olerast67/emotion-keychain/docs/hardware.md

[English](hardware.en.md) | Русский

# Железо и конструкция

Брелок rev B — это своя плата 30 × 46 мм с ушком для кольца, модуль экрана 0.96″ над ней на ушках акриловых рамок и ячейка Li-Po между ними. Всё вместе закрыто прозрачным акриловым «бутербродом». Здесь — что стоит на плате и почему. Как собрать и заказать плату — в [README платы](../hardware/rev-b/README.md), корпус — в [README корпуса](../hardware/rev-b/case/README.md), ток и автономность — в [энергобюджете](power.md).

| Вариант | Что внутри | Статус |
|---|---|---|
| **A** | Стандартный модуль SSD1306 + плата-носитель с Seeed XIAO nRF52840 Sense | ранний план прототипа; не делался, запасной путь |
| **B** | Стандартный модуль SSD1306 + своя плата: модуль nRF52840, зарядник, датчики | **rev B готова к заказу** — [`hardware/rev-b`](../hardware/rev-b/README.md) |
| **C** | Одна своя плата с голой панелью экрана на разъёме FPC | rev C в [плане](plan.md): полностью заводская сборка |

Вариант A пропустили: прошивку платы rev B целиком проверяет [симуляция платы](../firmware/README.md#симуляция-платы-целиком), а лица на живой панели — стенд на ESP32.

## Плата rev B

Плата rev B: лицевая сторона и оборот

| Параметр | Rev B |
|---|---|
| Размер | 30 × 46 мм и ушко R4.5 с отверстием 3.2 мм без металлизации, 4 слоя, 1.6 мм, ENIG, чёрная маска |
| Слои | L1 и L4 — детали и сигналы, L2 — сплошная земля, L3 — шины питания 0.4/0.3 мм и медленные сигналы |
| Микроконтроллер | модуль Raytac MDBT50Q-1MV2 (nRF52840) с чип-антенной у правого края, без меди под ней |
| Питание | MCP73832 (100 мА, заряд разрешает прошивка), разделение USB и батареи на диоде и P-MOSFET, 3.3 В от REG0 модуля |
| Защита USB | TVS SMF5.0A на VBUS (от импульсов и статики), USBLC6 на D+/D− |
| Датчики и отдача | LIS3DH, LTR-303ALS, PDM-микрофон SPH0641, пищалка PKMCS0909E, вибромотор на ключе, боковая кнопка |
| Связь и отладка | USB-C с CC-резисторами, площадки Tag-Connect TC2030 для SWD |
| Экран | модуль 0.96″ по I2C над ячейкой, на ушках рамок корпуса, питание через ключ |
| Ячейка | 402025, 502025 или 602025 с платой защиты — версии корпуса S, M, L |
| Проверка | DRC — 0 ошибок, 0 несоединённых, 0 предупреждений; прошивка прогоняется в симуляции платы целиком |

### Цели

| Цель | Сейчас |
|---|---|
| Автономность ≥5 дней при 16 ч лица и 8 ч темноты в сутки | по симуляции ≈3, ≈4.3 и ≈5.4 дня в версиях S, M, L; обычный день — 11–18 дней ([энергобюджет](power.md)) |
| Зарядка от USB-C током не выше 1C | 100 мА — не больше 0.7C при номинальной ёмкости 150–250 мА·ч, только при 10–42 °C |
| Падение с 1–1.5 м, рывок за ушко 5–10 кг, брызги | тесты впереди (этап 7 [плана](plan.md)) |

### Ножки и шины

| Сигнал | Ножка | Куда |
|---|---|---|
| SENS_SDA, SENS_SCL | P0.27, P0.01 | шина датчиков (Wire): LIS3DH 0x19, LTR-303 0x29, подтяжки 10 кОм |
| ACC_INT1, ACC_INT2 | P0.04, P0.17 | прерывания LIS3DH: касание (CLICK) и запасное |
| ALS_INT | P0.00 | прерывание LTR-303 |
| PDM_CLK, PDM_DATA, MIC_PWR | P0.06, P0.08, P1.09 | микрофон; питание — с ножки, выключается целиком |
| DISP_SCL, DISP_SDA | P0.13, P0.15 | своя шина экрана (Wire1), SSD1306 на 0x3C или 0x3D |
| DISP_EN | P0.19 | ключ питания экрана, высокий — включён |
| VIB_EN | P0.21 | ключ мотора, ШИМ 20 кГц |
| CHG_IO | P0.20 | статус зарядника, 0 — заряжается |
| CHG_EN | P0.24 | разрешение заряда: 0 — заряд, отпущена — без заряда |
| BTN | P0.22 | кнопка на землю |
| BUZ_A, BUZ_B | P0.25, P1.02 | пищалка мостом через 1 кОм |

Обе шины I2C работают на 390 кГц: на 400 кГц TWIM nRF52840 нарушает тайминги (errata 219). Кварца 32 кГц нет, часы идут от внутреннего RC-генератора, поэтому P0.00 и P0.01 — обычные ножки. Номера ножек записаны в `GPIO` из [`netlist.py`](../hardware/rev-b/gen/netlist.py) и в [`board.h`](../firmware/src/keychain/board.h) прошивки.

## Микроконтроллер: nRF52840

Лицо горит постоянно, а процессор почти всё время ждёт следующего кадра или события. Поэтому важнее всего ток в паузах, а не пиковая производительность.

- **nRF52840:** ожидание с таймером и сохранением RAM — 1.5–2.4 мкА, при работе на 64 МГц — около 3.3 мА. Есть FPU, PDM-интерфейс для микрофона и BLE для встреч брелоков.
- **ESP32-C3** в лёгком сне берёт 130–190 мкА, это в 50–100 раз больше. FPU у него нет. Остаётся запасным вариантом, если понадобится Wi-Fi.
- **Модуль, а не голый чип.** В MDBT50Q-1MV2 уже есть антенна, кварц 32 МГц и обвязка регуляторов. Своя антенна на плате 30 мм — лишний риск.
- **Питание модуля.** VDDH берёт питание системы (VSYS, 2.5–5.5 В), а встроенный регулятор REG0 выдаёт 3.3 В на VDD для модуля и датчиков. Отдельный LDO не нужен: нагрузка 3–4 мА при пределе REG0 25 мА. На чистом чипе REG0 даёт 1.8 В; 3.3 В записывает в UICR заводской файл прошивки или загрузчик.
- **Ёмкость на VDD** — 4.7 мкФ и четыре по 100 нФ, всего 5.1 мкФ: Nordic для REG0 допускает не больше ~5.5 мкФ.
- **USB** — встроенный в nRF52840: диск KEYCHAIN для обновления прошивки, консоль. По выводу VBUS модуль узнаёт, что USB подключён.

## Экран

- **Белый SSD1306 0.96″, стандартный модуль на 4 штыря I2C.** Белая панель стареет медленнее голубой.
- **Почему I2C, а не SPI.** Модули на 4 штыря — самые распространённые, а движок шлёт на экран только изменённые окна. На 400 кГц полный кадр (1 КБ) идёт ≈23 мс, окно двух глаз (~256 Б) ≈6 мс — для лица этого хватает. Выше 400 кГц не поднять: этого не поддерживают ни интерфейс nRF52840, ни контроллер дисплея.
- **Своя шина и ключ питания.** У экрана своя шина Wire1, а питание идёт через P-MOSFET Q2 от VSYS. Прошивка выключает экран целиком, а не только гасит его: чёрный, но включённый экран берёт 0.5–1.4 мА. Перед выключением ключа прошивка отпускает SDA и SCL, чтобы модуль не подпитывался через подтяжки. Конденсатор между затвором и стоком Q2 включает ключ плавно, без большого броска тока.
- **Модули с маркетплейсов не одинаковые.**
  - Под видом SSD1306 бывают SH1106 (сдвиг на 2 столбца и мусор у края) и SSD1315. Прошивка платы ждёт SSD1306; адрес 0x3C или 0x3D она находит сама.
  - Порядок питания на штырях бывает `GND VCC` и `VCC GND`. Его выбирают перемычки 0 Ом R16–R19 на обороте: завод ставит вариант `GND VCC`.
  - Модуль нужен с LDO на плате (662K / XC6206): на него приходит VSYS, а это до ~5.4 В от USB.
  - Поэтому покупаем у 2–3 продавцов и сверяем размеры, контроллер и распиновку до пайки. Контроллер по надписям не узнать: модуль проверяют на стенде ESP32 ([как](../hardware/rev-b/README.md#что-сверить-перед-заказом)).
- **Яркость около 60 кд/м²**, на солнце лицо читается хуже. Прошивка ставит контраст по уровню из поведения: обычный, 1/4 ночью и во сне, 1/16 в темноте.

## Датчики

| Что | Деталь | Как подключена | Зачем |
|---|---|---|---|
| Движение | LIS3DH, акселерометр ±4 g | шина датчиков, 0x19 (SA0 на VDD), касания — на INT1 | тап и двойной тап, тряска, падение, переворот, шаги, наклон взгляда |
| Звук | SPH0641LM4H-1, PDM-микрофон с портом снизу | звук — через отверстие 0.5 мм в плате и 1.2 мм в крышке корпуса; питание с ножки | «слушает», испуг от хлопка, музыка, речь |
| Свет | LTR-303ALS | шина датчиков, 0x29, смотрит вперёд | яркость экрана, темнота в кармане, ночь |
| Кнопка | Omron B3U-3100P, боковая | на правом торце, толкатель в корпусе | включение, выключение, дуэли (два нажатия), звук (три нажатия), загрузчик |
| Температура | датчик кристалла nRF52840 | внутри модуля | холодно, жарко; можно ли заряжать |
| Батарея | делитель VDDHDIV5 внутри nRF52840 | без внешних деталей | процент заряда, экорежим, выключение на пустой ячейке |

- **SA0 акселерометра — на VDD.** У этого вывода внутренняя подтяжка к VDD. На земле через неё всё время, даже в выключенном брелоке и в загрузчике, шло бы 0.11–0.16 мА — столько же, сколько весь брелок в кармане. Прошивка ещё и отключает подтяжку (CTRL_REG0 = 0x90).
- **Датчик света смотрит вперёд**, туда же, куда экран: на сумке задний датчик видел бы только ткань. Он меряет разово, раз в 2 с.
- **Микрофон** слушает, только пока брелок бодрствует: в кармане, ночью и в экорежиме его питание выключено. Свою пищалку и свой мотор микрофон не слышит: пока они работают и 150 мс после, звук не считается. Толчки своего мотора — не касания: пока он работает и 150 мс после, тряска, удар, падение и касания не считаются.

### Звук и вибро

| Что | Деталь | Как подключена | Ток |
|---|---|---|---|
| Пищалка | пьезо PKMCS0909E 9×9 мм без генератора | мостом на двух ножках через 1 кОм: в противофазе громко, с одной ножки тихо | 0 в покое, единицы миллиампер во время звука |
| Вибромотор | монетка 0820 (Ø8 × 2 мм, 3 В), на клейком слое | ключ AO3400A с диодом от VSYS, ШИМ 20 кГц со скважностью 3 В / VSYS | 0 в покое, ~60 мА импульсами по 50–200 мс |

Звук и вибро короткие и редкие, на средний ток почти не влияют. Движок выдаёт ноты (`sound.h`), прошивка играет их ШИМом. Подробно — в [голосе брелока](sound.md).

## Питание

- **Ячейка Li-Po 20 × 25 мм с платой защиты (PCM):**
  - 402025 — ~150 мА·ч, 4 мм, версия S;
  - 502025 — ~200 мА·ч, 5 мм, версия M;
  - 602025 — ~250 мА·ч, 6 мм, версия L.

  Ёмкость на этикетке дешёвых ячеек часто завышена, а толщина — больше номинала. Перед покупкой партии смерьте образец, ёмкость проверьте разрядом. В паспорте ячейки максимальный ток заряда — не меньше 100 мА ([паспорт ячейки](../hardware/rev-b/case/README.md#как-выбрать-ячейку)). Правило толщины — в [README платы](../hardware/rev-b/README.md#стек-и-размеры). Провода ячейки паяются на площадки, разъёма нет. Защиты от переполюсовки на плате тоже нет, поэтому ячейка — только с платой защиты.
- **Зарядка — MCP73832, 4.2 В, 100 мА:** при номинальной ёмкости 150–250 мА·ч это не больше 0.7C.
  - Входа термистора у MCP73832 нет. Поэтому нижний конец резистора PROG идёт на ножку nRF (CHG_EN), и заряд включает прошивка: только при температуре кристалла 10–42 °C, с остановкой ниже 7 °C и выше 45 °C. Проверка — при подключении USB и дальше раз в 30 с.
  - Почему запас у холода такой большой. На морозе литиевую ячейку заряжать нельзя: литий оседает на аноде, и ячейка портится. А датчик кристалла по документации Nordic ошибается до ±5 °C, и на USB кристалл ещё на несколько градусов теплее ячейки: его греют зарядник и сам nRF. Порог 10 °C по кристаллу держит ячейку дальше от нуля даже при худшей ошибке. Гарантию даст только термистор у ячейки — он в rev C. У жары кристалл ошибается в безопасную сторону: он теплее ячейки.
  - Без прошивки заряда нет, а брелок при этом питается от USB.
  - Статус заряда приходит на ножку через делитель 10 кОм / 47 кОм: «1» не выше 3.3 В при VBUS до 5.5 В.
  - Слабый USB, ниже ~4.6 В на VBUS: «1» может не дотянуть до порога ножки, и законченный заряд прошивка читает как «заряжается». Это только видимость: сцена «заряжен» не появится, а сам зарядник заканчивает заряд правильно. Конец заряда видно по светодиоду.
  - Плата без прошивки на USB (VDD 1.8 В): «1» выше предела ножки VDD + 0.3 В, в её защитный диод через R5 идёт до ~0.13 мА. Это длится только до первой прошивки, которая ставит 3.3 В, и ножке не вредит; непрошитую плату на USB надолго не оставляют.
- **Разделение питания USB и батареи.** От USB система питается через диод Шоттки (VSYS до ~5.4 В), от батареи — через открытый P-MOSFET почти без потерь. Отдельного ключа нагрузки и LDO нет: экран отключает свой ключ, 3.3 В даёт REG0.
- **USB-C:** резисторы 5.1 кОм на CC, USBLC6 — от статики на линиях данных.
  - **TVS SMF5.0A на VBUS** — от импульсов и статики: пробой 6.4–7.1 В.
  - **Звон при горячем подключении он не гасит.** Индуктивность короткого кабеля с керамикой на VBUS звенит, и по модели ngspice VBUS и VSYS на короткое время уходят выше предела модуля 5.8 В (VBUS и VDDH). Так бывает с коротким толстым кабелем от зарядника, у которого 5 В на гнезде есть всегда (USB-A); зарядник USB-C с кабелем C–C включает 5 В плавно и только после подключения. TVS начинает проводить выше этого предела. Лечится это демпфером у разъёма — RC-цепочкой или конденсатором с потерями ~0.5–1 Ом и ≥10 мкФ; он в плане rev C. Одних 10 Ом перед выводом VBUS модуля мало: VDDH и зарядник они не защищают.
  - **Проверка на первой плате:** осциллограф на VBUS и VSYS, горячее подключение коротким кабелем ([как](../hardware/rev-b/README.md#на-первых-платах)). Для своих прототипов rev B риск принят; перед продажей замер обязателен.
- **Выключение — полное:** System OFF, датчики в сне, микрофон и экран обесточены. Брелок в нём берёт 6–17 мкА по типовым значениям даташитов; предел на проверке первой платы — 25 мкА.

## Конструкция

### Стек, вид сбоку (спереди назад)

```
  ┌─ ушко: выступ платы над модулем экрана, датчик света на его лицевой стороне
  ▼
[ крышка: прозрачный акрил ]
[ стекло OLED ]                                      ← модуль 0.96", ≈4 мм вместе с платой
[ плата модуля ]
   ║ штыри 2.54 мм сквозь плату       ║ ушки двух рамок ячейки: 6, 7 или 8 мм (S, M, L)
[ ячейка 402025 / 502025 / 602025 на тонком двустороннем скотче ]   ← в рамке из акрила
[ плата rev B, FR4 1.6 мм, чёрная маска, ENIG ]
[ детали оборота: USB-C на нижнем торце, кнопка на правом, пищалка, мотор ]   ← в рамке оборота
[ дно: прозрачный акрил, отверстие Ø3 мм над пищалкой ]
```

Корпус — 35 × 51 мм (у кнопки рамка оборота выходит приливом на 0.8 мм, толкатель — ещё на 0.5 мм), слои акрила стянуты четырьмя нейлоновыми винтами M2 × 25. Толщина и раскрой каждой версии — в [README корпуса](../hardware/rev-b/case/README.md).

### Детали, которые важны для прочности

- **Ушко.**
  - Выступ платы из FR4 1.6 мм, полукруг R4.5, отверстие 3.2 мм под разъёмное кольцо, без металлизации: кольцо держится на самом стеклотекстолите, до края ≈2.9 мм материала.
  - Вокруг отверстия в радиусе 3 мм нет меди ни на одном слое, чтобы кольцо ничего не замкнуло и не истёрло.
  - Проверка: рывок 5–10 кг (этап 7 [плана](plan.md)).
- **Ячейка** закрыта со всех сторон: сзади плата, спереди модуль экрана и прозрачная крышка, по бокам — рамки корпуса. У разъёма USB-C её торец закрывает нижняя рамка ячейки: окна под вилку в ней нет, вилка до ~6.4 мм проходит под рамкой ([вилка USB-C](../hardware/rev-b/case/README.md#слои-от-лица-к-обороту)). Острых выводов рядом быть не должно: ножки USB-C выходят на лицевую сторону прямо под ячейку, их откусывают, спиливают почти заподлицо и закрывают каптоном.
- **Шлейф экрана** на нижнем торце модуля — самое хрупкое место. Рамка экрана его не зажимает. При сборке шлейф закрывают узкой полоской каптона ([шаг 5 сборки](../hardware/rev-b/case/README.md#сборка)), капля UV-клея по краю стекла — по желанию. Нужно ли больше, решаем после тестов на падение (этап 7 [плана](plan.md)). В варианте C шлейф уходит под плату.
- **Кнопка** на правом торце (side-push), её нажимает толкатель из акрила с крыльями под платой: плата не даёт ему подняться и упереться в её край. **USB-C** на нижнем торце, корпус разъёма выходит за край платы на ~0.7 мм — в вырез корпуса.
- **Пищалка** звучит в дно, поэтому в дне против неё отверстие Ø3 мм. Брелок, который лежит на спине, звучит тише.
- **Отделка:** скруглённые углы R2, чёрная матовая маска, покрытие ENIG. Влагозащитное покрытие оборота (кроме разъёма, кнопки, отверстия микрофона и площадок программирования) и бампер для торцов стекла — решаем после тестов на брызги и падение.

## Как менялся план

Ранний план собирался до своей платы. Что на плате rev B вышло иначе:

| Было в плане | На плате rev B | Что из этого следует |
|---|---|---|
| Ячейка 20 × 30 мм, 250–400 мА·ч; брелок ≈27 × 33 мм | ячейка 20 × 25 мм, 150–250 мА·ч; плата 30 × 46 мм, корпус 35 × 51 мм | под модулем экрана 27 × 28 мм помещается ячейка 20 × 25, а модуль nRF, датчики и кольцо заняли верхние 18 мм. Автономность меньше ранних таблиц — см. [энергобюджет](power.md) |
| LIS2DW12, микрофон T5838 со своим детектором звука, NTC на ячейке | LIS3DH, PDM-микрофон SPH0641 с питанием от ножки, температура кристалла nRF | микрофон без детектора звука, поэтому в кармане и ночью он выключен. Температуру ячейки никто не меряет: заряд разрешается по температуре кристалла через CHG_EN. NTC и зарядник со входом термистора — в rev C |
| BQ25180 или MCP73831, LDO TPS7A02, ключ TPS22916 | MCP73832, REG0 модуля, ключ экрана на AO3401A и AO3400A | 3.3 В даёт REG0 (нагрузка 3–4 мА из 25); транзисторы ключа — базовые детали JLCPCB |
| Экран на SPI, 7 штырей | стандартный модуль I2C на 4 штыря | полный кадр ≈23 мс вместо ≈1 мс; движок шлёт только изменённые окна, и этого хватает |
| Передачи на экран через EasyDMA со сном ядра | Wire передаёт через TWIM (EasyDMA), но ядро ждёт конца передачи | сон ядра во время передачи — среди улучшений в [энергобюджете](power.md) |
| Металлизированное отверстие или латунная втулка в ушке | отверстие 3.2 мм без металлизации, вокруг нет меди | держит стеклотекстолит; проверка рывком впереди |
| Открытые платы без корпуса | акриловый «бутерброд» S, M, L | ячейка закрыта, платы видно насквозь |

## Закупки для сборки

| Что | Сколько | Зачем |
|---|---|---|
| Платы rev B со сборкой (JLCPCB или PCBWay) | у JLCPCB: PCB — 5 панелей (меньше не заказать), из них со сборкой 3 = 6 плат (PCBA — от 2 панелей) | монтаж заказывают панелями: 2 платы на панели 76 × 72 мм, «Panel by Customer» из `hardware/rev-b/out/panel`; номер заказа — «Order Number (Specify Position)», он ляжет под ячейку ([панель](../hardware/rev-b/README.md#панель-для-монтажа), [заказ](../hardware/rev-b/README.md#заказ-на-jlcpcb)) |
| Модуль OLED 0.96″ SSD1306, I2C, 4 штыря, **белый**, с LDO; порядок штырей `GND VCC` (`VCC GND` тоже подойдёт — тогда перепайка R16/R18, [шаг 2 сборки](../hardware/rev-b/case/README.md#сборка)); для M и L — без впаянной гребёнки | по 2–3 от 2–3 продавцов | экраны, проверка разброса модулей |
| Ячейки 402025, 502025 или 602025 с платой защиты | по 2 на брелок | под версию корпуса; толщину смерить до покупки партии |
| Вибромотор-монетка 0820, 3 В | по 1 на брелок | вибро |
| Винты M2 × 25 нейлоновые с цилиндрической головкой (DIN 84) и гайки M2 нейлоновые — для всех версий; нейлоновых M2 × 25 не найти — стальные M2 × 22 (S) или M2 × 25 (M, L), гайки нейлоновые; для брелоков на продажу — только нейлон | по 4 на брелок | стек и корпус; [что купить](../hardware/rev-b/case/README.md#что-купить) |
| Гребёнка 2.54 (для M и L длинная, от 15 мм), силиконовая трубка 1 × 2 мм | по [списку корпуса](../hardware/rev-b/case/README.md#что-купить) | экран и микрофон |
| Акрил под лазерную резку | по [списку корпуса](../hardware/rev-b/case/README.md) | корпус |
| Raspberry Pi Pico или Pico 2 (без W) — программатор с прошивкой debugprobe, ~$4–6 | 1 | первая прошивка по SWD, если завод не прошивает сам; [как](../firmware/README.md#основной-программатор-raspberry-pi-pico) |
| Модуль преобразователя уровней на TXS0108E, ~$1–2; провода Dupont до 10 см, кабель micro-USB с данными | 1 | между Pico (3.3 В) и платой (1.8 В до первой прошивки) — обязательно |
| Кабель Tag-Connect TC2030-CTX-NL и переходник с 10 контактов 1.27 мм на штыри 2.54 мм — или тонкие провода, припаянные к J3; по желанию — фиксатор TC2030-CLIP для кабелей NL | 1 | подключение к J3 |
| **Nordic Power Profiler Kit II** | 1 | замер тока: без него энергобюджет — оценка |
| Штангенциркуль, линейка, паяльник с тонким жалом, припой, флюс, оплётка, пинцет, лупа, мультиметр, бокорезы (кусачки заподлицо), надфиль и наждачка, губка или пенопласт | — | сборка и замеры |
| Перемычки 0 Ом 0402 | по 2 на брелок, только для модулей `VCC GND` | R17 и R19 вместо R16 и R18; можно переставить снятые R16 и R18 |
| Клеевая плёнка без основы до 0.06 мм (например, 3M 467MP) | — | обе части рамки оборота — к дну ([шаг 16](../hardware/rev-b/case/README.md#сборка)) |
| Кабель USB-C с обычной вилкой, корпус вилки не толще 6.4 мм, с данными | 1–2 | зарядка и консоль; толстая вилка упирается в нижнюю рамку ячейки |
| Каптон, тонкий двусторонний скотч; UV-клей — по желанию | — | крепление ячейки, защита шлейфа |
| Разъёмные кольца и карабины | несколько | механические тесты |

**Программатор.** Плата до первой прошивки работает при 1.8 В ([README платы](../hardware/rev-b/README.md#программатор-swd)).

- **Основной — Raspberry Pi Pico с официальной прошивкой [debugprobe](https://github.com/raspberrypi/debugprobe)** (`debugprobe_on_pico.uf2` или `debugprobe_on_pico2.uf2` со страницы выпусков, записывается через BOOTSEL) и pyOCD на компьютере. Pico выдаёт только 3.3 В, поэтому между ним и J3 — модуль TXS0108E: сторона A питается от VTref платы (J3, площадка 1), сторона B — от 3V3 Pico. 3V3 Pico с площадкой 1 J3 не соединять; брелок питается от своего USB-C. Pico делает всё: первую прошивку загрузчика с приложением, стирание и снятие защиты, перепрошивку потом; после первой прошивки обновления идут по USB. На этой плате связка ещё не проверялась — сначала одна плата. Схема и команды — в [README прошивки](../firmware/README.md#основной-программатор-raspberry-pi-pico).
- **Другой вариант — J-Link EDU Mini V2:** уровни по VTref держит сам, кабель TC2030-CTX-NL втыкается в него прямо. По лицензии SEGGER — только для некоммерческого использования, для брелоков в подарок подходит.
- **Кабель NL — без защёлок:** у J3 нет отверстий под фиксаторы. Вилку прижимают к J3 рукой всё время прошивки или ставят фиксатор TC2030-CLIP ([как](../firmware/README.md#подключение-к-j3)). С Pico можно и без кабеля: тонкие провода, припаянные к площадкам J3.
- **Без своего программатора:** завод прошивает платы сам (PCBWay — «Firmware loading»). Файл для прототипов — `keychain-revb-factory.hex` из `firmware/release/`. Для брелоков на продажу — только `firmware-factory.hex` своей сборки со своими VID/PID (раздел `[sale]` в `firmware/platformio.ini`); в файлах `release/` номера Adafruit ([README прошивки](../firmware/README.md#первая-прошивка-загрузчик-по-swd)).

Для стенда на ESP32 — свой список в [README прошивки](../firmware/README.md#что-нужно).
