olerast67/emotion-keychain/DONATE.md

# Support Emotion keychain · Поддержать брелок с эмоциями

Emotion keychain is free and open source: no ads, no paid features, no accounts. Donations pay for test boards, parts and the time to get the rev B keychain tested on real hardware. Thank you!

Брелок с эмоциями бесплатный и открытый: без рекламы, платных функций и аккаунтов. Донаты идут на тестовые платы, детали и время, чтобы проверить брелок rev B на живом железе. Спасибо!

## 💛 Boosty

| | |
|---|---|
| **[One-off donation · Разовый донат](https://boosty.to/olerast/donate)** | Cards from most countries; in Russia also Mir cards and SBP · Карты большинства стран, в России — «Мир» и СБП |
| **[Monthly support · Подписка](https://boosty.to/olerast)** | Support every month and follow the news · Поддержка каждый месяц и новости проекта |

## Crypto · Криптовалюта

Send **only USDT on the TRON network (TRC20)** to this address. Coins sent on another network (Ethereum, BNB Chain…) are lost for good.

Отправляй на этот адрес **только USDT в сети TRON (TRC20)**. Монеты из другой сети (Ethereum, BNB Chain…) пропадут безвозвратно.

| Coin | Network | Address |
|---|---|---|
| USDT | **TRON (TRC20)** | `TLS1C2LbbfAtzBQMyU9gppCS8qEXsYeyzQ` |

## Other ways to help · Как ещё помочь

- Star the repository: it helps other makers find it. · Поставь звезду репозиторию — так его найдут другие.
- Build the ESP32 stand and tell how it went, even when everything works. · Собери стенд на ESP32 и расскажи, как прошло, даже если всё работает.
- Suggest new emotions and scenes, or help with translations. · Предлагай новые эмоции и сцены, помогай с переводами.

## Goals · Цели

- [x] Open licences, English docs, web simulator · Открытые лицензии, документы на английском, веб-симулятор
- [ ] First batch of rev B boards assembled and tested · Первая партия плат rev B собрана и проверена
- [ ] Bluetooth encounters checked between real stands and keychains · Встречи по Bluetooth проверены на живых стендах и брелоках
- [ ] More interface languages · Больше языков интерфейса

Donations are voluntary gifts. They don't buy features, devices or support obligations, and the project stays the same for everyone.

Донаты — добровольные подарки. Они не покупают функции, устройства или поддержку, проект для всех одинаковый.
