olerast67/emotion-keychain/docs/emotions.en.md

# Emotion catalog

Generated by `facegen catalog --lang en docs/emotions.en.md` from `engine/src/expressions.cpp`; do not edit by hand. Emotions: 139. Russian version: [emotions.md](emotions.md).

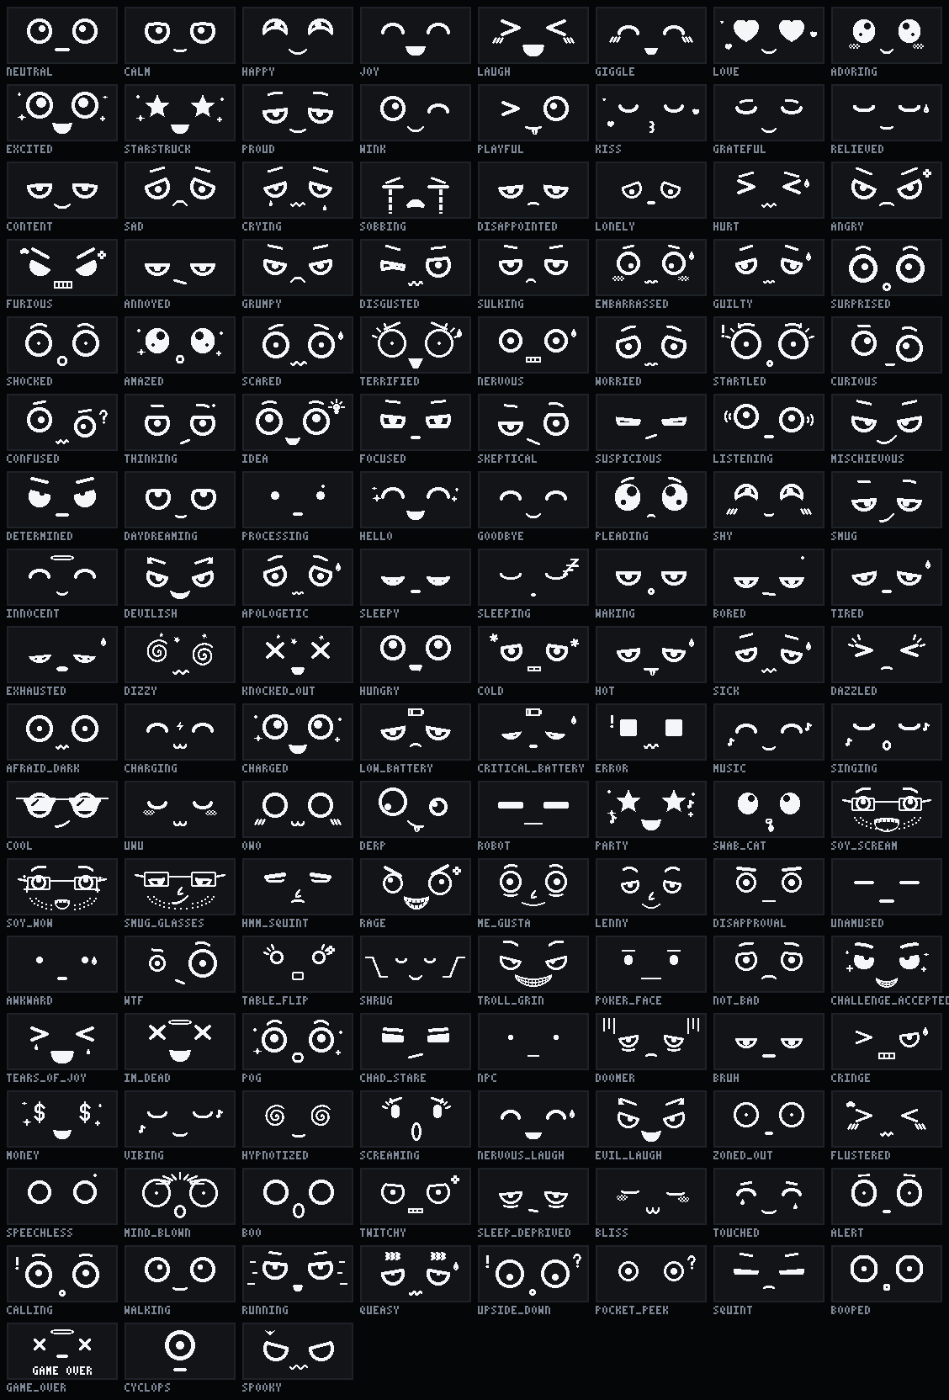
[picture p7: docs/img/emotions_sheet.gif]
All emotions


## Positive (19)

| id | Emotion | When it appears | Then |
|---|---|---|---|
| `neutral` | Neutral | Default state: nothing special is happening. | stays |
| `calm` | Calm | Quiet, bright, nobody has touched it for a few minutes. | stays |
| `happy` | Happy | Something nice: petted, picked up, in a good mood. | stays |
| `joy` | Joy | Feeling great: lots of attention in a row, fully charged, morning after sleep. | → `happy` after 5.0 s |
| `laugh` | Laughing | Double tap, tickling (quick light taps), a funny sound. | → `happy` after 3.5 s |
| `giggle` | Giggling | A light tap in a good mood; laughter fading out. | → `happy` after 2.5 s |
| `love` | In love | Long attention: held, petted, many taps in a good mood. | → `adoring` after 6.0 s |
| `adoring` | Adoring | After “in love”: warm, calm attention. | stays |
| `excited` | Excited | A walk begins, running, a new place, expecting something good. | → `happy` after 4.0 s |
| `starstruck` | Starstruck | Something amazing: an easter egg, a special date, a rare event. | → `happy` after 4.0 s |
| `proud` | Proud | Carried for a long time without falls, a step “record”, praised with the button. | → `happy` after 4.0 s |
| `wink` | Wink | A greeting, reply to a single tap, a random prank. | → `happy` after 1.8 s |
| `playful` | Playful | Playful mood, reply to tickling, sticking its tongue out. | → `happy` after 3.0 s |
| `kiss` | Kiss | Tenderness: held in a palm for a long time, an evening after a good day. | → `adoring` after 2.5 s |
| `grateful` | Grateful | Put on charge while hungry; helped up after a fall. | → `happy` after 2.6 s |
| `relieved` | Relieved | Shaking stopped, light again after darkness, charging after “hunger”. | → `calm` after 3.0 s |
| `content` | Content | Well fed (charged), calm surroundings, after something nice. | stays |
| `bliss` | Bliss | Held calmly in a palm, warm soft touches in a row. | → `content` after 6.0 s |
| `touched` | Touched | Picked up after a long separation (2+ hours alone). | → `happy` after 3.0 s |

## Negative (14)

| id | Emotion | When it appears | Then |
|---|---|---|---|
| `sad` | Sad | Not touched for a long time, treated roughly, crying fading out. | stays |
| `crying` | Crying | After a hard hit or long loneliness; when “sobbing” calms down. | → `sad` after 6.0 s |
| `sobbing` | Sobbing | Really hurt or offended: a fall from a height, long shaking, “T_T”. | → `crying` after 4.0 s |
| `disappointed` | Disappointed | Expected a reaction (tapped back, silence), unplugged before fully charged. | → `neutral` after 5.0 s |
| `lonely` | Lonely | Several hours without movement or attention in the light. | stays |
| `hurt` | Ouch | A hit, a fall to the floor, a sharp jolt. | → `sad` after 1.8 s |
| `angry` | Angry | Shaken for a long time, many taps in a row after “annoyed”. | → `annoyed` after 5.0 s |
| `furious` | Furious | Still shaken or poked while already angry. | → `angry` after 4.0 s |
| `annoyed` | Annoyed | Third or fourth tap in a row, woken at night, kept from sleeping. | → `neutral` after 5.0 s |
| `grumpy` | Grumpy | Woken too early, a cold morning, a bad mood. | stays |
| `disgusted` | Disgusted | Wet, dirty, an unpleasant harsh noise, “ew”. | → `neutral` after 3.0 s |
| `sulking` | Sulking | Ignored for a long time, then tapped: “not talking to you”. | → `neutral` after 6.0 s |
| `embarrassed` | Embarrassed | Dropped in public, turned upside down, loud laughter nearby. | → `neutral` after 3.5 s |
| `guilty` | Guilty | Woke someone at night, ran out of battery at a bad time, after a mistake. | → `neutral` after 4.0 s |

## Surprise and fear (8)

| id | Emotion | When it appears | Then |
|---|---|---|---|
| `surprised` | Surprised | An unexpected tap, a sudden medium-loud sound, someone picked it up. | → `curious` after 2.2 s |
| `shocked` | Shocked | A very loud bang, a hard hit, a fall from a height. | → `scared` after 2.5 s |
| `amazed` | Amazed | Something beautiful: bright light after darkness, music, a new place. | → `happy` after 3.5 s |
| `scared` | Scared | Free fall, sudden darkness, a loud sound at night. | → `worried` after 3.5 s |
| `terrified` | Terrified | A fall from a great height, very hard shaking. | → `scared` after 2.5 s |
| `nervous` | Nervous | Low battery, noisy and crowded, a long time in a dark bag. | stays |
| `worried` | Worried | After a scare, battery running out, something went wrong. | stays |
| `startled` | Startled | A sharp jolt or a loud sound: an instant reaction. | → `surprised` after 1.2 s |

## Thoughts and attention (12)

| id | Emotion | When it appears | Then |
|---|---|---|---|
| `curious` | Curious | A new place, an unfamiliar sound, after a surprise. | → `neutral` after 5.0 s |
| `confused` | Confused | Turned upside down, a strange sequence of taps. | → `neutral` after 4.0 s |
| `thinking` | Thinking | A pause between events, “deciding” what to do next. | stays |
| `idea` | Idea! | After “thinking”; came up with a game; an easter egg. | → `happy` after 2.2 s |
| `focused` | Focused | Listening closely, “looking” at something, steady walking. | stays |
| `skeptical` | Skeptical | “Oh really?”: after a strange action or a repeated tap. | → `neutral` after 4.0 s |
| `suspicious` | Suspicious | “¬_¬”: someone is sneaking up, a quiet touch, a strange sound. | → `neutral` after 4.0 s |
| `listening` | Listening | Speech or a steady sound nearby. | stays |
| `mischievous` | Mischievous | Planning a prank, before an “easter egg”, after laughing. | → `happy` after 4.0 s |
| `determined` | Determined | Fast walking, climbing stairs, “let's go!”. | stays |
| `daydreaming` | Daydreaming | Calm for a long time, soft light, evening. | stays |
| `processing` | Processing | Power on, firmware update, connecting to a phone. | stays |

## Social (9)

| id | Emotion | When it appears | Then |
|---|---|---|---|
| `hello` | Hello! | Picked up after a break, power on, morning. | → `happy` after 2.5 s |
| `goodbye` | Bye! | Turned off with the button, going to sleep. | → `sleepy` after 2.5 s |
| `pleading` | Pretty please | Hungry (low battery), begging for attention after long loneliness. | stays |
| `shy` | Shy | Gentle attention, a compliment (soft taps), meeting someone new. | → `happy` after 4.0 s |
| `smug` | Smug | After a “win”: got its charge, guessed right, survived the shaking. | → `neutral` after 4.0 s |
| `innocent` | Innocent | “It wasn't me”: after a prank, after being dropped. | → `happy` after 4.0 s |
| `devilish` | Little devil | An easter egg, a night-time prank, reply to a triple tap. | → `mischievous` after 4.0 s |
| `apologetic` | Apologetic | Missed an event, ran out of battery, “sorry”. | → `neutral` after 3.0 s |
| `calling` | Hey! (calling) | Ignored for a long time while the keychain is moving: calling its owner. | → `disappointed` after 15.0 s |

## States (14)

| id | Emotion | When it appears | Then |
|---|---|---|---|
| `sleepy` | Sleepy | Evening, dim light, no movement for a long time. | stays |
| `sleeping` | Asleep | Night, darkness, long inactivity (before the screen turns off). | stays |
| `waking` | Waking up | It got light, picked up, morning. | → `neutral` after 2.2 s |
| `bored` | Bored | Nothing has happened for 10+ minutes in the light. | stays |
| `tired` | Tired | A long walk, lots of shaking, late evening. | stays |
| `exhausted` | Exhausted | Running, very long shaking, battery almost empty. | stays |
| `dizzy` | Dizzy | Shaken hard and long, spun around. | → `tired` after 4.0 s |
| `knocked_out` | Knocked out | A fall onto something hard, a hit after free fall. | → `dizzy` after 3.5 s |
| `hungry` | Hungry | Battery at 15% or below: “I want to eat”, alternates with “low battery”. | stays |
| `cold` | Cold | Temperature sensor: below +5 °C. | stays |
| `hot` | Hot | Temperature sensor: above +38 °C, lying in the sun. | stays |
| `sick` | Unwell | Overheating, a sensor fault, long shaking in a vehicle. | stays |
| `dazzled` | Dazzled | Suddenly very bright: taken out of a bag into the sun. | → `neutral` after 2.0 s |
| `afraid_dark` | Afraid of the dark | Suddenly dark (put in a bag), right before falling asleep. | → `sleepy` after 3.0 s |

## System (5)

| id | Emotion | When it appears | Then |
|---|---|---|---|
| `charging` | Charging | USB plugged in: “eating”. | stays |
| `charged` | Charged | Charging complete. | → `content` after 3.0 s |
| `low_battery` | Low battery | Battery at 15% or below, alternates with “I want to eat”. | stays |
| `critical_battery` | Almost empty | Battery at 5% or below; when the cell runs dry, the keychain saves everything and turns off. | stays |
| `error` | Error | A sensor or screen fault, a failed update. | → `confused` after 3.0 s |

## Fun (11)

| id | Emotion | When it appears | Then |
|---|---|---|---|
| `music` | Music | The microphone hears a beat: sways in time. | stays |
| `singing` | Singing | Good mood and silence: humming to itself. | → `happy` after 5.0 s |
| `cool` | Cool | Bright sun, a fast ride, an easter egg. | → `smug` after 5.0 s |
| `uwu` | UwU | Gentle petting, cuteness. | → `adoring` after 4.0 s |
| `owo` | OwO | “What's this?”: interest plus cuteness. | → `curious` after 4.0 s |
| `derp` | Derp | After dizziness, a rare joke. | → `giggle` after 3.5 s |
| `robot` | Robot | Easter egg: “robot mode”, scanning the surroundings. | → `neutral` after 5.0 s |
| `party` | Party | Birthday, New Year, a special date. | → `happy` after 6.0 s |
| `game_over` | GAME OVER | Third fall in 10 minutes or a very hard hit. | → `waking` after 3.5 s |
| `cyclops` | Cyclops | A rare easter egg in a good mood (at most once every 2 hours). | → `neutral` after 3.0 s |
| `spooky` | Halloween | October 31, midnight, night-time easter eggs. | → `mischievous` after 5.0 s |

## Memes (39)

| id | Emotion | When it appears | Then |
|---|---|---|---|
| `swab_cat` | Cat with a cotton swab | Easter egg: staring without blinking, a swab in its mouth. | → `zoned_out` after 6.0 s |
| `soy_scream` | Screaming soyjak | “WOW!!!”: a loud sound, sudden music, a rare easter egg. | → `soy_wow` after 3.5 s |
| `soy_wow` | Amazed soyjak | Awe “like in a console ad”: music, a new place. | → `excited` after 4.0 s |
| `smug_glasses` | Smug guy in glasses | A condescending smirk: “I knew it”. | → `smug` after 5.0 s |
| `hmm_squint` | Hmm… | Squinting doubt: “meh…”. | → `skeptical` after 4.5 s |
| `rage` | FFFUUU | The last straw: shaken while already furious. | → `furious` after 3.5 s |
| `me_gusta` | Me gusta | Unexpectedly nice: a warm palm, favourite music. | → `content` after 5.0 s |
| `lenny` | Lenny ( ͡° ͜ʖ ͡°) | A sly hint, an easter egg, “you know what I mean”. | → `smug` after 5.0 s |
| `disapproval` | Disapproval ಠ_ಠ | Woken up, dropped, poked for no reason. | → `annoyed` after 5.0 s |
| `unamused` | Unamused -_- | Third tap in a row, a boring situation, “seriously?”. | → `bored` after 5.0 s |
| `awkward` | Awkward •_• | An awkward pause, a puzzling single tap. | → `neutral` after 4.0 s |
| `wtf` | What? o_O | “What was that?!”: a strange sound, a sudden movement. | → `confused` after 4.0 s |
| `table_flip` | Table flip | “That's it!”: after rage, when shaken again. | → `angry` after 2.5 s |
| `shrug` | Shrug | “Dunno”: a puzzling event, asked something with no answer. | → `neutral` after 3.5 s |
| `troll_grin` | Troll grin | After a successful prank, a rare easter egg. | → `mischievous` after 4.0 s |
| `poker_face` | Poker face | Pretends nothing happened: after a fall or a prank. | → `neutral` after 5.0 s |
| `not_bad` | Not bad | Approves: charged quickly, a good walk, nice music. | → `happy` after 3.5 s |
| `challenge_accepted` | Challenge accepted | A run begins, an uphill climb, “bring it on!”. | → `determined` after 3.5 s |
| `tears_of_joy` | Tears of joy | Really funny: a series of taps in a good mood. | → `giggle` after 3.5 s |
| `im_dead` | Dying of laughter | Couldn't be funnier: “I'm dead”. | → `tears_of_joy` after 3.5 s |
| `pog` | Pog! | Something awesome: charged to 100%, an easter egg. | → `excited` after 2.5 s |
| `chad_stare` | Sigma stare | Confidence: fast walking, bright sun. | → `determined` after 5.0 s |
| `npc` | NPC | “Background character” mode: nothing has happened for a long time. | → `neutral` after 6.0 s |
| `doomer` | Doomer | Late night, a long time in the dark, battery running out. | stays |
| `bruh` | Bruh | A weird action: turned over, shaken for no reason. | → `unamused` after 4.0 s |
| `cringe` | Cringe | Awkwardness: dropped in public, a loud sound in the silence. | → `embarrassed` after 3.0 s |
| `money` | \$_\$ | “Riches” easter egg: charged to 100%. | → `happy` after 3.0 s |
| `vibing` | Vibing | Music nearby and a good mood. | stays |
| `hypnotized` | Hypnotized | Spun around for a long time, flashing light. | → `dizzy` after 5.0 s |
| `screaming` | Screaming | A creepy sound, a fall, “A-A-A!”. | → `scared` after 2.5 s |
| `nervous_laugh` | Nervous laugh | Awkward but funny: dropped and picked up right away. | → `nervous` after 3.0 s |
| `evil_laugh` | Evil laugh | An easter egg, a night-time prank: “mwa-ha-ha”. | → `devilish` after 3.5 s |
| `zoned_out` | Zoned out | Staring at one point for a long time, a monotonous ride. | → `neutral` after 8.0 s |
| `flustered` | Flustered | Too much affection in a row. | → `shy` after 3.0 s |
| `speechless` | Speechless | Nothing to say: a strange or way too loud event. | → `neutral` after 4.0 s |
| `mind_blown` | Mind blown | Unbelievable: an easter egg, a special date. | → `amazed` after 3.0 s |
| `boo` | Boo! | Easter egg: scares you at night, “boo!”. | → `playful` after 3.0 s |
| `twitchy` | Eye twitch | On the edge: annoyance is building up but still holding. | → `annoyed` after 5.0 s |
| `sleep_deprived` | Sleep-deprived | Woken at night, too little sleep, the morning after a sleepless night. | stays |

## Sensor reactions (8)

| id | Emotion | When it appears | Then |
|---|---|---|---|
| `alert` | Alert | A new sound, someone took the bag, the first seconds of shaking in a vehicle. | → `curious` after 4.0 s |
| `walking` | Walking | The step counter sees walking: sways in time with the steps. | stays |
| `running` | Running | Running or climbing stairs. | stays |
| `queasy` | Motion-sick | A bumpy ride without steps for more than a couple of minutes. | stays |
| `upside_down` | Upside down | The keychain was flipped or is hanging upside down. | → `playful` after 2.0 s |
| `pocket_peek` | Who turned off the lights? | Suddenly dark: a pocket, a bag. | → `sleeping` after 6.0 s |
| `squint` | Squinting at the light | Taken out of a pocket into the light: eyes adjusting. | → `hello` after 1.4 s |
| `booped` | Boop! | A single tap: a short “oops” with the eyes bouncing. | → `neutral` after 0.7 s |
