olerast67/emotion-keychain/hardware/rev-b/case/README.md

[English](README.en.md) | Русский

# Корпус rev B: акриловый «бутерброд»

Слои акрила под лазерную резку, стянутые четырьмя винтами M2. Плата и экран видны через прозрачные крышку и дно, рамки закрывают торцы. Всё считается из той же платы `keychain-rev-b.kicad_pcb`, поэтому после изменения расстановки достаточно перезапустить скрипты. Здесь же — [вся сборка брелока](#сборка), от платы с завода до готового.

```sh
cd hardware/rev-b/case
python3 case.py                               # проверки и файлы резки S, M, L → out/, out/m/, out/l/
python3 case.py --sheet 3=2.86 --sheet 4=4.05 # то же по вашим листам (мера штангенциркулем)
python3 selftest.py                           # проверка проверок: нарочные поломки ловятся
python3 viewer.py                             # 3D-просмотр всех трёх версий → out/keychain-3d.html
python3 viewer.py --shots ../../../docs/img   # case-3d.png и case-exploded.png для README
python3 viewer.py --render ../../../docs/img/pcb-rev-b.png   # картинка платы для README
```

**Готовые файлы резки и `keychain-3d.html` уже лежат в `out/`** — на номинальные листы. Чтобы резать, скрипты запускать не нужно. Запуск нужен, если вы поменяли плату или `OLED` в `gen/footprints.py` или хотите пересчитать всё по своим листам: тогда `case.py` перепишет `out/`.

**Что нужно для скриптов.** Все работают в Python с модулем `pcbnew` из KiCad 7, как и [скрипты платы](../README.md) (в Linux это системный `python3`). `viewer.py` ещё нужны `kicad-cli`, Pillow и cairosvg: `pip install pillow cairosvg`, другой путь — в переменной `CAIROSVG`; подойдёт и `rsvg-convert`. Лицо на экран `viewer.py` берёт из `build/facegen` в корне репозитория (сборка движка, см. [README](../../../README.ru.md)) или из пути в `FACEGEN`. Для `--shots` нужен Node.js с Playwright (`shots.js`); если браузер не достаёт до CDN, укажите в `THREE_DIR` распакованный пакет npm `three@0.128.0`.

## Три версии: S, M, L

Плата, прошивка и раскрой платы у всех одинаковые. Различаются ячейка, верхняя рамка ячейки, а с ней высота под модулем экрана, трубка микрофона и гребёнка экрана. Брелок 35 × 51 мм, ушко с кольцом выходит сверху. Кнопка справа: у неё рамка оборота выходит приливом на 0.8 мм, толкатель — ещё на 0.5 мм.

| Версия | Ячейка | Обычный день | Толщина | Под модулем | Рамки ячейки | Винты | Гребёнка экрана | Файлы |
|---|---|---|---|---|---|---|---|---|
| S | 402025, ~150 мА·ч | ~11 дней | 18.8 мм | 6 мм | 3 + 3 мм | M2 × 25 | обычная | `out/` |
| M | 502025, ~200 мА·ч | ~15 дней | 19.8 мм | 7 мм | 3 + 4 мм | M2 × 25 | длинная, от 15 мм | `out/m/` |
| L | 602025, ~250 мА·ч | ~18 дней | 20.8 мм | 8 мм | 3 + 5 мм | M2 × 25 | длинная, от 15 мм | `out/l/` |

- **Стоек под модулем нет.** Модуль экрана лежит на ушках двух рамок ячейки, винты проходят сквозь них. Стопка рамок и есть проставка: её высота всегда равна высоте рамок, а покупать проставки не нужно.
- **Акрил только ходовой толщины:** 2, 3 и 4 мм для S и M, плюс 5 мм для L.
- **Винты у всех M2 × 25, нейлоновые:** нейлоновых M2 × 22 почти не продают. Лишнее откусывают после сборки ([что купить](#что-купить)).
- **Зарядник выдаёт 100 мА:** для всех трёх ячеек по номиналу это не больше 0.7C. Паспорт ячейки это должен разрешать ([как выбрать ячейку](#как-выбрать-ячейку)).

## Как выбрать ячейку

**Толщина.** Ячейка лежит на плате под модулем экрана. Свободная высота над ней — «под модулем» минус самая высокая деталь на обороте модуля. «Под модулем» — это две рамки ячейки стопкой: 6, 7 или 8 мм по номиналу. Деталь на обороте модуля — обычно стабилизатор SOT-23 высотой 1.1 мм, но бывает конденсатор 0805 высотой 1.45 мм: смерьте свой модуль. Ячейка подходит, если:

> толщина ячейки + 0.3 мм (каптон и скотч под ней) + 0.1 мм (каптон на обороте модуля над ней) + 0.3 мм (запас на вздутие) ≤ свободная высота

| Версия | Свободно под модулем | Ячейка не толще |
|---|---|---|
| S | 4.55 … 4.9 мм | 3.85 … 4.2 мм |
| M | 5.55 … 5.9 мм | 4.85 … 5.2 мм |
| L | 6.55 … 6.9 мм | 5.85 … 6.2 мм |

Первое число — для детали модуля 1.45 мм, второе — для 1.1 мм.

**Таблица — для номинальных листов, а листы акрила гуляют по толщине на ±0.1–0.3 мм** (литой — и больше). Поэтому до покупки ячейки смерьте штангенциркулем листы, из которых режете рамки ячейки (3 мм и 3, 4 или 5 мм), в нескольких местах, и пересчитайте: `python3 case.py --sheet 3=2.86 --sheet 4=4.05` напечатает свободную высоту, предел ячейки, длину трубки и винтов для ваших листов и перепишет файлы резки в `out/` под них (3D-просмотр после этого обновит `python3 viewer.py`). Без пересчёта: на каждые 0.1 мм, на которые две рамки ячейки вместе тоньше 6, 7 или 8 мм, предел ячейки падает на 0.1 мм.

Ячейки редко бывают тоньше номинала, чаще толще: 402025 по паспорту бывает до 4.5 мм. Номинальная 402025 (4.0 мм) входит в S, только если детали на обороте модуля не выше 1.3 мм, а две рамки ячейки вместе не тоньше 6.0 мм. Если не входит, берите корпус M. Толщину ячейки меряйте штангенциркулем в самом толстом месте, у платы защиты.

**Ширина** — не больше 20.7 мм вместе с плёнкой. Гнездо в рамках шириной 21.0 мм. Ушки рамок открыты к ячейке вилкой, поэтому её края упираются в стенки гнезда, а не в ушки и винты.

**Длина** — не больше 25.0 мм вместе с платой защиты. Гнездо длиннее на 0.6 мм; ячейку кладут вплотную к его нижней стенке, на 0.3 мм за нижний край платы. Сверху над ней пластик гребёнки экрана: при ячейке 25.0 мм остаётся около 0.5 мм.

**Выводы.** Нужна ячейка с платой защиты и тонкими проводами (около 30 AWG), выходящими из торца с платой защиты. Этот торец кладут вверх, к гребёнке экрана, провода — у правого угла: они идут вниз вдоль правого бока ячейки к площадкам BT1 по каналу в рамках.

**Паспорт ячейки.** Попросите у продавца паспорт (datasheet) и сверьте:

- обычная Li-Po 3.7 В, напряжение заряда 4.2 В, плата защиты (PCM) уже на ячейке;
- максимальный ток заряда — не меньше 100 мА: брелок всегда заряжает током 100 мА. У ячейки 150 мА·ч это 0.7C; если в паспорте «max charge 0.5C», такая ячейка не подходит — берите ёмкость больше (M или L);
- температура заряда — диапазон включает 0–45 °C (как обычно у Li-Po; как минимум 7–45 °C): брелок начинает заряд при 10–42 °C по датчику в процессоре и останавливает его ниже 7 °C и выше 45 °C.

Паспорт храните вместе с документами поставщика ячеек (UN38.3 и SDS).

## Слои от лица к обороту

Высоты z — от лицевой стороны платы для версии S. У M верхняя рамка ячейки на 1 мм толще и всё над ней на 1 мм выше, у L — на 2 мм.

| Лист | Детали | z, мм | Что делает |
|---|---|---|---|
| 2 мм, прозрачный | крышка | 9.2 … 11.2 | над стеклом 0.6 мм зазора; отверстия под винты и Ø 1.2 мм над трубкой микрофона |
| 2 мм, прозрачный | 4 шайбы | 7.2 … 9.2 | между платой модуля и крышкой; у нижних двух лыска со стороны стекла |
| 3 мм | рамка экрана | 6 … 9 | стенки вокруг модуля с зазором 0.5 мм, держатель трубки; на 0.2 мм ниже крышки |
| 3 мм (M — 4, L — 5) | верхняя рамка ячейки | 3 … 6 | ушки под модулем, держатель трубки |
| 3 мм | нижняя рамка ячейки | 0 … 3 | ушки, вырез вокруг модуля nRF52840; окна под вилку USB-C нет — торец ячейки закрыт |
| — | плата 1.6 мм | −1.6 … 0 | |
| 4 мм | рамка оборота из двух частей, толкатель | −5.6 … −1.6 | ушки под винтами, карман толкателя и прилив у кнопки, окно под вилку USB-C; обе части приклеены к дну |
| 2 мм, прозрачный | дно | −7.6 … −5.6 | вырез под вилку USB-C, отверстие Ø 3 мм против пищалки, видно светодиод заряда |

**Кнопка.** Шток кнопки SW1 выступает за край платы всего на 0.17 мм, а ход у неё 0.2 мм, поэтому дожатый толкатель заходит под край платы. Чтобы он не поднялся к плате и не упёрся в её край, у толкателя по обе стороны кнопки крылья: в покое они лежат под платой на 1.2 мм, плата держит их сверху, дно снизу. Полка толкателя в кармане — 1.5 мм, как все перемычки рамок, поэтому стенка у кармана выходит наружу приливом на 0.8 мм. Палец останавливается на приливе. Щель штока и окно USB-C режут рамку оборота на две части, и правая нижняя, с половиной прилива, держится на одном винте. Поэтому обе части приклеивают к дну тонкой плёнкой (шаг 16).

**Микрофон** стоит на обороте и слушает через отверстие в плате. Чтобы он не слушал через всю полость корпуса (это срезало бы звук выше ~1 кГц), от отверстия до крышки идёт силиконовая трубка 1 × 2 мм. Её держат две рамки. Трубка на 0.6 мм длиннее промежутка плата — крышка, и оба торца поджаты: так щели нет и при листах толще номинала. Трубка сдвинута на 0.15 мм от конденсатора C4, отверстие в плате остаётся внутри её канала.

**Пищалка** BZ1 стоит на обороте и звучит от платы — в дно. Поэтому в дне против неё отверстие Ø 3 мм: не заклеивайте его. Брелок, который лежит на спине или в сумке, звучит тише.

**Вилка USB-C.** Окно под неё есть только в дне и рамке оборота: на корпус вилки по стандарту, до 12.35 × 6.5 мм, с запасом 0.5 мм по бокам. В нижней рамке ячейки окна нет — она закрывает торец ячейки, и снаружи до ячейки ничем не достать. Ось гнезда на 3.23 мм ниже лица платы, а рамка лежит на лице платы, поэтому под рамкой проходит вилка толщиной до 6.46 мм.

- **Обычные вилки, до ~6.4 мм, входят.** Вилка по пределу стандарта, 6.5 мм, касается рамки на 0.02 мм. `case.py` принимает это как допуск касания до 0.05 мм, а не как ошибку: вилка в гнезде ходит по высоте примерно на 0.15 мм и выбирает такое касание, но может войти не до упора.
- **Кабель с толстой вилкой не войдёт до упора.** У кабелей в толстой оплётке корпус вилки бывает толще 6.5 мм. Берите обычный кабель и проверьте его на собранном брелоке (шаг 18).
- **Предел — для платы 1.6 мм.** Гнездо стоит на обороте, рамка — на лице, поэтому плата тоньше на 0.1 мм уменьшает предел вилки на 0.2 мм.

## Файлы резки

На каждую толщину — `case-acrylic-2mm.svg`, `…-3mm.svg` и так далее, плюс такие же `.dxf` (R12, миллиметры). Детали каждого листа разложены рядами, лист не шире 125 мм. Линии реза красные, толщина 0.05 мм. В SVG у каждой детали своя группа с именем (`<title>`).

| Лист | S | M | L |
|---|---|---|---|
| 2 мм | крышка, дно, 4 шайбы, 2 запасные нижние шайбы | так же | так же |
| 3 мм | рамка экрана, обе рамки ячейки | рамка экрана, нижняя рамка ячейки | рамка экрана, нижняя рамка ячейки |
| 4 мм | рамка оборота (2 части), толкатель | верхняя рамка ячейки, рамка оборота, толкатель | рамка оборота, толкатель |
| 5 мм | — | — | верхняя рамка ячейки |

**Рез.** Контуры номинальные, без поправки на ширину реза. Попросите мастерскую компенсировать рез, то есть сместить линию на половину реза. Без поправки детали выйдут меньше, а отверстия больше на ширину реза, 0.1–0.3 мм. Корпус всё равно соберётся. Толкатель в покое отойдёт от кнопки дальше, до 0.55 мм, но нажатый до прилива дожмёт её: `case.py` проверяет это для реза от 0 до 0.3 мм, дожим выходит 0.05–0.2 мм, а крылья толкателя остаются под платой.

**Нижние шайбы хрупкие:** между отверстием и лыской всего 0.5 мм акрила, без поправки на рез — 0.2 мм. Поэтому на листе 2 мм две запасные. Треснувшая нижняя шайба работает так же, подковой: кладите её разрывом к стеклу.

## Что купить

- **Акрил:** 2 мм прозрачный (крышка, дно, шайбы) и 3, 4 мм на рамки, для L ещё 5 мм. Рамки можно цветные. Листа 125 × 60 мм каждой толщины хватает.
- **Винты M2 × 25 нейлоновые (полиамид) и гайки M2 тоже нейлоновые,** по 4 шт., для любой версии.
  - **Головка** цилиндрическая или полукруглая, Ø не больше 4 мм, **не потайная:** потайная в прямом отверстии крышки распирает акрил.
  - **Где взять.** Нейлоновые M2 с полукруглой головкой обычно продают только до 20 мм, этого мало. M2 × 25 бывает с цилиндрической головкой (DIN 84), например Essentra 50M020040D025 (полиамид 6.6, головка Ø 3.8), но чаще оптовыми упаковками. Нейлоновые гайки M2 продают везде.
  - **Почему нейлон.** Винт справа сверху, если смотреть на экран, стоит всего в 7.7 мм ниже зоны антенны модуля nRF ([README платы](../README.md#расстановка-по-блокам)), а металл рядом с антенной сокращает дальность встреч.
  - **Длина.** Винт выходит из гайки на 4.6 мм (S), 3.6 мм (M) и 2.6 мм (L). После окончательной затяжки, не раньше, откусите конец бокорезами, оставив около 1 мм над гайкой. Запас считается так: винт выходит из гайки хотя бы на 1.2 мм на номинальных листах, это +0.2 мм на каждый из шести листов под винтом. Короче нельзя.
  - **Нейлоновых M2 × 25 не нашлось** — можно стальные (лучше нержавейка): M2 × 22 у S, M2 × 25 у M и L, а гайки всё равно нейлоновые. Корпус соберётся так же, только радио станет чуть слабее; порог встреч проверьте на собранных брелоках ([что проверить](#что-проверить)). Это только для своих прототипов: для брелоков на продажу — только нейлон. Нейлон короче 25 мм не подходит: M2 × 20 не проходит гайку насквозь ни в одной версии.
- **Ячейка** с платой защиты — по правилам выше.
- **Гребёнка экрана.** Штыри проходят сквозь плату и должны выйти из неё хотя бы на 0.5 мм. У обычной гребёнки 2.54 под модулем 8.5 мм (пластик 2.5 + хвост 6). Нужно «под модулем + 1.6 + 0.5»: 8.1 мм у S, 9.1 у M, 10.1 у L.
  - S: подходит модуль с впаянной обычной гребёнкой, штыри выйдут из платы на 0.9 мм.
  - M и L: обычная гребёнка не выйдет из платы. Берите модуль без впаянной гребёнки и длинную гребёнку 2.54 на 4 штыря, от 15 мм (3 + 2.5 + 9.5). Штыри выйдут на 3.4 мм (M) и 2.4 мм (L), лишнее откусите после пайки, оставив около 1 мм.
- **Силиконовая трубка 1 × 2 мм** (внутри × снаружи): кусок 9.8 мм (S), 10.8 мм (M) или 11.8 мм (L) на номинальных листах. Длиннее можно — поджимается, короче нельзя — будет щель.
- **Каптоновый скотч** (лапки USB-C, пайка ячейки, оборот модуля над ячейкой, шлейф экрана) **и тонкий двусторонний скотч** 0.1–0.15 мм, не вспененный. UV-клей для шлейфа — по желанию.
- **Клеевая плёнка без основы, до 0.06 мм** (transfer tape, например 3M 467MP): приклеить обе части рамки оборота к дну (шаг 16). Обычный двусторонний скотч сюда не берите: он толще и поднимает дно.
- **Кабель USB-C с обычной вилкой:** корпус вилки не толще 6.4 мм ([почему](#слои-от-лица-к-обороту)). Кабель с данными, а не только для зарядки: по нему идёт консоль.
- **Электроника, которую ставят руками** ([закупки](../../../docs/hardware.md#закупки-для-сборки)):
  - модуль экрана 0.96″ SSD1306, I2C, 4 штыря, белый, с LDO; для M и L — без впаянной гребёнки. Прошивка брелока запускает экран только как SSD1306: модули 1.3″ обычно на SH1106 и не подходят ([что сверить](../README.md#что-сверить-перед-заказом));
  - вибромотор-монетка 0820, 3 В;
  - для модуля `VCC GND` — две перемычки 0 Ом 0402 (R17 и R19), или переставьте снятые R16 и R18 (шаг 2).
- **Инструмент:**
  - паяльник с тонким жалом, припой, флюс, оплётка, пинцет и лупа;
  - мультиметр, штангенциркуль и линейка;
  - бокорезы (кусачки заподлицо), надфиль и наждачка на ровном листе;
  - губка или пенопласт — класть плату и стопку;
  - программатор SWD, если плата пришла без прошивки: Raspberry Pi Pico с прошивкой debugprobe и модуль преобразователя уровней TXS0108E, провода до 10–15 см; к J3 — кабель Tag-Connect TC2030-CTX-NL через переходник на штыри 2.54 мм или тонкие провода, припаянные к площадкам ([какой и как](../README.md#программатор-swd)). Другой вариант — J-Link EDU Mini V2, кабель втыкается в него прямо. Кабель без защёлок, его прижимают к J3 рукой всё время прошивки;
  - Nordic PPK2 для замера тока (шаг 6).

## Сборка

Это вся сборка брелока: сначала электроника, потом корпус. Ячейка лежит под модулем экрана и закрывает свои площадки, поэтому порядок такой: прошивка, перемычки экрана, мотор, ячейка, экран, корпус. Всё, что паяют на плате рядом с ячейкой, — до неё: после ячейки феном у платы не работают. До резки смерьте модуль экрана и листы ([что проверить](#что-проверить)).

1. **Прошивка**, если плата пришла без неё: по SWD, плата питается от своего USB-C, ячейки и экрана ещё нет. Программатор — Pico с debugprobe через TXS0108E: VA модуля — на площадку 1 J3 (VTref), VB — на 3V3 Pico, 3V3 Pico с J3 никогда не соединять ([схема и команды](../../../firmware/README.md#основной-программатор-raspberry-pi-pico), [J3](../README.md#программатор-swd)). Файл для прототипов — `keychain-revb-factory.hex` из [`firmware/release/`](../../../firmware/release/README.md). Для брелоков на продажу — `firmware-factory.hex` своей сборки со своими номерами (раздел `[sale]` в `firmware/platformio.ini`). На 3V3 до прошивки ~1.8 В, после — ~3.3 В. Тут же — первая проверка из [первого включения](../README.md#первое-включение): только USB-C, без ячейки; в консоли `ver` — версия прошивки, `sensors` — акселерометр и свет отвечают.
2. **Порядок питания экрана — до мотора и ячейки.** У модулей 0.96″ бывает `GND VCC SCL SDA` или `VCC GND SCL SDA`: сверьте надписи на своём модуле сейчас. Отключите USB-C — на плате нет ни питания, ни ячейки.
   - Завод ставит R16 и R18: штырь 1 — GND, штырь 2 — VCC.
   - Только для модуля `VCC GND` снимите R16 и R18 и поставьте **вместо них** R17 и R19 (0 Ом 0402) или переставьте снятые R16 и R18. Паяльником с тонким жалом и пинцетом, не феном. Подписи G и V — на обороте над перемычками, между ними и штырями экрана.
   - **Никогда не ставьте обе пары:** R16 с R17 или R18 с R19 замыкают питание экрана на землю.
   - **Только сейчас.** После шага 6 перемычки лежат прямо за платой защиты ячейки, за 1.6 мм платы, и паять их нельзя. Поставили не ту пару, а ячейка уже стоит, — сначала отпаяйте ячейку.
3. **Вибромотор** — на оборот, в круг с подписью VIBRO: снимите плёнку с клейкого слоя и прижмите мотор внутри круга, выводами к площадкам «+» и «−» рядом с кругом. Красный провод — на «+», другой — на «−». Провода укоротите по месту, чтобы они лежали плоско и не выходили за край платы.
4. **Ножки USB-C** выходят на лицевую сторону под ячейку. Откусите их и спилите надфилем почти заподлицо, не выше 0.1 мм, затем закройте каптоном. Под ячейкой на каптон и скотч заложено 0.3 мм. Если плата пришла панелью, на её краях остались обломки перемычек — бугорки до ~0.3 мм. Сошлифуйте их заподлицо до того, как плата пойдёт в рамки. Где они, если смотреть на лицо платы (кнопка справа):
   - на левом крае — 3.25–8.25, 24.5–29.5 и 35.2–38.2 мм ниже верхнего края платы (ушко не в счёт);
   - на верхнем крае левее ушка — 2.5–6.5 мм от левого края;
   - на нижнем крае — 22.0–25.0 мм от левого края (между USB-C и правым винтом).

   На правом крае и на ушке их нет ([где они](../README.md#панель-для-монтажа)).
5. **Модуль экрана.** Для M и L впаяйте в модуль длинную гребёнку: короткий конец сквозь модуль, пластик под модулем. Оборот модуля над будущей ячейкой заклейте слоем каптона, чтобы углы SOT-23 и 0805 не продавили плёнку ячейки. Круги радиусом 3.3 мм вокруг отверстий модуля оставьте открытыми: на них лягут ушки рамок. Шлейф стекла, загнутый за нижний край модуля, закройте узкой полоской каптона: она бережёт его от излома и от края рамки экрана. Шлейф не перегибайте и не тяните. UV-клей по желанию — тонкой каплей по краю стекла у шлейфа, не выше стекла.
6. **Ячейка — только с платой защиты (PCM).** Защиты от переполюсовки на плате нет: перевёрнутая ячейка открывает внутренний диод зарядника U2, и ток ограничит только её плата защиты. Место ячейки задаёт нижняя рамка ячейки, как шаблон: гнездо в ней шире ячейки всего на 0.3–1.0 мм.
   - Сначала, пока площадки BT1 свободны, смерьте ток выключенного брелока: PPK2 на площадки BT1, брелок выключен кнопкой, меньше 25 мкА ([как](../README.md#первое-включение)). Потом провода PPK2 отпаяйте.
   - Двусторонний скотч — на нижнюю сторону ячейки, защитную плёнку пока не снимайте.
   - Положите плату на губку лицом вверх и вставьте с оборота два винта M2 в два нижних отверстия платы. Наденьте на них нижнюю рамку ячейки (с вырезом вокруг модуля nRF52840, без держателя трубки): её ушки-вилки открыты навстречу друг другу, и на двух винтах рамка не сдвигается ни вбок, ни вдоль. Верхние отверстия оставьте свободными: у правого верхнего пойдут провода.
   - Снимите плёнку и положите ячейку в гнездо рамки: торцом с платой защиты вверх, провода у правого угла, вниз до упора в нижнюю стенку гнезда. Прижмите.
   - Снимите рамку и выньте винты: паять у акрила нельзя, площадки BT1 всего в 0.6 мм от стенки рамки.
   - Без шаблона: ячейка по центру платы, зазоры до левого и правого края платы одинаковые и равны (30 − ширина ячейки) / 2 — у ячейки 20.0 мм по 5.0 мм. Меряйте штангенциркулем.
   - Провода согните у угла ячейки и ведите вниз, прижав к её правому боку, к площадкам BT1. Сгиб прижмите каптоном: петля не должна подниматься к отверстию правого верхнего винта.
   - Разъём и лишнюю длину проводов отрежьте по месту, **по одному проводу**: бокорезы, перекусившие оба сразу, замыкают ячейку. Концы зачистите на 1–2 мм и залудите.
   - Полярность проверьте мультиметром до пайки, а не по цвету проводов. Плюс (+) — на верхнюю из двух площадок у правого края, «+», минус — на «−». Пайку закройте каптоном.
   - Дальше феном у платы не работайте: ячейка на ней.
7. **Выключите брелок** удержанием кнопки 3 с. С прошивкой он включился от ячейки, а ключ питания экрана должен быть закрыт, пока паяются штыри. На плате без прошивки он закрыт и так.
8. **Рамки ячейки** — на плату со стороны лица: сначала нижняя (с вырезом вокруг модуля nRF52840), потом верхняя (с держателем трубки). Ушки ложатся на отверстия под винты, провода ячейки — в канал справа.
9. **Модуль** — штыри в плату, модуль ложится на ушки рамок. На время пайки прижмите его к ушкам винтами:
   - на отверстия модуля положите четыре шайбы 2 мм, у нижних двух лыской к стеклу;
   - вставьте винты сверху сквозь шайбы, модуль, рамки и плату и наживите гайки с оборота;
   - затягивайте пальцами, только чтобы модуль лёг на ушки.

   Без шайб не стягивайте и гайки на лицо не ставьте: у нижних отверстий головка винта или гайка налезает на край стекла. Пропаяйте штыри с оборота и откусите, оставив около 1 мм. Снимите винты и шайбы: шайбы вернутся на место в шаге 13.
10. **Прозвонка до включения.** Брелок выключен (шаг 7). Прозвоните мультиметром все соседние штыри модуля: 1–2, 2–3 и 3–4 (у модуля `GND VCC` это GND–VCC, VCC–SCL и SCL–SDA), а ещё SCL–GND и SDA–GND. Замыкания быть не должно.
    - Короткий писк на VCC–GND — это заряжаются конденсаторы, не замыкание. Между SCL и SDA прибор покажет несколько килоом: это две подтяжки модуля (вместе обычно 9–20 кОм), тоже не замыкание.
    - Между площадками соседних штырей всего 0.84 мм. Капля припоя GND–VCC — это короткое на питании экрана, и ключ Q2 пропустит его прямо от ячейки, без ограничения тока. Капля VCC–SCL подаёт питание экрана (до ~5.4 В от USB) прямо на ножку nRF: от неё прошивка не защитит. Замкнутые SCL–SDA или SCL на GND прошивка увидит сама — «Шина экрана зажата…» в консоли — и будет работать без экрана.
    - Перемычки R16–R19 отодвинуты от штырей почти на 2 мм, но проверить стоит и их.

    Только потом нажмите кнопку — загрузка и лицо. Остальное — по [первому включению](../README.md#первое-включение).
11. **Трубка микрофона** — сквозь держатель верхней рамки ячейки, нижним торцом на отверстие в плате рядом с C4.
12. **Рамка экрана** — вокруг модуля, трубка проходит в её держатель. На верхнюю грань рамки — полоски тонкого скотча (см. «Высота столбика» ниже).
13. **Шайбы** — на отверстия модуля, у нижних двух лыской к стеклу. Трубка должна выступать над шайбами примерно на 0.6 мм (0.4–0.8): длиннее — подрежьте, короче — отрежьте новую.
14. **Крышка** — отверстием над трубкой. Вставьте четыре винта сверху сквозь всё.
15. **Переверните**, придерживая стопку, на губку или пенопласт: головки винтов уйдут в неё.
16. **Оборот.**
    - Рамка оборота из двух частей, ушки на винты.
    - Толкатель — полкой внутрь кармана, крыльями под плату, штоком в щель прилива. Он зажат между платой и дном, поэтому не должен быть толще рамки оборота: смерьте оба штангенциркулем. Толще или так же — прошкурьте его плоские грани на ровном листе наждачки, пока он не станет чуть тоньше рамки.
    - Приложите линейку к правому торцу корпуса ниже прилива: правая часть рамки оборота (с одним отверстием) и рамки ячейки должны лечь в линию, без ступеньки на ощупь, а щель вокруг штока — одинаковая сверху и снизу.
    - **Плёнка.** Правая часть держится на одном винте, а на ней нижняя половина прилива, о который останавливается палец. Без клея нажатия со временем повернут её вокруг винта, и она поджмёт кнопку. Поэтому на открытую сторону обеих частей рамки оборота наклейте полоски клеевой плёнки без основы. Не на толкатель, не в карман и не в карманы крыльев. Растворитель, суперклей и клей для акрила не годятся: они затекают под толкатель и мутят прозрачное дно.
    - Сверху — дно, отверстием над пищалкой. Опустите его ровно, не сдвигая правую часть, и прижмите: теперь обе части держит дно, а дно — все четыре винта.
    - Наживите гайки, не затягивая. Проверьте линейкой ещё раз, теперь вместе с дном, и так держите, пока затягиваете.
17. **Гайки.** Затягивайте без усилия, иначе акрил трескается. Фиксатор резьбы не капайте: от него акрил тоже трескается. Толкатель после затяжки ходит так же свободно и сам возвращается; если зажало — ослабьте гайки и прошкурьте его (шаг 16). Потом откусите концы винтов, оставив около 1 мм над гайкой, и зачистите надфилем.
18. **Проверьте:**
    - кнопка щёлкает, когда толкатель утоплен до прилива, — брелок лицом вверх, лицом вниз и на весу за кольцо. Не щёлкает — ослабьте гайки, сдвиньте рамку оборота вместе с дном от кнопки к середине на волос и затяните снова. Брелок сам гаснет или не замечает нажатий, будто кнопку держат, — сдвиньте к кнопке;
    - потом нажмите кнопку с силой раз 50 и один раз подержите 3 с (брелок выключится, включите его снова) — и проверьте кнопку ещё раз;
    - вилка USB-C кабеля, которым будете заряжать, входит до упора. Упирается в нижнюю рамку ячейки — у кабеля толстая вилка, возьмите обычный ([вилка USB-C](#слои-от-лица-к-обороту));
    - на экране нет следов давления;
    - пищалка и микрофон — по «Что проверить» ниже.

Брелок, который уходит в подарок, последним шагом получает `factory yes` в консоли ([команды](../../../firmware/README.md#консоль)): он возвращается в заводское состояние и гаснет, а включит его уже новый владелец.

## Что проверить

- **Модуль экрана, до резки.** От продавца к продавцу модули разные, а корпус считается по `footprints.OLED`:
  - самая высокая деталь на обороте — по ней свободная высота над ячейкой;
  - на обороте в круге 3.3 мм от центров отверстий нет деталей: там лежат ушки рамок;
  - от центра нижних отверстий до стекла не меньше 1.9 мм: иначе шайбы надо резать с другой лыской;
  - плата модуля 27.3 × 27.8 мм ±0.2: рамка экрана даёт 0.5 мм зазора;
  - толщина платы модуля 1.2 мм; другая — пересчитайте с `--module`, например `python3 case.py --module 1.6`;
  - штыри торчат над платой модуля не больше чем на 1.8 мм: до крышки над ними 0.2 мм;
  - шлейф стекла загибается за нижний край модуля не дальше 0.7 мм, в полосе 13 мм по центру;
  - порядок штырей — `GND VCC` или `VCC GND`: от него перемычки в шаге 2, до мотора и ячейки.

  Если что-то не так, поправьте `OLED` в `gen/footprints.py` и перезапустите `case.py`: проверки покажут, что не сходится.
- **Листы акрила, до покупки ячейки и трубки.** Смерьте каждый лист штангенциркулем в нескольких местах и пересчитайте: `python3 case.py --sheet 2=1.95 --sheet 3=2.86 --sheet 4=4.05` (номинал=мера). По мерам `case.py` даст высоту над ячейкой, длину трубки и винтов и файлы резки в `out/` под ваши листы, а то, что правят при сборке, покажет предупреждением: например, подшлифовать рамку экрана.
- **Высота столбика.** Рамка экрана (3 мм) должна быть на 0.1–0.3 мм ниже, чем «плата модуля + шайба». С мерами листов это проверит `case.py` и скажет, до какой толщины её подшлифовать. Если зазор есть, скотч на рамке экрана выбирает его, и рамка не гремит. Если рамка выше, клейте без скотча или подшлифуйте её: иначе крышка ляжет на рамку, а не на шайбы, и модуль будет болтаться.
- **Люфт винтов.** Листы держатся только на винтах, а отверстия в акриле 2.3 мм на винт 2.0, в плате — 2.2. Каждый лист может сдвинуться на 0.15–0.3 мм — столько же, сколько дожим кнопки (0.05–0.2 мм). Поэтому рамку оборота выравнивают по линейке (шаг 16) и кнопку проверяют после сборки (шаг 18). Правая нижняя часть рамки оборота держится на одном винте, поэтому её приклеивают к дну (шаг 16). Перемычку к другой части в рамке провести негде: мешают детали оборота. Если брелок потом сам гаснет или не замечает нажатий, переклейте её, выровняв заново.
- **Вилка USB-C.** Торец ячейки закрыт нижней рамкой ячейки, а вилку толщиной 6.5 мм по пределу стандарта она касается ([вилка USB-C](#слои-от-лица-к-обороту)). Проверьте кабели, которые будете советовать покупателям, на собранном брелоке.
- **Пищалка.** После сборки сравните `say laugh` в консоли прошивки в корпусе и на голой плате и проверьте, что голос слышно в шумной комнате. Отверстие пищалки в дне не заклеено.
- **Микрофон.** После сборки проверьте хлопок и речь (`v on` в консоли прошивки): пороги громкости подбирались без корпуса.
- **Ушко держит кольцо только платой.** Вокруг отверстия хватает FR4, но рывок за кольцо надо проверить (этап 7 плана). Вырез стенок над ушком неглубокий: кольцо ходит в верхних трёх четвертях отверстия, ниже упирается в акрил.

## Проверки в case.py

`case.py` не пишет файлы, если хоть одна проверка не прошла, и печатает список ошибок:

- детали одного слоя по высоте не пересекаются (у толкателя с рамкой оборота допускается касание);
- зазоры до деталей платы (по дворам, 0.25 мм), платы модуля (0.4 мм), стекла (0.25 мм), гребёнки, шлейфа, ячейки, винтов, трубки микрофона (держатели — 0.03 мм) и корпуса вилки USB-C (0.5 мм по стандартному размеру в дне и рамке оборота);
- нижняя рамка ячейки лежит на вилке USB-C по пределу стандарта не больше чем на 0.05 мм (допуск касания, сейчас 0.02 мм);
- ячейка закрыта со всех сторон: в каждой рамке на её высоте вырез под неё замкнут, ни одно окно контура до неё не доходит;
- рамки ячейки не заходят под детали на обороте модуля, кроме кругов 3.3 мм у отверстий;
- перемычки рамок и толкателя не тоньше 1.5 мм, стенки вокруг отверстий под винт и пищалку не тоньше 0.9 мм, у шайб — 0.45 мм;
- каждый лист под винтом держит его кольцом, а не краем;
- трубка закрывает отверстие микрофона в плате и не ложится на площадки C4 и C6;
- толкатель дожимает кнопку при резе от 0 до 0.3 мм;
- крылья толкателя при любом резе лежат под платой с обеих сторон кнопки, не меньше 0.3 мм при крае платы ±0.2 мм и полосой не короче 0.8 мм. Без них толкатель поднялся бы к плате и упёрся в её край раньше, чем дожал кнопку, — это проверяется отдельно;
- на всём ходе до прилива и с люфтом по y толкатель не ближе 0.25 мм к корпусу кнопки и 0.1 мм к её площадкам и не задевает детали оборота, а карман пускает его до прилива;
- провода ячейки вдоль её правого края лежат в вырезе рамок и не ближе 0.2 мм к винтам;
- в дне есть отверстие против пищалки, и рамка оборота не ближе 0.5 мм к нему;
- листы только ходовой толщины, рамка экрана на 0.1–0.3 мм ниже крышки, над стеклом не меньше 0.5 мм, ячейка своей версии входит при деталях модуля 1.1 мм;
- есть винт нужной длины.

Длину винтов `case.py` выбирает сам: самый короткий ходовой винт, который выходит из гайки хотя бы на 1.2 мм (по номинальным листам или по вашим мерам). По мерам, если такого нет, — самый длинный, который выходит хотя бы на 0.6 мм, с предупреждением. Ходовыми считаются нейлоновые M2 × 16, 20 и 25 мм и стальные 16, 18, 20, 22, 25 и 30 мм.

`selftest.py` проверяет сами проверки: ломает модель в памяти (толкатель без крыльев или с тонкой полкой, крыло на площадке кнопки, нет отверстия пищалки, рамка на проводах ячейки, окно USB-C в нижней рамке ячейки, рамка оборота или дно без выреза под вилку, нет длинных винтов) и ждёт от `check()` своей ошибки на каждую поломку. Ещё он пересчитывает по мерам листов, тонким и толстым, и ждёт предупреждений без ошибок. Файлы он не пишет.

С мерами листов (`--sheet`, `--module`) то, что правят при сборке, — не ошибка, а предупреждение с размерами, и модель строится уже поправленной:

- рамка экрана выше «плата модуля + шайба» — подшлифовать до указанной толщины, ниже нужного — скотч толще;
- штыри над модулем близко к крышке — укоротить до указанной длины;
- ячейка версии не входит, шайбы тонкие для стекла;
- винт выходит из гайки меньше 1.2 мм (хватает и 0.6) или нейлоновых нужной длины не продают — тогда стальные.

Ошибкой и по мерам остаётся только то, что при сборке не поправить.
