olerast67/emotion-keychain/docs/encounters.md

[English](encounters.en.md) | Русский

# Встречи брелоков

Два брелока рядом узнают друг друга по Bluetooth Low Energy: здороваются, запоминают знакомство, иногда устраивают хакерскую дуэль. Победитель досрочно открывает эмоцию из следующего импланта. После дуэли брелоки переговариваются пищалками шифром, который хозяевам не понять. Владельцы находят друг друга, а у тебя появляется повод для сообщества и видео.

Движок уже умеет всё, что видно и слышно:
- сцены `greet`, `duel` и `chat`;
- опыт за встречи и награду за победу (`Behavior::meet`, `Behavior::duel`);
- секретный разговор с общим ключом (`chat_key`, [голос брелока](sound.md#секретный-разговор)).

Ниже — как это работает по радио в прошивке платы rev B (`firmware/src/keychain/radio.cpp`). Логика без радио — формат пакета, подтверждение встречи, отсчёт и исход дуэли — лежит в движке (`face/encounter.h`) и проверяется тестами: два брелока обмениваются пакетами, и сцены у них совпадают.

Тестовый стенд на ESP32 встречается по радио так же (`firmware/src/stand_radio.cpp`): тот же пакет, то же расписание и та же логика движка. Поэтому два стенда на столе здороваются, дуэлируют и переговариваются, как два брелока, а стенд и брелок rev B — друг с другом. Подходят все четыре платы стенда: ESP32-C5, C3 и S3 (стек NimBLE) и обычная ESP32 (Bluedroid). Встречи на стенде идут только в живом режиме. Команды `meet`, `duel` и `chat` по-прежнему играют встречу с выдуманным соседом без радио. Как проверить на двух платах и что не так, как у брелока, — в [README прошивки](../firmware/README.md#встречи-по-bluetooth).

## Главная идея: без соединения

Брелоки **не соединяются** друг с другом. Каждый только рассылает короткий рекламный пакет и изредка слушает эфир. Всё, что нужно для встречи и дуэли, есть в пакете, а исход дуэли оба брелока считают **одинаково и независимо**. Поэтому:

- нет сопряжения, паролей и приложений;
- нет ожидания, кто кого подключит;
- ток минимальный: передача раз в секунду (ночью, во сне и в темноте — раз в 10 с) и короткое прослушивание.

## Рекламный пакет

Пакет BLE — данные сервиса со 128-битным UUID (Service Data, тип 0x21), 27 байт. UUID брелоков `5f4c45b9-ab1b-4dd4-bfea-54bcf4274da6` придуман случайно и никому не принадлежит: в отличие от Company ID в данных производителя, его не нужно покупать у Bluetooth SIG. Флагов в пакете нет (реклама без соединения), поле занимает 29 байт из 31.

| Байты | Поле | Значение |
|---|---|---|
| 0–15 | UUID | UUID брелоков в порядке эфира (младший байт первым): это брелок, а не чьи-то наушники |
| 16 | Версия | `3` (данные сервиса с UUID; пакеты прошлых версий не принимаются) |
| 17–20 | Позывной | `Identity::hash`: из него у получателя восстанавливается код вида `K7-3F2A` |
| 21 | Уровень | номер установленного импланта (0–11) |
| 22 | Флаги | бит 0 — готов к дуэли, бит 1 — киберпанк-тема, бит 2 — легендарный, бит 3 — сцена — дуэль (у объявившего — объявил, у ответившего — принял), бит 4 — «принял» |
| 23 | Настроение | `valence` в диапазоне 0–255 |
| 24 | Отсчёт | через сколько ×100 мс начнётся общая сцена — встреча или дуэль — с тем, кто в байтах 25–26 (0 — не объявлена) |
| 25–26 | Кому | младшие 16 бит позывного соседа |

## Как часто

| Что | Режим | Средний ток nRF52840 (оценка) |
|---|---|---|
| Реклама | раз в 1 с, 0 дБм | ~10–15 мкА |
| Прослушивание | окно 150 мс раз в 30 с | ~30 мкА |
| Рядом сосед, с которым встреча ещё возможна, или ждём общую сцену | реклама раз в 100 мс, окно 300 мс раз в 1.5 с | ≈+1.2 мА (расчёт по коду, как в [энергобюджете](power.md)), обычно на десятки секунд; сцена с соседом не началась за 40 с — дальше попытки через 1, 2, 4, 8 минут; после встречи сосед в перерыве (10 минут и дольше) |
| Ночью, во сне и в темноте | реклама раз в 10 с, без прослушивания | ~3 мкА |

**Сколько ждать встречи.** Пока соседа не слышно, брелок слушает эфир окном 150 мс раз в 30 с, а сосед шлёт пакет раз в секунду. Поэтому первый пакет ловится не сразу: по модели обычно за 40–60 с, а изредка через 5–7 минут (окно ловит пакет примерно в одном случае из семи). Услышавший переходит на частое прослушивание и рекламу раз в 100 мс; второй слышит его в своё ближайшее окно, и сцена начинается секунд через 20. Итого встреча — обычно через 1–3 минуты, изредка до 5–7.

Ночью, во сне и в темноте частое прослушивание не включается, даже если рядом сосед: только когда общая сцена уже объявлена. «Ночь» — только по заданным часам ([часы](../firmware/README.md#консоль)); без них это лишь темнота и сонное или спящее лицо.

Для сравнения: лицо на экране — это 2.3–2.7 мА. Одна встреча — это десятки секунд по +1.2 мА, около 0.01 мА·ч: меньше 0.1 % обычных суток (≈12.9 мА·ч). Сосед, который нас не слышит (сигнал до него слабее порога) или сам не слушает эфир, держит частое прослушивание не дольше 40 с на попытку: это примерно 10–13 % времени, пока он рядом, а не всё время.

## Встреча

1. Брелок слышит пакет с меткой `"KC"` и уровнем сигнала сильнее −70 дБм: это примерно 1–3 м.
2. Если тот же позывной слышен дважды за минуту — это встреча, а не прохожий на эскалаторе.
3. Брелок с меньшим позывным объявляет в пакете отсчёт (4 с). Второй, услышав его, отвечает в своём пакете флагом «принял» (бит 4) с тем же отсчётом, а если принимает дуэль — ещё и битом 3. Объявивший начинает сцену, только если услышал ответ, иначе снимает объявление и повторяет его не раньше чем через 1, 2, 4, 8 минут. Так сцена не играет у одного объявившего, когда второй её не услышал или занят другой. Если второй принял встречу вместо объявленной дуэли (у него дуэли выключены), сцена у обоих — встреча. Оба начинают её в один момент. Объявление вблизи второй считает обычным пакетом соседа: если до этого он слышал объявившего лишь раз, сцену примет по следующему пакету отсчёта.

   Объявление, до сцены которого осталось меньше 2 с, второй не принимает: объявивший уже не успел бы услышать «принял» — пока ждёт ответа, он слушает эфир окнами 300 мс раз в 1.5 с (`Encounters::Config::accept_min_ms`). Полностью исключить сцену у одного без соединения нельзя: если сам ответ «принял» не дошёл до объявившего, второй сыграет сцену один, а объявивший её снимет. Второй после такой сцены в перерыве и на повторные объявления не отвечает; когда перерыв кончится, встреча пройдёт у обоих.
4. Если сосед слышен дважды, а сцена с ним не началась за 40 с, брелок перестаёт часто слушать эфир и пробует снова через 1, 2, 4, 8 минут. Так бывает, когда брелок с меньшим позывным нас не слышит: в темноте или ночью он не слушает эфир, слышит нас слабее порога или у него сработал лимит встреч. 40 с — с запасом на окно прослушивания соседа раз в 30 с: обычная встреча за это время успевает начаться.
5. Позывной ищется в таблице знакомых во флеше (`Friends`, 16 брелоков). Для каждого записано, в сколько разных дней виделись и когда в последний раз.
   - **Новый знакомый:** сцена `greet` «NEW FRIEND [код]», +40 опыта, запись в таблицу.
   - **Старый знакомый:** «HI AGAIN» и +10 опыта, но не чаще раза в день на каждого. Первая встреча дня бывает и дуэлью — опыт за знакомого она даёт так же.
   - **Легендарный брелок:** звёзды в глазах после приветствия и достижение LEGEND MET.

**Перерыв.** С тем же соседом — не чаще раза в 10 минут. Если брелоки лежат рядом и встречаются снова и снова (на одной связке ключей, на столе), перерыв каждый раз вдвое длиннее: 10, 20, 40, 80, 160 минут, дальше по 160. За 8 часов рядом это 7 приветствий, а не 48. Серия забывается, если после конца перерыва 3 часа встречи с этим соседом не было (брелоки были порознь), и с новыми сутками; идущий перерыв доживает свой срок.

## Защита от подделок

Пакет может отправить любой телефон или плата с Bluetooth, и подписи у пакетов нет. Поэтому выдуманная встреча должна давать не больше, чем настоящая, а награды за встречи ограничены за сутки:

- объявление сцены принимается только от соседа, которого уже слышали вблизи обычными пакетами дважды за последнюю минуту, и не совсем издалека (сильнее −85 дБм). Отсчёт длиннее объявленного своей прошивкой (4 с) отбрасывается, короче 2 с — не принимается, а повторные пакеты могут начало только приблизить, но не отложить;
- дуэль начинается, только если хозяин сам разрешил дуэли. Одну дуэль в сутки с соседом и не больше 16 в сутки следит объявивший; у кого 16 дуэлей уже было, тот перестаёт показывать в пакете готовность. Так сцена у обоих одна, даже если второй перезагрузился и забыл сегодняшние дуэли. Опыт и счётчики побед — не больше чем за 3 дуэли в сутки;
- уровень соседа больше числа имплантов — пакет отбрасывается;
- перерывы после встреч хранятся отдельной таблицей по позывным: поток новых позывных вытесняет из памяти соседей, но не перерыв настоящего и не мешает встретить его; в таблице — начало перерыва, его длина и сколько встреч было подряд, так что перерыв верен и после 24.8 суток без перезагрузки;
- встреч всего — не чаще раза в 20 с и не больше 6 за 15 минут. Друзья этот лимит не тратят и в нём не считаются; другом прошивка считает того, с кем дружба не ниже BUDDY, то есть виделись хотя бы в 3 разных дня (`friend_level_days(1)`). Поток подделок не отнимает встречу с другом, а позывной, выдуманный сегодня, другом не становится. Перерыв с другом — как со всеми: 10 минут и дольше при встречах подряд;
- за сутки: не больше 5 новых знакомых с опытом и в счётчике друзей, опыт за 10 старых знакомых, 1 подарок от старшего брелока и 2 эмоции, выигранные в дуэлях; вибрация — только для встреч, которые идут в счёт: друг, который весь день рядом, жужжит раз в день, а приветствие на экране и пищалкой повторяет всё реже (см. «Перерыв»);
- невидимка (`ghost`) ни с кем не встречается: его не слышат, и сцена была бы только у него;
- при вытеснении из памяти соседей первыми уходят услышанные один раз;
- в таблице знакомых новый брелок не вытесняет тех, кого видели сегодня, и крепких друзей (два дня встреч и больше), пока с ними не виделись месяц;
- обычная запись роста и знакомых во флеш — не чаще раза в 10 минут; новые эмоции пишутся сразу, но награды за встречи ограничены за сутки, поэтому поток встреч флеш не изнашивает;
- очередь пакетов в прошивке не принимает слабее −90 дБм и второй пакет того же позывного, пока первый не разобран; данные сервиса достаются своим разбором с проверкой длин полей.

Полностью честную дуэль без соединения не сделать: объявивший выбирает байт настроения, от которого зависит бросок. Поэтому главная защита — лимиты на награды.

## Дружба

Дружба растёт от числа дней, в которые брелоки виделись. Сколько бы раз за день они ни встретились, считается один день.

| Дней встреч | Уровень |
|---|---|
| 1 | NEW FRIEND — новый знакомый |
| 3 | BUDDY — приятель |
| 7 | FRIENDS — друзья |
| 15 | BEST FRIENDS — лучшие друзья, достижение |
| 30 | BFF — друзья навсегда |

Новый уровень — сцена с сердцем и позывным друга, опыт 15 × уровень. Когда таблица полна, новый знакомый вытесняет того, с кем дружба слабее всего, а при равенстве — того, с кем виделись давнее всех. Сегодняшних знакомых и крепких друзей (два дня и больше), с которыми виделись в последний месяц, не вытесняет никто; если вытеснять некого, новый знакомый не записывается.

**Подарок старшего.** Брелок, у которого имплант на два и больше выше, раз в день дарит младшему эмоцию (не больше одного подарка в сутки от всех) из его следующего импланта: сцена GIFT с позывным дарителя, потом новая эмоция с NEW. Уровень соседа — байт 21 пакета.

**Шёпот.** Старые знакомые иногда переговариваются шифром, как после дуэли. Решение принимает общий ключ: `chat_key(…) % 4 == 0`, в среднем в каждую четвёртую встречу. Ключ у обоих брелоков одинаковый, без обмена сообщениями. Но «старый ли знакомый», каждый брелок решает по своей таблице знакомых. Обычно таблицы согласны: знакомство записывается обоим в одной и той же встрече. Если же один брелок другого забыл (сброс или полная таблица, где вытеснить было некого), шёпот будет только у того, кто помнит.

**Общие сцены идут первыми.** Встреча, дуэль и разговор встают в начало очереди сцен (`Behavior::queue_shared`) и прерывают свою сцену брелока, например достижение. Прерванная сцена доиграет потом. Так у двух брелоков общие сцены совпадают, даже если у одного в очереди было что-то своё.

## Дуэль

Дуэль происходит, если оба брелока подняли флаг «готов к дуэли» и дуэли с этим брелоком сегодня ещё не было (это помнит объявивший). Готовность включается и выключается двойным нажатием кнопки, по умолчанию она включена; так в дуэль вступают только те, кто хочет.

Дуэль — тоже встреча. Она засчитывает день дружбы: рост уровня с сердцем и опытом, BEST FRIENDS, подарок старшего. Ещё она даёт опыт за нового или старого знакомого и достижения за близнеца и легенду. Своей сцены приветствия у дуэли нет: её место заняли дуэль и разговор. Это важно, потому что первая встреча дня с соседом, у которого дуэли тоже включены (а с завода они включены), — обычно дуэль. Поэтому два новых брелока друг другу NEW FRIEND не показывают, а короткая встреча в метро бывает только дуэлью.

Исход одинаково считается на обоих брелоках, без обмена сообщениями:

```
a, b   = позывные по возрастанию
nonce  = hash32(a ^ rotl(b, 13) ^ настроение_объявившего × 0x9E3779B9)
roll   = hash32(a ^ rotl(b, 13) ^ nonce)
бонус  = (уровень_a − уровень_b) × 4    // уровень помогает, но не решает
победа a, если (roll % 100) + бонус ≥ 50
```

Счётчики дней у брелоков разные, поэтому вместо номера дня в броске — байт настроения из пакета того, кто объявил сцену. Пока идёт отсчёт, он не меняется, и оба брелока знают его одинаково.

Уровни на время отсчёта тоже замирают. Каждый брелок показывает в пакетах с отсчётом и с ответом «принял» тот уровень, по которому сам считает исход. Объявивший пересчитывает исход по уровню из ответа второго. Поэтому новый имплант посреди отсчёта не даёт двух победителей или двух проигравших.

Оба брелока показывают сцену `duel` одновременно. Момент начала объявляет брелок с меньшим позывным: в своём пакете он пишет отсчёт и младшие биты позывного соседа. Сосед, услышав пакет, ставит дуэль на тот же момент. Реклама приходит с задержкой в единицы миллисекунд, поэтому расхождение — десятки миллисекунд даже без соединения.

Победитель получает 25 опыта и досрочно открывает эмоцию из ближайшего импланта (`Progress::duel_prize`, не больше двух в сутки). Проигравший получает 10 опыта и обижается.

## Секретный разговор

Сразу за дуэлью брелоки переговариваются пищалками: четыре реплики по очереди, по шесть знаков шифра. На экранах у обоих одни и те же пузыри со знаками, в конце на миг мелькает «расшифровка» и ACCESS DENIED. Как это звучит и выглядит — в [голосе брелока](sound.md#секретный-разговор).

Для разговора по радио ничего не передаётся. Нужно только то, что уже есть:

- **Общий ключ** `chat_key(позывной_a, позывной_b, nonce)`. Порядок позывных не важен. `nonce` — тот же, что у дуэли: из позывных и настроения объявившего, поэтому одна пара каждый раз говорит о новом.
- **Кто начинает** — тот, у кого позывной меньше (`chat_first`).
- **Когда** — после дуэли и постоянной паузы 2.5 с (`Behavior::duel` ставит обе сцены в очередь сразу). Если дуэль началась одновременно, разговор тоже. Реплики не налезают друг на друга при расхождении до ±0.45 с.

## Приватность

Позывной постоянный, поэтому брелок теоретически можно отследить по эфиру, как любые наушники или часы. Что предусмотреть:

- адрес BLE — случайный статический, не MAC чипа, но тоже постоянный: вместе с позывным брелок узнаваем в эфире. У стенда на ESP32 адрес — MAC чипа: стенд — плата для проверки, а не брелок для кармана;
- «невидимка» (команда `ghost`, у брелока и у стенда): брелок только слушает и ничего не рассылает;
- в пакете нет ничего личного: только позывной, уровень и настроение.

## Что дальше

- [x] Прошивка nRF52840: реклама и сканирование по расписанию, фильтр по метке и RSSI.
- [x] Список знакомых во флеше, сутки по часам или по счётчику дней.
- [x] Флаг «готов к дуэли» — двойным нажатием кнопки.
- [x] Отсчёт до встречи и дуэли в пакете и подстройка второго брелока; тест, что сцены совпадают.
- [x] Пакет без Company ID: свой UUID в данных сервиса, покупать ничего не нужно.
- [x] Встречи на стенде ESP32 по тому же пакету: стенд со стендом и стенд с брелоком; тест стенда на ПК встречает его с брелоком через эфир теста.
- [ ] Проверка на живых платах: два стенда на столе, стенд и брелок, два брелока на столе, в рюкзаках и в метро.
