olerast67/emotion-keychain/docs/power.md

[English](power.en.md) | Русский

# Энергобюджет

Лицо горит всегда. Экран гаснет, только когда его точно никто не видит: в кармане, в закрытой сумке, в тёмной комнате. Почти весь ток при включённом лице берут OLED и микрофон, поэтому автономность решают:

1. сколько пикселей горит;
2. насколько ярко;
3. как часто экран вообще трогают;
4. сколько времени лицо горит, а сколько брелок лежит в кармане.

## Плата rev B: ток по режимам

Числа ниже даёт симуляция платы целиком (`keychain_sim`, сценарии `pocket` и `day`): настоящая прошивка `firmware/src/keychain` на моделях микросхем, ток — по состоянию каждой микросхемы, по типовым значениям даташитов. Это оценка, её нужно подтвердить замером PPK2 на живой плате. Симуляция и сама проверяет границы: карман меньше 170 мкА, выключенный брелок меньше 15 мкА, обычный день 10–16 мА·ч.

| Режим | Когда | Ток | Что берёт ток |
|---|---|---|---|
| Лицо на экране | днём на свету | ≈2.3 мА в покое, ≈2.7 мА с касаниями и ходьбой | экран ~1.35 мА, микрофон 0.8 мА, процессор, датчики и реклама — остальное |
| Лицо в полутёмной комнате | 8 лк днём | ≈2.3 мА | то же: яркость обычная |
| Приглушённое лицо (Dim) | ночью при свете, персонаж спит | ≈0.9 мА | контраст 1/4, микрофон выключен |
| Карман, экран выключен | темно дольше минуты | ≈0.13 мА | сон процессора, реклама раз в 10 с, датчик света раз в 2 с, акселерометр |
| Встреча рядом (Busy) | рядом другой брелок, пока встреча возможна | +1.2 мА (расчёт по коду) | окно приёма 0.3 с раз в 1.5 с и реклама 10 раз в секунду; после встречи сосед 10 минут не считается |
| Полное выключение | удержание кнопки 3 с, пустая ячейка | 6–17 мкА | датчики спят, остальное — зарядник, диод и плата защиты ячейки; в симуляции 12 мкА |
| На зарядке | USB | от USB | ячейка не тратится |

Звук и вибро берут единицы и десятки миллиампер, но только пока звучат: на средний ток они почти не влияют.

**SA0 акселерометра — на VDD.** В первой разводке этот вывод LIS3DH был на земле, а у него внутренняя подтяжка к VDD. Через неё всё время, даже в выключенном брелоке и в загрузчике, шло бы 0.11–0.16 мА: карман вырос бы вдвое (0.13 → ~0.29 мА), а выключенный брелок разряжал бы ячейку 150 мА·ч за 5–7 недель. Теперь SA0 на VDD, и тока через подтяжку нет; прошивка ещё и отключает её (CTRL_REG0 = 0x90). Симуляция эту утечку и не моделировала, поэтому её числа не изменились.

### Автономность

Полезная ёмкость — до отсечки прошивки 3.35 В, около 95 % номинала: ~142, ~190 и ~237 мА·ч у ячеек версий S, M и L ([корпус](../hardware/rev-b/case/README.md#три-версии-s-m-l)).

| День | Расход за сутки | S, 402025, 150 мА·ч | M, 502025, 200 мА·ч | L, 602025, 250 мА·ч |
|---|---|---|---|---|
| Обычный: 3 ч лица, час в полутьме, 20 ч в кармане и ночью | ≈12.9 мА·ч | ≈11 дней | ≈15 дней | ≈18 дней |
| Плотный: 8 ч лица, 16 ч в кармане | ≈23.5 мА·ч | ≈6 дней | ≈8 дней | ≈10 дней |
| Цель из [железа](hardware.md#цели): 16 ч лица + 8 ч темноты | ≈44 мА·ч | ≈3 дня | ≈4.3 дня | ≈5.4 дня |

- **Обычный день** — прямо из сценария `day` (по часу на режим, касания и ходьба днём): лицо 2.69 мА, полутьма 2.27 мА, карман и ночь 0.127 мА.
- **Плотный день и цель** посчитаны из тех же токов: лицо 2.69 мА, остальное время — 0.127 мА.
- Встречи (+1.2 мА, пока рядом сосед), долгие сцены и звук сюда не входят. Ёмкость на этикетке дешёвых ячеек часто завышена: настоящую проверяют разрядом.

Цель «16 ч лица ≥5 дней» выполняется только в версии L. Что осталось, по выигрышу:

1. **Микрофон окнами** (слушать 1 с из 4 или только пока брелок в руке): ≈−0.5 мА в режиме лица. Меняет поведение: хлопок слышен только в окне.
2. **Контраст по люксам** (тусклее в комнате, ярче на солнце) и VCOMH/precharge: ≈−0.3–0.5 мА. Нужен замер читаемости на своей панели.
3. **I2C со сном ядра** во время передачи вместо ожидания в Wire: ≈−0.15 мА в режиме лица.
4. **Цикл по событиям** вместо прохода каждые 10 мс, прерывание по уровню FIFO акселерометра, 50 Гц вместо 100: десятки мкА.
5. **Rev C:** R7 и R9 ключа экрана 1 МОм вместо 100 кОм (−60 мкА при включённом экране), кварц 32 кГц, ячейка 20 × 30 мм, если плата под ней вырастет ([план](plan.md)).

С пунктами 1–3 лицо берёт около 1.8 мА, и цель выполняется уже на ячейке 200 мА·ч.

### Выключенный брелок и хранение

Выключенный брелок берёт 6–17 мкА по типовым значениям даташитов: сон nRF52840, зарядник, диод на VBUS, плата защиты ячейки, датчики в сне. Предел на проверке первой платы — 25 мкА ([первое включение](../hardware/rev-b/README.md#первое-включение)).

| Что | 6 мкА | 12 мкА | 17 мкА | 25 мкА |
|---|---|---|---|---|
| Запас ~3.6 мА·ч после «Ячейка почти пуста» (S; у M и L чуть больше) | 25 дней | 12 дней | 9 дней | 6 дней |
| Ячейка S, заряженная наполовину (~71 мА·ч) | ~16 месяцев | ~8 месяцев | ~6 месяцев | ~4 месяца |

Саморазряд самой ячейки (единицы процентов в месяц) идёт сверху. Поэтому:

- брелок, выключившийся на пустой ячейке, нужно зарядить в течение недели: дальше плата защиты ячейки отключит её, а глубокий разряд ячейку портит;
- на долгое хранение брелок оставляют заряженным примерно наполовину и подзаряжают раз в 2–3 месяца.

## Что делает прошивка

- **Кадр отрисовывается только при изменении лица.** Статичную картинку SSD1306 держит сам, процессор спит. Если хэш параметров лица не изменился, движок пропускает отрисовку целиком.
- **На экран уходят только изменённые окна страниц.** Нейтральное лицо даёт около 1.2 КБ/с по I2C, это примерно 3 % шины на 400 кГц; успокоившись — около 0.8 КБ/с.
- **Кадр — ровно тогда, когда картинка сменится.** Движение сдвигает лицо целыми пикселями, и процессор просыпается в момент сдвига. Мигающие значки будят его только на сменах картинки: батарейка — дважды за 1.2 с, многоточие — 4 раза за 1.6 с. Zzz — 5 раз в секунду. События ближе 20 мс сливаются в одно пробуждение.
- **Долгие состояния дешёвые:** сон, усталость, мало заряда. Дрожь от холода идёт приступами, 1 с из 4, и между приступами процессор спит. Через 3 минуты без внимания лицо успокаивается: фирменные жесты втрое реже, взгляд вдвое.
- **Шум акселерометра не будит процессор.** Наклон меньше 0.05 игнорируется, зрачки двигаются ступенями.
- **Глаза-кольца вместо залитых:** горит меньше пикселей, панель меньше выгорает.
- **Контраст подстраивается под обстановку.** Поведение выдаёт уровень яркости: обычный; приглушённый ночью и во сне; минимальный в темноте. Прошивка переводит его в контраст: яркость пользователя, её 1/4 и 1/16. Контраст уходит на экран только при смене уровня. VCOMH и precharge — следующий шаг: VCOMH `0x00` и короткий precharge дают картинку тусклее, чем один контраст. Эффект меряем на своей панели.
- **В темноте экран выключается, а не рисует чёрный кадр.** Чёрный, но включённый экран всё равно берёт 0.5–1.4 мА на charge pump и развёртку. Через минуту темноты прошивка обесточивает модуль экрана ключом, кадры при выключенном экране — не чаще раза в секунду.
- **Микрофон и радио — только когда нужны.** Микрофон слушает, пока лицо на обычной яркости; ночью, в кармане и в экорежиме его питание выключено. Кварц 64 МГц, который просит микрофон при старте, на батарее сразу отпускается (~0.25 мА); на USB кварц держит сам USB, и по нему же меряется температура для заряда. Эфир слушается окнами 150 мс раз в 30 с, а ночью и в кармане не слушается вовсе, и реклама идёт раз в 10 с.
- **Ретро-режим по желанию:** горит каждая вторая строка, смещение чередуется. Меньше выгорание и немного меньше ток.
- **Экорежим при малом заряде.** Поведение само переходит в него по событию `battery_low`. Кадры реже: 50 мс, при критическом заряде — 80. Занятия от скуки вдвое реже, сюрпризов нет. На зарядке всё возвращается.
- **Выключение** при пустой батарее: `Behavior::power_off(now, true)` показывает LOW BATTERY → GOODNIGHT, потом персонаж спит. Прошивка гасит экран и уходит в системное выключение по `scene_ends_ms()` — с запасом до отсечки платы защиты ячейки.
- **Звук и вибро** — только пока звучат. Ночью брелок не болтает ([голос брелока](sound.md)).

Нагрузку по каждой эмоции показывает `./build/facegen bench`: время кадра, кадры в секунду, байты в секунду, занятость шины.

## Защита от выгорания

Статичный кадр на OLED выгорает. Белая панель стареет медленнее голубой, но защита всё равно нужна.

- Всё лицо медленно дрейфует: на 1 px раз в 20–40 с, в пределах ±3 px.
- Моргания, взгляд и фирменные жесты сдвигают горящие пиксели. Ни один кадр не держится дольше нескольких секунд.
- Контраст в помещении — `0x40`–`0x7F`, а не `0xFF`.
- Тест: один экземпляр 4 недели работает с лицом 24/7, затем на нём выводится белый экран и ищутся следы.

## Как мерить

- **Прибор:** Nordic PPK2 в режиме источника питает плату напряжением 3.7–3.8 В вместо ячейки. Каждое состояние записывается не меньше 60 с. µCurrent и другие амперметры ставят только последовательно между источником 3.7 В и платой, а не вместо ячейки.
- **Куда подключать.** Площадки BT1 закрывают ячейка и модуль экрана, поэтому:
  - **без модуля экрана** — на площадки BT1, пока ячейка не впаяна (шаг сборки перед ячейкой). Прошивка работает и без экрана;
  - **с модулем экрана** — на отдельной плате для замеров, собранной без ячейки: PPK2 на контрольные точки SYS (+) и GND (−) на обороте ([плата для замеров](../hardware/rev-b/README.md#на-первых-платах)). Без USB SYS соединена с VBAT через открытый Q1, так что это то же, что питать от ячейки. Точки доступны, пока не поставлены рамка оборота и дно. Ячейку в такую плату потом не впаять без снятия экрана.
  - **Пока PPK2 подключён, USB не подключайте:** от USB на SYS выше 3.7 В, и ток пойдёт в выход PPK2.
- **Ток экрана:** разница замеров «с модулем» и «без модуля» — на плате для замеров или до и после установки модуля.
- **Выключенный брелок:** удержание кнопки 3 с, USB отключён, запись не меньше 60 с. Больше 25 мкА — искать утечку ([первое включение](../hardware/rev-b/README.md#первое-включение)); выводы экрана при закрытом ключе проверяются только с модулем.
- **Типичные ошибки замера:**
  - подключённый USB: брелок питается от него, а светодиод заряда тлеет;
  - встреча рядом: другой брелок на столе добавляет +1.2 мА;
  - модуль экрана другого продавца: у его LDO и панели свой ток, сравнивать — на одном модуле.
- **Итоговая проверка** — разряд настоящей ячейки до отсечки в режиме «16 ч лицо + 8 ч темноты».
