olerast67/emotion-keychain/docs/sound.md

[English](sound.en.md) | Русский

# Голос брелока

У брелока есть пьезопищалка 9×9 мм. Он отвечает на касания короткими «словами» из нот, как R2-D2, играет музыку к сценам и после дуэли переговаривается с другим брелоком шифром, который хозяину не понять.

Движок звука (`engine/include/face/sound.h`) выдаёт только частоту и длительность нот. Прошивка играет их ШИМом: на ESP32 — LEDC, на nRF52840 — PWM. Тот же код звучит в браузерном симуляторе и сохраняется в WAV на ПК.

## Голоса характеров

Одна и та же реплика у разных характеров звучит по-разному: своя основная нота, своя манера и своя разговорчивость.

| Характер | Нота | Манера | Разговорчивость |
|---|---|---|---|
| игрун | 1568 Гц | отрывисто, с подскоком перед последней нотой | 0.9 |
| ворчун | 1046 Гц | низко, интервалы вдвое уже, бурчит | 0.5 |
| соня | 1568 Гц | медленно и сползает вниз | 0.35 |
| скромник | 1319 Гц | быстро, не договаривает длинные фразы и всегда тихо | 0.3 |
| любопытный | 1175 Гц | в конце каждой фразы — вопрос вверх | 0.8 |
| пофигист | 1318 Гц | плавные скольжения между нотами | 0.45 |
| драма | 1976 Гц | широкие театральные скачки, тянет последнюю ноту | 1.0 |
| глюк | 1046 Гц | случайные цифровые щелчки между нотами | 0.7 |
| хитрец | 1760 Гц | «хе-хе-хе»: каждая нота тройкой | 0.75 |
| добряк | 1397 Гц | мягкий форшлаг терцией перед каждой нотой | 0.7 |

Все ноты лежат в 600–5400 Гц. Ниже пьезо почти не слышно, выше — режет уши. Громче всего пищалка звучит около 4 кГц, поэтому высокие ноты фраз самые заметные.

## Когда он говорит

Брелок не пищит на каждую смену лица. Реплику выбирает эмоция, которую он только что показал: смех — «хе-хе», грусть — три ноты вниз, испуг — трель.

| Что случилось | Вероятность реплики |
|---|---|
| Тап | 45 % × разговорчивость; если эмоции нечего сказать — «бип» |
| Двойной тап | 80 % × разговорчивость |
| Кнопка | 90 % × разговорчивость |
| Тряска, удар, взяли в руки, громкий звук, вверх ногами | 70 % × разговорчивость |
| Падение | 95 % × разговорчивость |
| Свои занятия от скуки | 10–15 % × разговорчивость |
| Зарядка подключена, заряжен, мало заряда, выключение | всегда |

Обычные реплики звучат не чаще раза в 1.5 с и не перебивают друг друга. Важные — зарядка, батарея, апгрейд, встреча, загрузка — перебивают обычную реплику, но не музыку сцены.

**Тихие часы** — с 23:00 до 6:00, только по заданному времени (`Behavior::set_clock_known`): у брелока нет часов с батарейкой, и после выключения кнопкой время не известно, пока его не зададут снова ([часы](../firmware/README.md#консоль)). Без времени тихих часов нет, но в темноте брелок и так спит. Ночью брелок не болтает: звучат только важные реплики, и тихо. Музыка сцен ночью молчит, кроме загрузки и апгрейда, а секретный разговор идёт только на экране. Скромник говорит тихо и днём. Звук выключается совсем тройным нажатием кнопки брелока (только плата rev B) или командой `snd` в консоли (на стенде и на плате).

## Реплики

| id | Звучит | Пример эмоций |
|---|---|---|
| `boop` | «бип-бип» вверх | тык |
| `happy` | аккорд вверх | радость, восторг, вечеринка |
| `laugh` | «хе-хе-хе» | смех, хихиканье, злодейский смех |
| `sad` | три ноты вниз | грусть, слёзы, обида |
| `angry` | резкий повтор с полутоном вниз | злость, ярость, переворот стола |
| `surprise` | рывок на октаву вверх | удивление, «шок», o_O |
| `scared` | дрожащая трель | страх, ужас, крик |
| `love` | мягкий аккорд до октавы | любовь, обожание, тронут |
| `sleepy` | зевок вниз | сонный, устал |
| `hello` / `goodbye` | вверх / вниз | привет, проснулся / пока |
| `question` | вопрос вверх | любопытство, непонимание |
| `idea` | «дзынь» | идея |
| `error` | «би-буп-би-буп» | ошибка, game over, нокаут |
| `charge_start` / `charge_full` | арпеджио / арпеджио с повтором | зарядка |
| `battery_low` | две ноты вниз | мало заряда |
| `level_up` | фанфара | новый имплант |
| `friend_hi` | двойное «привет» | новый знакомый брелок |
| `duel` / `win` / `lose` | вызов / фанфара / «грустный тромбон» | дуэль |
| `boot` | гамма вверх | включение |
| `two_bits` | пауза и две ноты к тонике | ответ на секретный стук «Shave and a haircut» (стенд и симулятор; на плате rev B стук пока не срабатывает) |

## Музыка сцен

Музыка совпадает с картинкой: звук исхода дуэли раздаётся вместе с надписью WIN! или LOST, фанфара апгрейда — на INSTALLED.

| Сцена | Музыка |
|---|---|
| `boot` | гамма вверх |
| `hack` | рукопожатие модема: тон ответа 2100 Гц, трели, шум — и фанфара на ACCESS GRANTED |
| `data_rain` | капли данных: щелчки разной высоты, к концу реже |
| `error404` | «би-буп-би-буп» |
| `reboot` | скольжение вниз под гаснущий кадр, гамма загрузки, «привет» |
| `hide` | «вжух» вниз, потом вопрос, когда выглядывает |
| `upgrade` | тики загрузки всё выше и фанфара на INSTALLED |
| `new_year` | Jingle Bells |
| `birthday` | Happy Birthday, две строки |
| `halloween` | начало Токкаты ре минор Баха |
| `greet` | двойное «привет» новому другу, «привет» старому |
| `duel` | вызов, затем фанфара или «грустный тромбон» |
| `chat` | секретный разговор (ниже) |
| `achievement` | фанфара, когда кубок встаёт на место |
| `charge` | без музыки: звучит реплика `charge_start` |
| `shutdown` | «пока», затем скольжение вниз под гаснущий кадр |
| `banner` | по значку: сердце — `love`, подарок — `level_up`, звезда — `idea`, ракета — гамма-старт, череп — Токката |
| `bsod` | «би-буп», на 100 % — загрузка |
| `visor` | тон скользит вверх-вниз вместе с огоньком сканера |
| `screensaver` | тишина — и фанфара, когда логотип попал в угол |

Праздничные мелодии — общественное достояние: Jingle Bells (1857), Happy Birthday, Токката Баха. Чужих мелодий из игр и фильмов нет.

## Секретный разговор

После дуэли два брелока «переговариваются» пищалками: четыре реплики по очереди, по шесть знаков шифра в каждой. Хозяева слышат мелодичное щебетание, но смысла в нём нет. Это шифр между брелоками.

**Как оба играют один разговор.**
- Общий ключ: `chat_key(хэш_a, хэш_b, nonce)`. Порядок хэшей не важен, `nonce` — число сеанса BLE.
- Реплики и знаки оба брелока считают из ключа одинаково (`chat_line`).
- Начинает тот, у кого хэш меньше (`chat_first`). Реплики 0 и 2 — его, 1 и 3 — соседа.
- Каждый играет только свои реплики. На месте чужих у него тишина: их в этот момент играет сосед.
- Знак — нота пентатоники и одна из двух длительностей. Реплика звучит до 1.1 с, на реплику с паузой отведено 1.6 с, весь разговор — 6.4 с.

**На экране** у обоих одно и то же:
- сверху позывной соседа и «ME»;
- реплики идут пузырями: соседские слева, свои справа;
- знаки появляются вместе с нотами;
- в конце — DECRYPT с полосой загрузки. На полсекунды из шума проступает «расшифровка» вроде `HUMAN IS OK`, `TOO MANY TAPS`, `DONT TELL HUMAN`, и тут же — ACCESS DENIED.

Знаков шифра 16. Это свои рисунки 5×5, не похожие на буквы шрифта. После разговора брелок делает невинное лицо: «мы ничего не обсуждали».

**Синхронность.**
- `Behavior::duel(код, победа, now, хэш_соседа, nonce)` ставит в очередь дуэль и сразу за ней разговор.
- Пауза между сценами очереди постоянная, 2.5 с. Касание в паузе её не сдвигает, поэтому разговор начинается у обоих одновременно, если дуэль началась одновременно.
- Для этого брелок с меньшим хэшем объявляет в рекламном пакете отсчёт до начала, второй подстраивается под него. Подробности — в [протоколе встреч](encounters.md#секретный-разговор).
- Реплики не налезают друг на друга при расхождении до ±0.45 с.

На стенде и в симуляторе соседа нет. Поэтому `Behavior::set_chat_both_sides(true)` играет обе стороны одной пищалкой, реплики соседа — его голосом.

## Громкость

На плате rev B пищалка стоит между двумя ножками nRF52840 (`BUZ_A`, `BUZ_B`, через 1 кОм).
- **Обычная громкость:** ножки работают в противофазе, мостом. Размах на пьезо вдвое больше, это +6 дБ.
- **Тихо** (`Voice::soft()`): одна ножка, вторая на земле.

На стенде пищалка на одной ножке. Тихий режим там — скважность 1/8 вместо 1/2, это примерно на 9 дБ тише.

Пьезо потребляет единицы миллиампер и только пока звучит. На средний ток реплики не влияют.

## Где послушать

- **В браузере:** `sim/web/build.sh`, затем `sim/web/dist/index.html` и кнопка «Пищалка».
  - Тапы по экрану, ситуации и сцены звучат голосом выбранного брелока.
  - В группе «Другой брелок» есть встреча и дуэль. После дуэли идёт разговор: слышны обе стороны.
- **На ПК, в WAV:**
  ```sh
  ./build/facegen sound all out/voice.wav --serial 5   # все реплики подряд голосом брелока №5
  ./build/facegen sound laugh out/laugh.wav --serial 9
  ./build/facegen sound duel out/duel.wav --value 1     # музыка сцены; cue:duel — реплика
  ./build/facegen sound chat out/chat.wav               # секретный разговор, обе стороны
  ```
- **На стенде:** пассивная пищалка между выводом из таблицы в [firmware/README.md](../firmware/README.md) и GND. Затем команды `say laugh`, `x birthday`, `duel win`, `chat`, `snd`.

## В коде

```cpp
Voice voice;
voice.init(&temperament(me.archetype), me.hash);
behavior.attach_voice(&voice);           // реплики, музыка сцен, тихие часы
...
const uint16_t hz = voice.tone(now);     // 0 — тишина
pwm_tone(hz, voice.soft());              // мост или одна ножка
спать до ближайшего из engine.next_update_ms(), behavior.next_update_ms(), voice.next_change_ms()
```

Голос без кучи и libm: частоты считаются таблицей полутонов, мелодия — до 96 нот.
