olerast67/emotion-keychain/docs/img/render-face-512.png

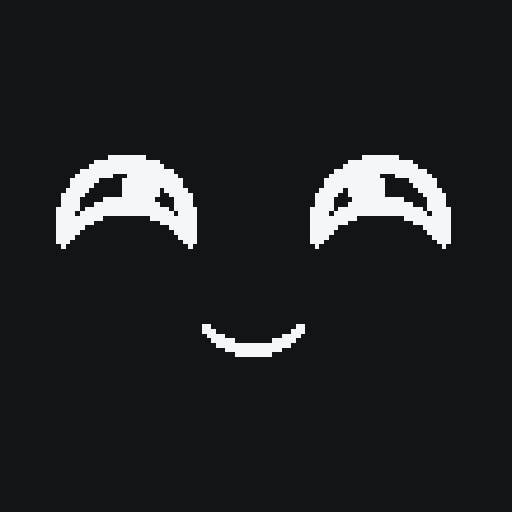
docs/img/render-face-512.png
