olerast67/emotion-keychain/hardware/rev-b/out/keychain-rev-b-back.png

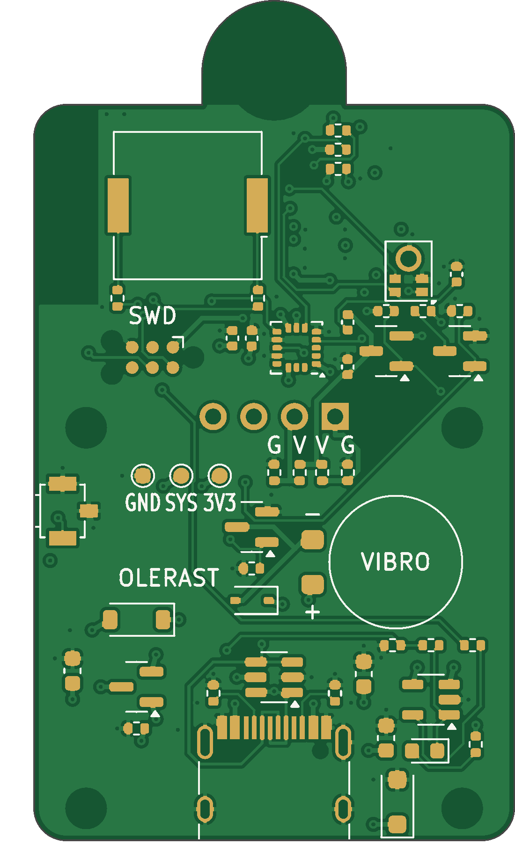
hardware/rev-b/out/keychain-rev-b-back.png
