olerast67/emotion-keychain/hardware/rev-b/out/keychain-rev-b-front.png

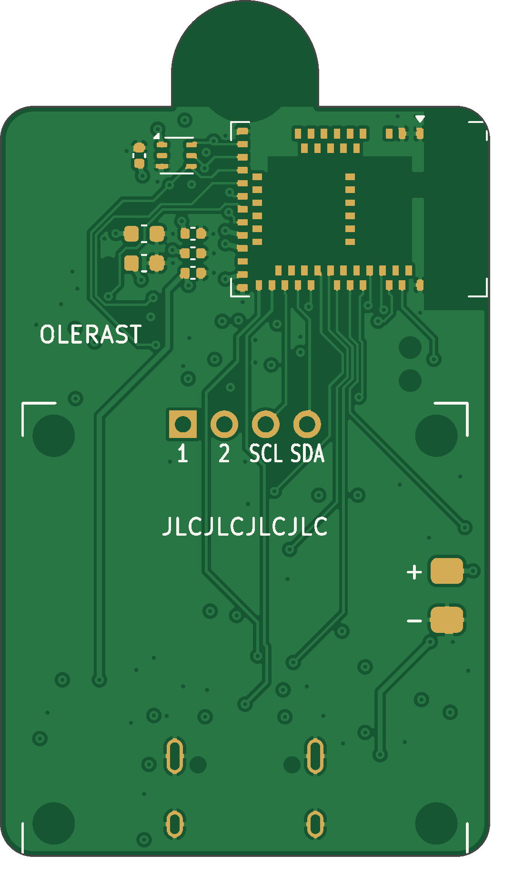
hardware/rev-b/out/keychain-rev-b-front.png
