olerast67/emotion-keychain/hardware/rev-b/out/panel/keychain-rev-b-panel-back.png

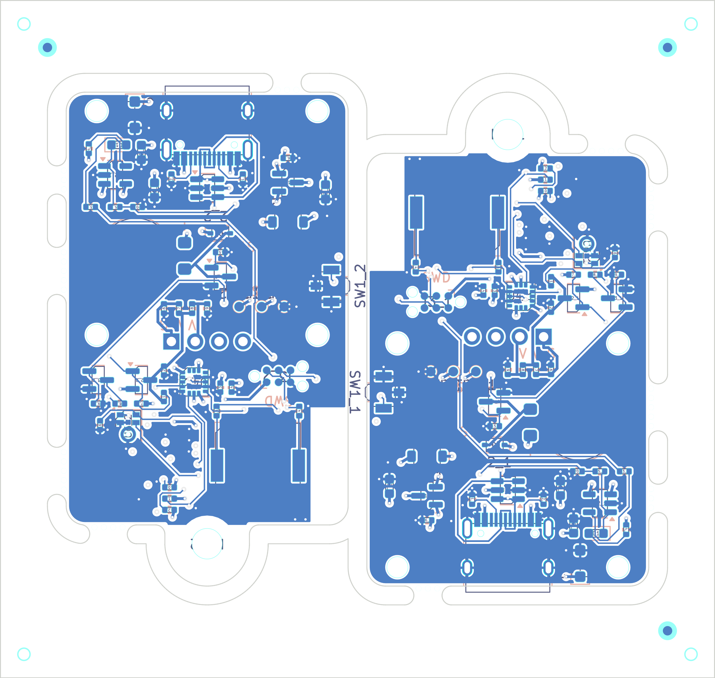
hardware/rev-b/out/panel/keychain-rev-b-panel-back.png
