olerast67/emotion-keychain/hardware/rev-b/out/keychain-rev-b-bom-jlcpcb.csv

Comment | Designator | Footprint | LCSC | MPN
PKMCS0909E4000 | BZ1 | Buzzer_Murata_PKMCS0909E | C910763 | PKMCS0909E4000-R1
10uF | C1,C2,C3,C4 | C_0603_1608Metric | C19702 | CL10A106KP8NNNC
100nF | C5,C7,C8,C11,C13,C14,C15,C16 | C_0402_1005Metric | C1525 | CL05B104KO5NNNC
4.7uF | C6 | C_0603_1608Metric | C19666 | CL10A475KO8NNNC
1uF | C12 | C_0402_1005Metric | C52923 | CL05A105KA5NQNC
B5819W | D1 | D_SOD-123 | C8598 | B5819W SL
1N4148WS | D2 | D_SOD-323 | C2128 | 1N4148WS
SMF5.0A | D3 | D_SOD-123F | C1509112 | SMF5.0A
USB-C | J1 | USB_C_Receptacle_HRO_TYPE-C-31-M-12 | C165948 | TYPE-C-31-M-12
red | LED1 | LED_0603_1608Metric | C2286 | KT-0603R
AO3401A | Q1,Q2 | SOT-23 | C15127 | AO3401A
AO3400A | Q3,Q4 | SOT-23 | C20917 | AO3400A
5.1k | R1,R2 | R_0402_1005Metric | C25905 | 0402WGF5101TCE
10k | R3,R5,R6,R8,R10,R11,R12 | R_0402_1005Metric | C25744 | 0402WGF1002TCE
1k | R4,R13,R14 | R_0402_1005Metric | C11702 | 0402WGF1001TCE
100k | R7,R9,R15 | R_0402_1005Metric | C25741 | 0402WGF1003TCE
0R | R16,R18 | R_0402_1005Metric | C17168 | 0402WGF0000TCE
47k | R20 | R_0402_1005Metric | C25792 | 0402WGF4702TCE
B3U-3100P | SW1 | SW_SPST_B3U-3100P |  | B3U-3100P
MDBT50Q-1MV2 | U1 | Raytac_MDBT50Q |  | MDBT50Q-1MV2
MCP73832-2 | U2 | SOT-23-5 | C38066 | MCP73832T-2ACI/OT
USBLC6-2SC6 | U3 | SOT-23-6 | C7519 | USBLC6-2SC6
LIS3DH | U4 | LGA-16_3x3mm_P0.5mm_LayoutBorder3x5y | C15134 | LIS3DHTR
LTR-303ALS-01 | U5 | Lite-On_LTR-303ALS-01 | C364577 | LTR-303ALS-01
SPH0641LM4H-1 | U6 | Knowles_LGA-5_3.5x2.65mm | C497724 | SPH0641LM4H-1
