olerast67/emotion-keychain/hardware/rev-b/case/out/case-acrylic-3mm.dxf

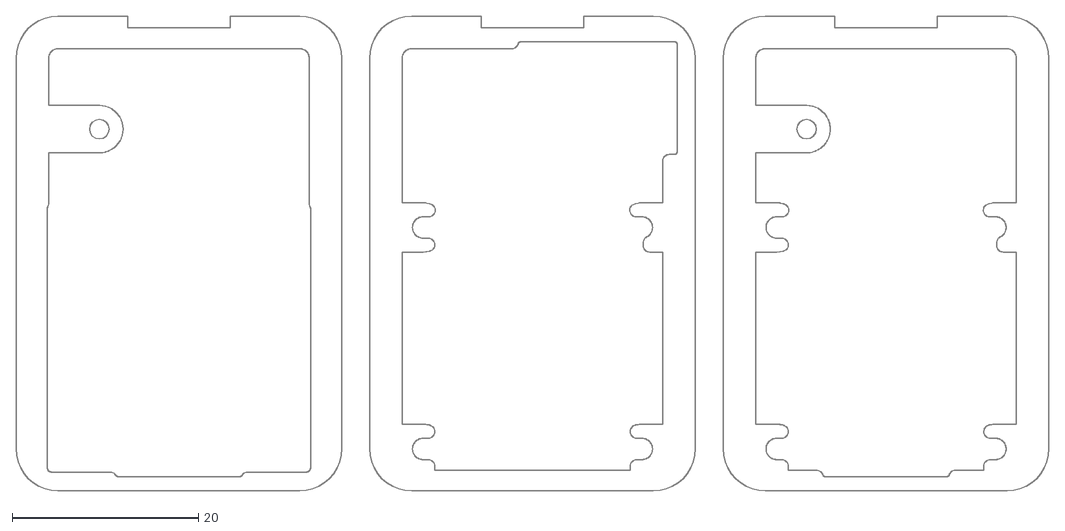
[picture p12: CAD file, 2026-10-28]
hardware/rev-b/case/out/case-acrylic-3mm.dxf
111.0 x 51.0
