olerast67/emotion-keychain/hardware/rev-b/case/out/l/case-acrylic-4mm.dxf

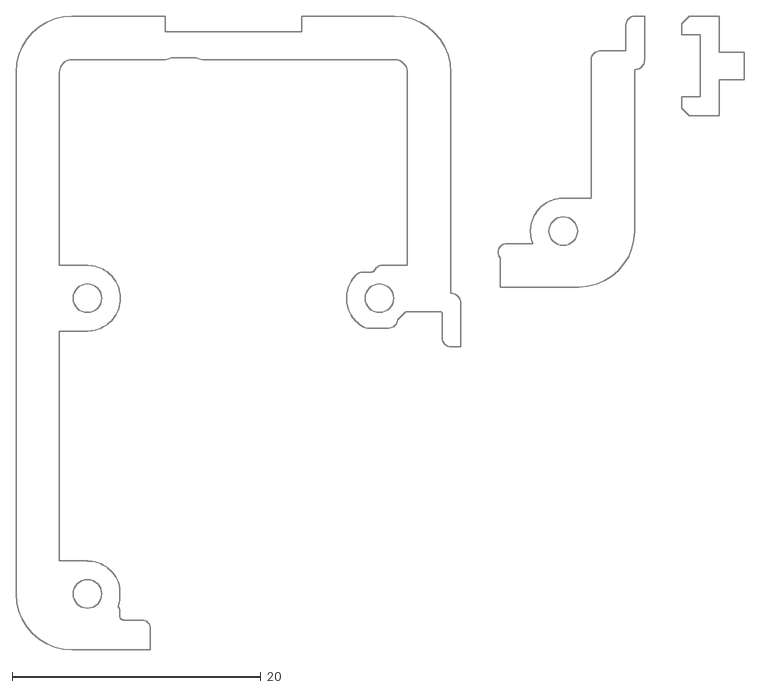
[picture p13: CAD file, 2026-10-28]
hardware/rev-b/case/out/l/case-acrylic-4mm.dxf
58.6 x 51.0
