olerast67/emotion-keychain/hardware/rev-b/case/out/m/case-acrylic-4mm.dxf

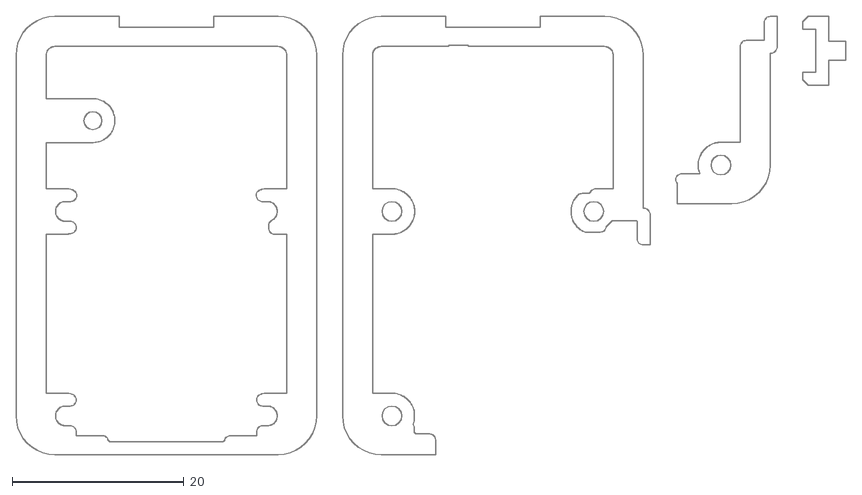
[picture p14: CAD file, 2026-10-28]
hardware/rev-b/case/out/m/case-acrylic-4mm.dxf
96.6 x 51.0
