olerast67/emotion-keychain/hardware/rev-b/case/out/l/case-acrylic-5mm.dxf

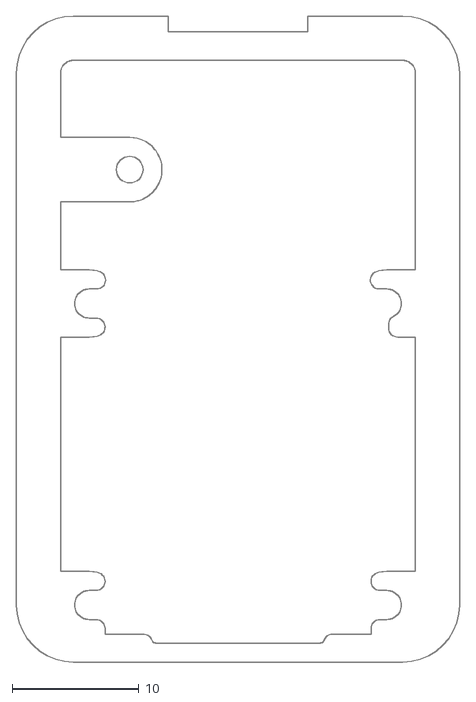
[picture p15: CAD file, 2026-10-28]
hardware/rev-b/case/out/l/case-acrylic-5mm.dxf
35.0 x 51.0
