olerast67/emotion-keychain/hardware/rev-b/case/out/m/case-acrylic-2mm.dxf

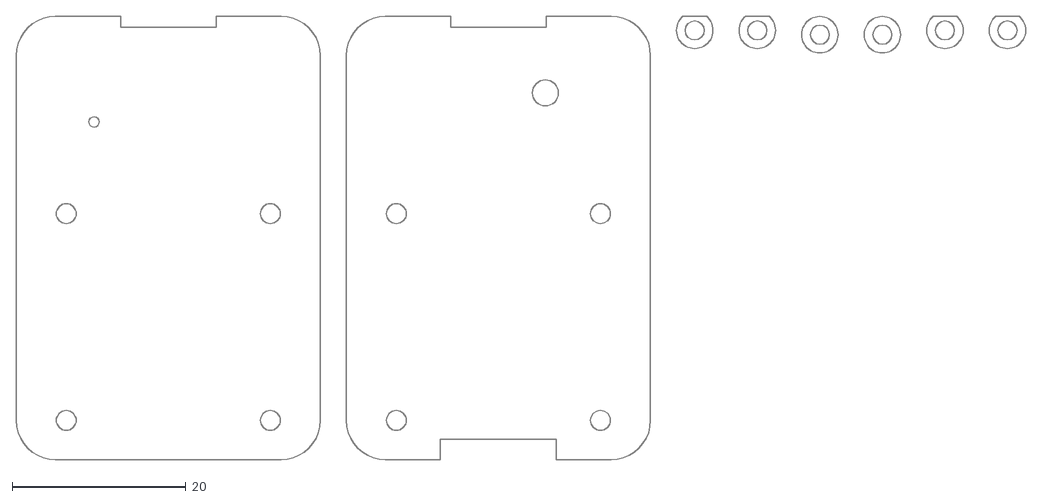
[picture p16: CAD file, 2026-10-28]
hardware/rev-b/case/out/m/case-acrylic-2mm.dxf
116.2 x 51.0
