olerast67/emotion-keychain/hardware/rev-b/case/out/l/case-acrylic-3mm.dxf

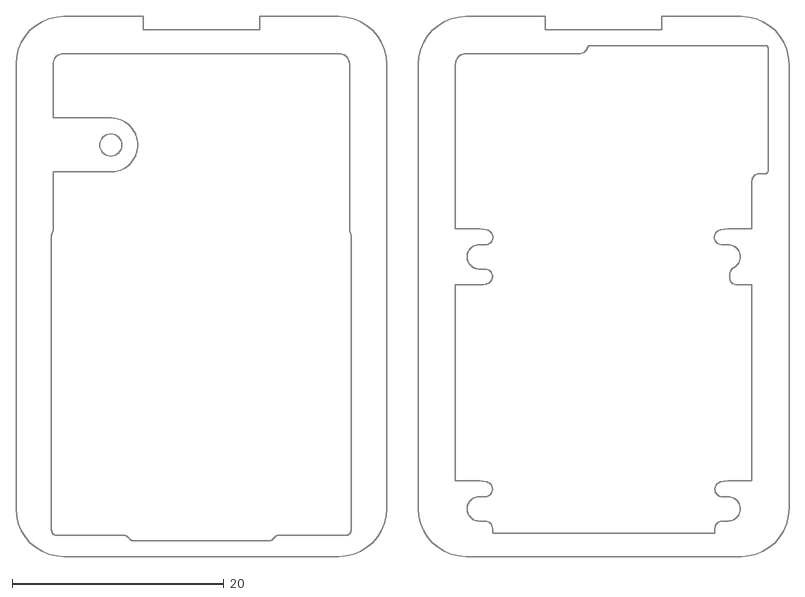
[picture p17: CAD file, 2026-10-28]
hardware/rev-b/case/out/l/case-acrylic-3mm.dxf
73.0 x 51.0
