olerast67/emotion-keychain/docs/user-guide.md

[English](user-guide.en.md) | Русский

# Брелок с эмоциями: памятка владельцу

Брелок на рюкзак с маленьким экраном, на котором живёт персонаж. Он моргает, оглядывается, радуется, злится, засыпает в темноте и отвечает на касания, тряску, звук и свет. Характер и внешность у каждого брелока свои, на всю жизнь. Он растёт: за месяц вместе открывает всё новые эмоции. Рядом с другими такими брелоками знакомится, дружит и устраивает дуэли.

Брелок в корпусе

## Коротко

| Что | Как |
|---|---|
| Включить | короткое нажатие кнопки или подключить зарядку |
| Выключить | держать кнопку 3 секунды |
| Дуэли вкл/выкл | двойное нажатие кнопки |
| Звук вкл/выкл | тройное нажатие кнопки |
| Зарядить | USB-C, обычная зарядка 5 В или компьютер, в тепле: 10–42 °C |
| Заряжается | сзади ярко горит красный огонёк |
| Хватает на | около 11, 15 или 18 дней обычной носки — версии S, M, L |

## Что где

- **Экран** — спереди, под прозрачной крышкой.
- **Кнопка** — на правом торце, если смотреть на экран.
- **USB-C** — на нижнем торце.
- **Ушко для кольца** — сверху.
- **Красный огонёк зарядки** — сзади, сквозь прозрачное дно, внизу рядом с разъёмом.
- **Отверстие пищалки** — в дне. Не заклеивайте его: лёжа на спине брелок звучит тише.

Внутри — литий-полимерный аккумулятор. Три версии различаются только им, а с ним и толщиной:

| Версия | Аккумулятор | Обычный день | Лицо 16 ч в сутки |
|---|---|---|---|
| S | ~150 мА·ч | ~11 дней | ~3 дня |
| M | ~200 мА·ч | ~15 дней | ~4 дня |
| L | ~250 мА·ч | ~18 дней | ~5 дней |

Обычный день — 3 часа лица на свету, час в полутьме, остальное время в кармане и ночью. Это расчёт; на настоящем брелоке может выйти чуть меньше.

## Первое включение

1. Нажмите кнопку на правом торце. Появится загрузка OLERAST LINK с мелодией, потом лицо.
2. Не включается — подключите зарядку (ниже). Подключённый брелок включается сам.
3. Знакомьтесь. Персонаж выбирает реакцию сам, а его характер — один из десяти: игрун, ворчун, соня, скромник, любопытный, пофигист, драма, глюк, хитрец, добряк. Примерно один брелок из десяти — редкий, один из ста — легендарный, с золотым кибер-глазом.

## Кнопка

| Нажатие | Что будет |
|---|---|
| Короткое | персонаж отвечает: «тык!», привет, подмигивание. Погасший в темноте экран включается |
| Двойное | дуэли включаются или выключаются. На экране DUELS ON и READY TO HACK — включены, DUELS OFF и PEACE MODE — выключены. С завода включены |
| Тройное | звук выключается или включается: SOUND OFF и SILENT MODE — брелок молчит, SOUND ON — пищит снова. Настройка сохраняется и после выключения |
| Держать 3 с | выключение: персонаж сразу прощается надписью GOODNIGHT, даже посреди встречи или другой сцены, и секунд через 7 от начала нажатия экран гаснет |
| Включить снова | короткое нажатие или подключить зарядку |

- **Нажатия подряд.** Нажатия считаются подряд, если следующее начинается не позже чем через 0.4 с после того, как отпустили прошлое; само нажатие может быть и долгим. С паузой дольше каждое нажатие — отдельное. Удержание 3 с после пары нажатий — только выключение.
- **Кнопку при включении можно держать** «пока не включится»: такое нажатие не выключит брелок обратно. Если брелок выключен на зарядке, он включается, когда кнопку отпустят: нажмите коротко. Держать дольше 10 с не нужно — это режим новой прошивки (диск KEYCHAIN).
- **Не держите кнопку, когда подключаете кабель.** Это особый режим для новой прошивки: экран тёмный и зарядка не идёт. От розетки брелок сам выйдет из него за 10 секунд. На компьютере появится диск KEYCHAIN — отключите кабель и подключите снова, уже не трогая кнопку. Ничего на этот диск не копируйте, если продавец не прислал вам новую прошивку.

## Касания и жесты

- **Тап** — лёгкий стук пальцем по корпусу. Два тапа подряд — ответ по характеру: игрун смеётся, хитрец злорадно хохочет, добряк и драма влюбляются, любопытный восхищается, пофигист изображает крутого, ворчун смотрит с неодобрением, соня зевает и потягивается, скромник смущается, глюк выдаёт ошибку. Много тапов подряд персонажу надоедают: раздражение, злость, а в конце — переворот стола. Когда злость пройдёт, тапните ещё раз — он смутится и извинится.
- **Взяли в руки** — радуется или настораживается, сонный просыпается.
- **Тряска** — удивление, сильная и долгая — головокружение, а в транспорте его может укачать.
- **Падение** — ужас, потом нокаут; третье падение за 10 минут — GAME OVER. Лучше не ронять: корпус из акрила.
- **Вверх ногами** — растерянность.
- **Звук.** Хлопок пугает, разговор он слушает, под музыку качается.
- **Ходьба и бег** — шагает вместе с вами, шаги идут в его опыт.
- **Свет и темнота** — ниже, в «Ночь и часы».

## Что значат лица

Всего эмоций 139 — все они на [листе эмоций](img/emotions_sheet.gif) и в [каталоге](emotions.md) с объяснением, когда каждая появляется. Главные, которые что-то сообщают:

| Лицо | Что значит |
|---|---|
| Батарея наливается, процент или CHARGING | подключили зарядку |
| «Кушает» | идёт зарядка; так он выглядит, пока кабель подключён, и после полной зарядки тоже |
| «Заряжен», восторг, `$_$` | зарядился до конца |
| «Голод», «Мало заряда» | заряда 15 % и меньше: экономит, сюрпризов нет |
| «Почти разряжен» | 5 % и меньше: пора заряжать |
| GOODNIGHT | выключается кнопкой |
| LOW BATTERY с батарейкой, потом GOODNIGHT | аккумулятор пуст, брелок выключается сам |
| Сон, Zzz | темно; «сонный» — устал или давно без дела |
| «Холодно», «Жарко» | датчик в процессоре: ниже ~5 °C или выше ~38 °C |
| Скука, одиночество | давно никто не трогал |
| Надпись NEW в углу | новая эмоция, только что открылась |

## Зарядка

1. **Подключите USB-C** к зарядке телефона (5 В), к компьютеру или к пауэрбанку. Быстрая зарядка тоже подходит: брелок берёт у неё только 5 В. Некоторые пауэрбанки отключаются сами, если ток маленький, — тогда заряжайте от сети.
2. **Сзади ярко загорится красный огонёк.** На экране батарея наливается до процента заряда, потом персонаж «кушает».
3. **Зарядился** — огонёк уже не горит ярко, а лишь еле тлеет. Персонаж на миг радуется. От пустого до полного — около 2–3 часов: у S быстрее, у L дольше.

- **Процент на экране — оценка.** Самый надёжный признак конца зарядки — огонёк. От слабого USB-порта (старый компьютер, длинный тонкий кабель) брелок может не заметить конец зарядки и не показать «заряжен», хотя сама зарядка закончится правильно.
- **Заряжается при 10–42 °C** (по датчику в процессоре). На холоде брелок ждёт, пока согреется: огонёк ярко не горит, сцены зарядки нет. С мороза положите его в тепло на 30–60 минут — зарядка начнётся сама. Выше 45 °C зарядка останавливается.
- **Выключенный брелок от зарядки включается.** Хотите, чтобы он заряжался выключенным, — подержите кнопку 3 секунды уже на зарядке: экран погаснет, а зарядка продолжится. Включить — короткое нажатие.
- **Компьютер увидит новое USB-устройство** (последовательный порт) — это служебная связь для энтузиастов, ставить ничего не нужно.
- **На зарядке без дела** через 10 минут по экрану летает логотип, как старая заставка DVD. Иногда он попадает точно в угол.
- **Не заряжайте** под подушкой, на кровати и без присмотра на ночь — так советуют для любого литиевого аккумулятора.

## Когда заряд кончается

- **15 % и меньше** — «голод» и «мало заряда», две грустные ноты. Брелок экономит: кадры реже, сюрпризов нет.
- **5 % и меньше** — «почти разряжен».
- **Пусто** — брелок сам прощается (LOW BATTERY, GOODNIGHT) и выключается, пока аккумулятор ещё цел. После этого нажатие кнопки на миг покажет пустую батарею и снова выключит брелок: включить его можно, только зарядив.
- **Зарядите его в течение недели.** Выключенный брелок понемногу тратит остаток, а дольше аккумулятор разряжается слишком глубоко и портится.

## Встречи и дуэли

**Встреча.** Два брелока рядом, в 1–3 метрах, узнают друг друга по радио сами — без телефона, приложений и пароля. Оба должны бодрствовать на свету: в кармане, в темноте и во сне брелок встреч не ищет. Обычно встреча начинается через 1–3 минуты, изредка до 5–7: брелоки слушают радио короткими окнами, чтобы беречь заряд.

- **Новый знакомый** — NEW FRIEND и код соседа вида `K7-3F2A`, короткая вибрация. Старый — HI AGAIN.
- **С завода дуэли включены.** Если они включены и у соседа, первая встреча дня с ним — сразу дуэль (ниже), а не приветствие. Знакомство засчитывается, но надписей NEW FRIEND с кодом соседа и TWIN! не будет, а следующая встреча с ним в тот же день — уже HI AGAIN. Чтобы увидеть NEW FRIEND, выключите дуэли двойным нажатием хотя бы на одном брелоке.
- **С одним и тем же соседом** — не чаще раза в 10 минут. Если брелоки весь день рядом (на одной связке ключей), перерывы растут: 10, 20, 40, 80, 160 минут.
- **Награды за встречи ограничены за сутки:** опыт дают только первые несколько встреч дня.
- **Персонажи реагируют друг на друга по характеру:** скромник смущается, добряк влюбляется, ворчун закатывает глаза. Одинаковые характеры видят TWIN!.

**Дуэль.** Хакерская дуэль бывает, если у обоих дуэли включены (двойное нажатие), — с одним брелоком раз в день. Победитель видит WIN! и досрочно открывает новую эмоцию, проигравший — LOST и обижается. После дуэли брелоки «переговариваются» пищалками шифром, а на экране в конце мелькает ACCESS DENIED.

**Дружба** растёт по дням, в которые брелоки виделись. Сколько бы раз за день они ни встретились, считается один день.

| Дней встреч | Уровень |
|---|---|
| 1 | NEW FRIEND — новый знакомый |
| 3 | BUDDY — приятель |
| 7 | FRIENDS — друзья |
| 15 | BEST FRIENDS — лучшие друзья |
| 30 | BFF — друзья навсегда |

Брелок постарше раз в день может подарить младшему эмоцию (сцена GIFT).

**Что брелок рассказывает по радио:** только свой код, уровень и настроение. Ничего личного в нём нет. Но код постоянный, поэтому брелок узнаваем по радио — как беспроводные наушники.

## Рост

Новый брелок знает 44 эмоции. Остальные открываются «имплантами» за опыт: дни вместе, касания, шаги, встречи, дуэли, зарядку, когда он голоден. При обычной носке всё открывается примерно за месяц. Новая эмоция отмечается надписью NEW. Есть ещё 24 достижения с кубком — например, первый друг, 10 000 шагов, серия дней вместе. Открыть на брелоке пока можно 23: секретный стук (KNOCK KNOCK) на нём ещё не срабатывает. Рост и друзья хранятся в памяти брелока и не пропадают при выключении.

## Ночь и часы

- **Часов с батарейкой у брелока нет.** Ночь он узнаёт по темноте: в кармане, в сумке, в тёмной комнате секунд через десять засыпает, а через минуту гасит экран, чтобы беречь заряд. На свету лицо возвращается через 2–4 секунды, а от тапа или кнопки — сразу.
- **Праздники и пасхалки по дате и времени** — Новый год, день рождения, 13:37 и другие — работают, только если задать дату и время с компьютера (ниже, «Для энтузиастов»). После выключения кнопкой или на пустом аккумуляторе их нужно задать снова.

## Хранение

- **Надолго убираете — выключите** (держать кнопку 3 с). Включённый брелок в ящике тоже тратит заряд, примерно 3 мА·ч в сутки, выключенный — примерно в 10 раз меньше.
- **Оставляйте заряженным примерно наполовину** и подзаряжайте раз в 2–3 месяца.
- **После выключения на пустом аккумуляторе** — зарядить в течение недели.
- Храните в сухом месте при комнатной температуре.

## Уход и безопасность

- **Внутри литий-полимерный аккумулятор.** Не прокалывайте, не сгибайте и не сдавливайте брелок, не разбирайте его.
- **Не нагревайте:** не оставляйте на солнце за стеклом машины, у батареи отопления, у огня.
- **Не водонепроницаем.** Не мочите и не мойте. Намок — вытрите и не заряжайте, пока не высохнет совсем, хотя бы сутки.
- **Кабель USB-C — обычный.** У кабелей в толстой оплётке корпус вилки бывает толще, и такая вилка упирается в корпус брелока и не входит до упора: возьмите другой кабель. В разъём не засовывайте ничего, кроме вилки.
- **Вздулся** — корпус выпучился, крышка или дно отходят, экран вдавлен изнутри: не заряжайте и не пользуйтесь, не прокалывайте. Положите на негорючую поверхность подальше от вещей и верните продавцу или сдайте в пункт приёма батареек.
- **Корпус треснул** так, что виден аккумулятор, — не заряжайте, обратитесь к продавцу.
- **Чистка** — сухой мягкой тканью. От спирта и растворителей на акриле появляются трещинки.
- **Не для детей младше 14 лет:** мелкие детали (кольцо, винты, гайки), аккумулятор внутри. Это не игрушка.
- **Выбрасывать** — не с бытовым мусором, а в пункт приёма батареек или электроники.

## Если что-то не так

| Что случилось | Что сделать |
|---|---|
| Не включается | короткое нажатие кнопки. Не помогло — подключите зарядку. Если на миг показалась пустая батарея — аккумулятор пуст, заряжайте |
| Экран погас сам | в темноте так и задумано: вынесите на свет, тапните или нажмите кнопку |
| Завис: лицо застыло, на касания и кнопку не отвечает | подождите 10 секунд — он перезапустится сам. Не помогло — держите кнопку 3 секунды, потом короткое нажатие. На зарядке — отключите кабель и подключите снова |
| Не заряжается: огонёк ярко не горит | согрейте до комнатной температуры (с мороза — 30–60 минут); вставьте кабель до упора; попробуйте другой кабель и другую зарядку |
| Экран тёмный на зарядке, на компьютере диск KEYCHAIN | кнопку держали при подключении или долго держали, включая брелок на зарядке: отключите кабель и подключите снова, не трогая кнопку |
| Сам выключается или не замечает кнопку, будто её держат | нужна подстройка корпуса у кнопки — обратитесь к продавцу |
| Не встречает другие брелоки | подождите до 5–7 минут; оба на свету, не в кармане и не спят; ближе 1–3 метров; с этим соседом недавно встречались — перерыв 10 минут и дольше. Для дуэли дуэли включены у обоих |
| Два новых брелока показали DUEL, а не NEW FRIEND | так и задумано: с завода дуэли включены, и первая встреча дня — дуэль. Знакомство засчитано |
| Не пищит | звук выключен — нажмите кнопку три раза подряд (SOUND ON); отверстие пищалки в дне не заклеено |
| Лицо тусклое, хотя светло | персонаж сонный или спит — так он бережёт заряд; тапните или нажмите кнопку. Если время задано с компьютера, с 23:00 до 6:00 экран ещё и приглушён, а голос тихий |

## Для энтузиастов

У брелока есть консоль по USB. Подключите его к компьютеру и откройте любой терминал последовательного порта, например монитор порта Arduino IDE, на скорости 115200 и с любым концом строки, кроме «No Line Ending» ([подробно](../firmware/release/README.md#какая-прошивка-в-брелоке)). Команду наберите и нажмите Enter; `?` выводит список.

- `t 14:30`, `date 2026-12-31` — время и дата: для тихих ночных часов, праздников и пасхалок. После выключения кнопкой их нужно задать снова.
- `bday 05-14` — ваш день рождения: в этот день брелок покажет торт (если задана дата).
- `snd` — звук вкл/выкл (как тройное нажатие), `theme cyber` или `theme retro` — другая тема, `theme classic` — обычная.
- `ghost` — «невидимка»: брелок не показывается другим и не встречается.
- `me` — кто он, сколько шагов, друзей и дуэлей; `ver` — версия прошивки.

## Открытый код

Брелок — открытый проект: код прошивки и движка — под Apache-2.0, файлы платы и корпуса — под CERN-OHL-W-2.0, эта памятка и картинки — под CC-BY-4.0. В прошивке есть и чужой открытый код: ядро Arduino для nRF52 и библиотеки Adafruit, Nordic, Arm и FreeRTOS. Их уведомления об авторских правах и тексты лицензий, а также полные исходники прошивки — по ссылкам:

- уведомления и лицензии: [THIRD_PARTY_NOTICES.md](https://github.com/olerast67/emotion-keychain/blob/main/THIRD_PARTY_NOTICES.md);
- исходники прошивки и всего проекта: <https://github.com/olerast67/emotion-keychain>.

## Карточка в коробку

> **Брелок с эмоциями**
>
> **Кнопка** на правом торце: нажать — включить или ответить, два раза — дуэли вкл/выкл, три раза — звук вкл/выкл, держать 3 с — выключить.
>
> **Зарядка:** USB-C, 5 В, в тепле (10–42 °C). Сзади ярко горит красный огонёк — заряжается. Еле тлеет — заряжен или заряд ждёт тепла: если при подключении на экране не появилась батарея, согрейте брелок. С мороза — сначала 30–60 минут в тепле. Не держите кнопку, когда подключаете кабель.
>
> **Пустой аккумулятор** — брелок сам скажет GOODNIGHT и выключится. Зарядите его в течение недели. На хранение — заряд наполовину, подзаряжать раз в 2–3 месяца.
>
> **Осторожно:** внутри литиевый аккумулятор. Не мочить, не нагревать, не сдавливать, ничего не засовывать в разъём. Вздулся — не заряжать и вернуть продавцу. Не для детей младше 14 лет.
>
> **Встречи:** два брелока на свету в 1–3 м сами знакомятся и дружат, обычно за 1–3 минуты, изредка до 5–7. Вся памятка — по ссылке или QR-коду на коробке.
