olerast67/emotion-keychain/hardware/rev-b/out/keychain-rev-b-assembly-bottom.png

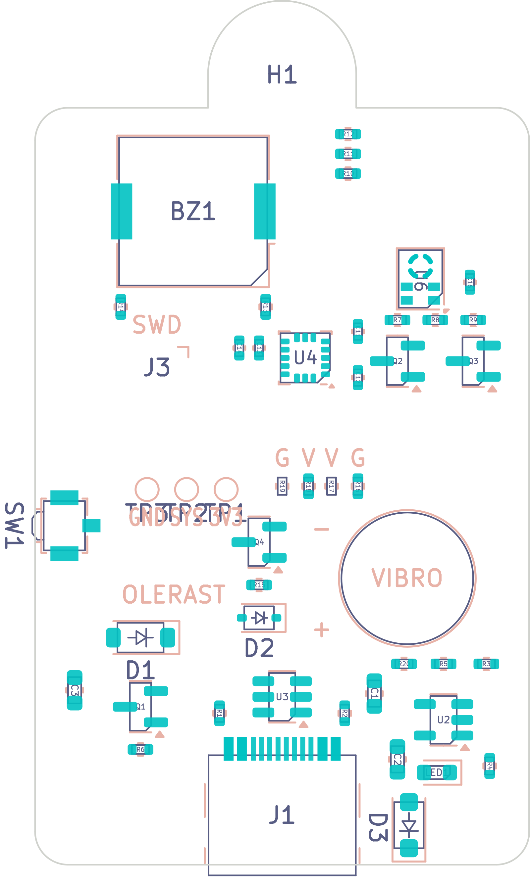
hardware/rev-b/out/keychain-rev-b-assembly-bottom.png
