olerast67/emotion-keychain/hardware/rev-b/out/keychain-rev-b-assembly-top.png

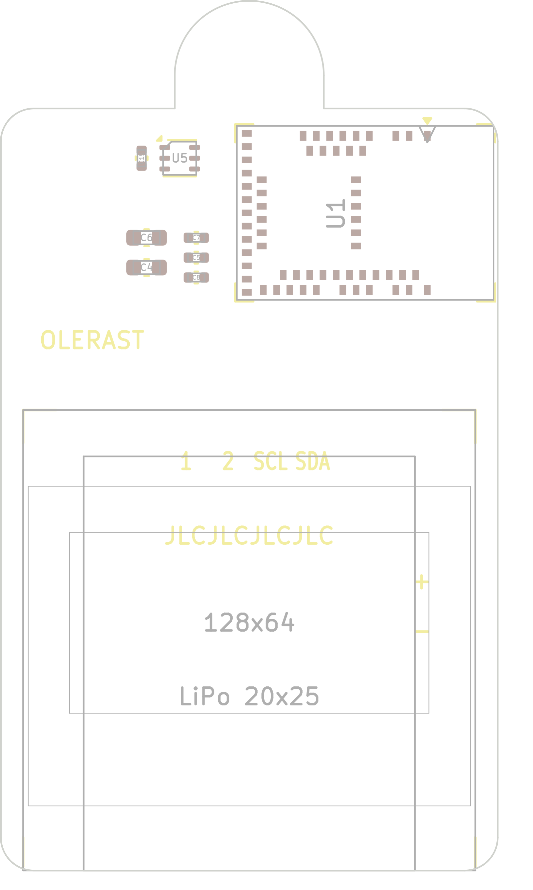
hardware/rev-b/out/keychain-rev-b-assembly-top.png
