olerast67/emotion-keychain/hardware/rev-b/out/panel/keychain-rev-b-panel-assembly-bottom.png

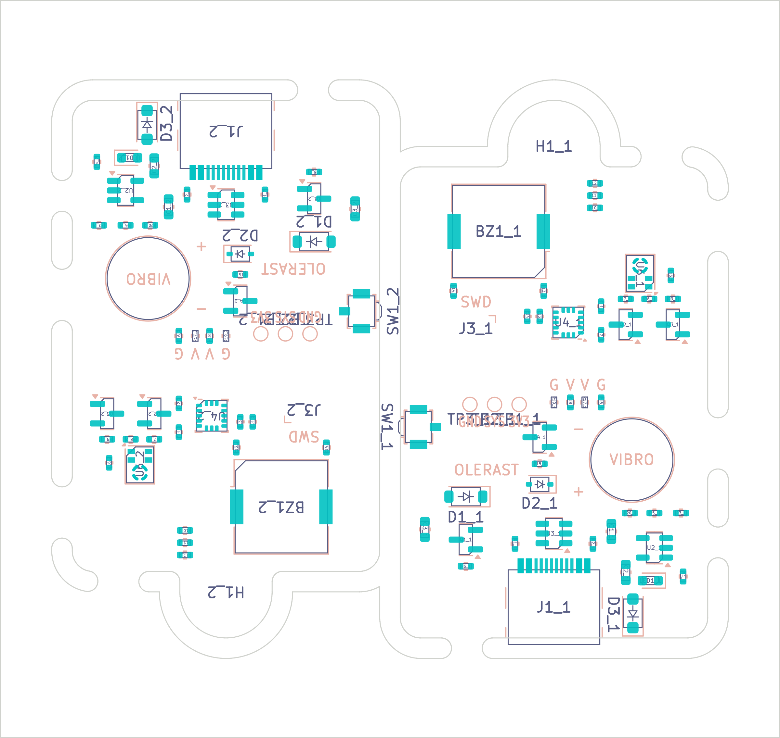
hardware/rev-b/out/panel/keychain-rev-b-panel-assembly-bottom.png
