olerast67/emotion-keychain/hardware/rev-b/out/panel/keychain-rev-b-panel-assembly-top.png

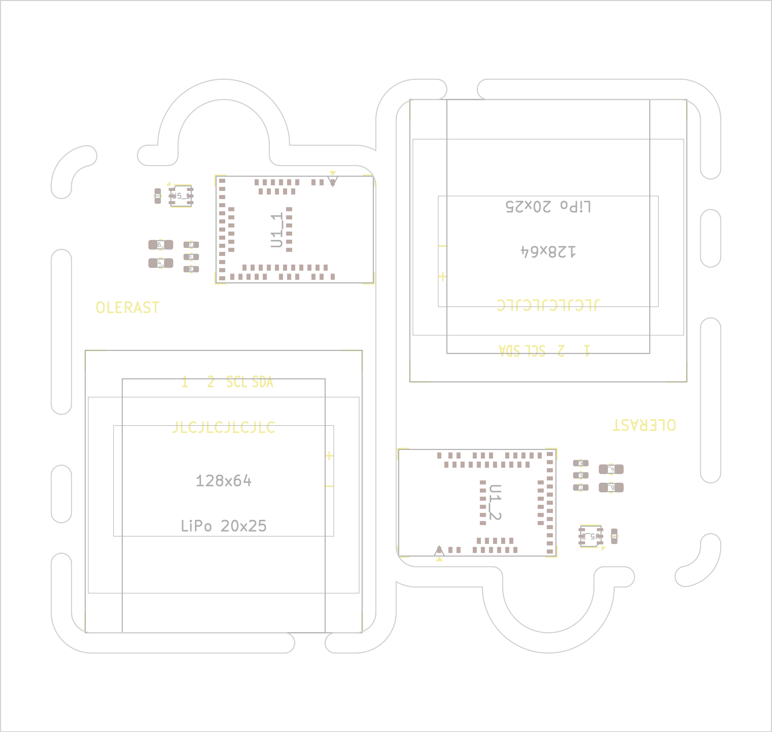
hardware/rev-b/out/panel/keychain-rev-b-panel-assembly-top.png
