olerast67/emotion-keychain/hardware/rev-b/keychain-rev-b.kicad_pcb

## KiCad design hardware/rev-b/keychain-rev-b.kicad_pcb (2026-10-28)

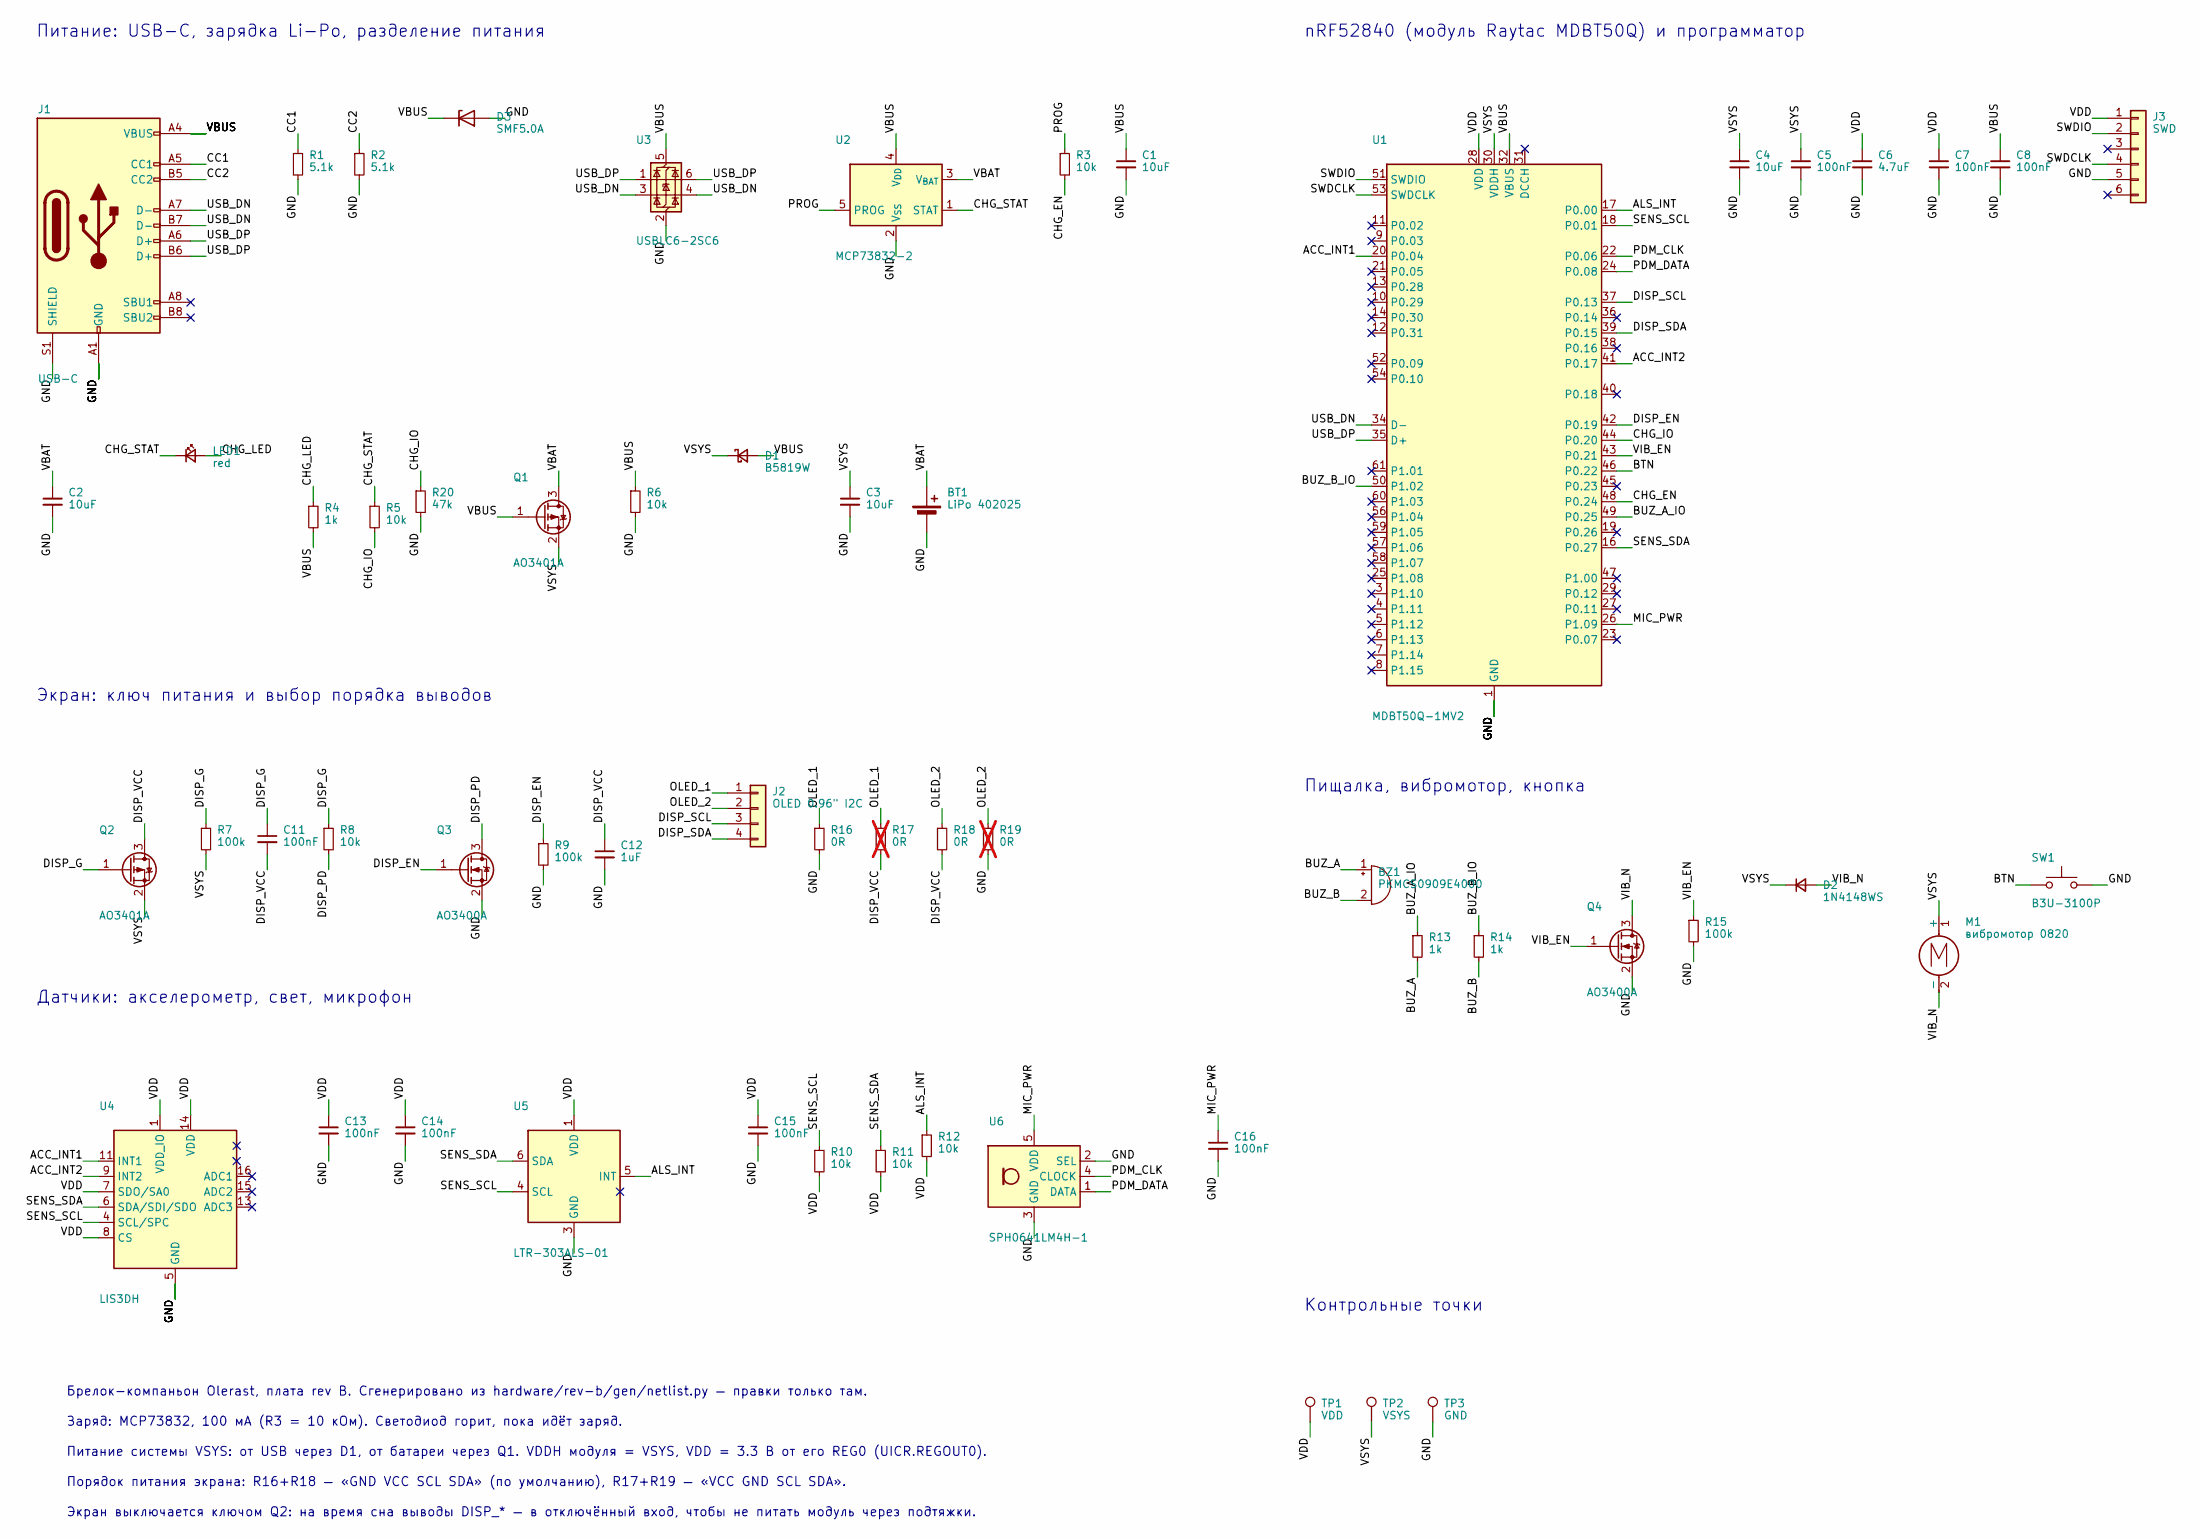
[picture p22: schematic keychain-rev-b.kicad_sch, Брелок-компаньон Olerast]

Parts:
BT1: LiPo 402025; LiPo_Pads_20x25mm
BZ1: PKMCS0909E4000; Buzzer_Murata_PKMCS0909E; MPN PKMCS0909E4000-R1; LCSC C910763
C1, C2, C3, C4: 10uF; C_0603_1608Metric; MPN CL10A106KP8NNNC; LCSC C19702
C5, C7, C8, C11, C13, C14, C15, C16: 100nF; C_0402_1005Metric; MPN CL05B104KO5NNNC; LCSC C1525
C6: 4.7uF; C_0603_1608Metric; MPN CL10A475KO8NNNC; LCSC C19666
C12: 1uF; C_0402_1005Metric; MPN CL05A105KA5NQNC; LCSC C52923
D1: B5819W; D_SOD-123; MPN B5819W SL; LCSC C8598
D2: 1N4148WS; D_SOD-323; MPN 1N4148WS; LCSC C2128
D3: SMF5.0A; D_SOD-123F; MPN SMF5.0A; LCSC C1509112
J1: USB-C; USB_C_Receptacle_HRO_TYPE-C-31-M-12; MPN TYPE-C-31-M-12; LCSC C165948
J2: OLED 0.96" I2C; OLED_SSD1306_0.96in_I2C_Module
J3: SWD; Tag-Connect_TC2030-IDC-NL_2x03_P1.27mm_Vertical
LED1: red; LED_0603_1608Metric; MPN KT-0603R; LCSC C2286
M1: вибромотор 0820; VibroMotor_Coin_D8mm
Q1, Q2: AO3401A; SOT-23; MPN AO3401A; LCSC C15127
Q3, Q4: AO3400A; SOT-23; MPN AO3400A; LCSC C20917
R1, R2: 5.1k; R_0402_1005Metric; MPN 0402WGF5101TCE; LCSC C25905
R3, R5, R6, R8, R10, R11, R12: 10k; R_0402_1005Metric; MPN 0402WGF1002TCE; LCSC C25744
R4, R13, R14: 1k; R_0402_1005Metric; MPN 0402WGF1001TCE; LCSC C11702
R7, R9, R15: 100k; R_0402_1005Metric; MPN 0402WGF1003TCE; LCSC C25741
R16, R18: 0R; R_0402_1005Metric; MPN 0402WGF0000TCE; LCSC C17168
R17, R19: 0R; R_0402_1005Metric; MPN 0402WGF0000TCE; LCSC C17168; not fitted
R20: 47k; R_0402_1005Metric; MPN 0402WGF4702TCE; LCSC C25792
SW1: B3U-3100P; SW_SPST_B3U-3100P; MPN B3U-3100P
TP1: VDD; TestPoint_Pad_D1.0mm
TP2: VSYS; TestPoint_Pad_D1.0mm
TP3: GND; TestPoint_Pad_D1.0mm
U1: MDBT50Q-1MV2; Raytac_MDBT50Q; MPN MDBT50Q-1MV2
U2: MCP73832-2; SOT-23-5; MPN MCP73832T-2ACI/OT; LCSC C38066
U3: USBLC6-2SC6; SOT-23-6; MPN USBLC6-2SC6; LCSC C7519
U4: LIS3DH; LGA-16_3x3mm_P0.5mm_LayoutBorder3x5y; MPN LIS3DHTR; LCSC C15134
U5: LTR-303ALS-01; Lite-On_LTR-303ALS-01; MPN LTR-303ALS-01; LCSC C364577
U6: SPH0641LM4H-1; Knowles_LGA-5_3.5x2.65mm; MPN SPH0641LM4H-1; LCSC C497724

Connections:
ACC_INT1: U1.20 (P0.04), U4.11 (INT1)
ACC_INT2: U1.41 (P0.17), U4.9 (INT2)
ALS_INT: R12.1, U1.17 (P0.00), U5.5 (INT)
BTN: SW1.1, U1.46 (P0.22)
BUZ_A: BZ1.1 (+), R13.2
BUZ_A_IO: R13.1, U1.49 (P0.25)
BUZ_B: BZ1.2 (-), R14.2
BUZ_B_IO: R14.1, U1.50 (P1.02)
CC1: J1.A5 (CC1), R1.1
CC2: J1.B5 (CC2), R2.1
CHG_EN: R3.2, U1.48 (P0.24)
CHG_IO: R5.2, R20.1, U1.44 (P0.20)
CHG_LED: LED1.2 (A), R4.1
CHG_STAT: LED1.1 (K), R5.1, U2.1 (STAT)
DISP_EN: Q3.1 (G), R9.1, U1.42 (P0.19)
DISP_G: C11.1, Q2.1 (G), R7.1, R8.1
DISP_PD: Q3.3 (D), R8.2
DISP_SCL: J2.3, U1.37 (P0.13)
DISP_SDA: J2.4, U1.39 (P0.15)
DISP_VCC: C11.2, C12.1, Q2.3 (D), R17.2, R18.2
GND: BT1.2 (-), C1.2, C2.2, C3.2, C4.2, C5.2, C6.2, C7.2, C8.2, C12.2, C13.2, C14.2, C15.2, C16.2, D3.2 (A), J1.A1 (GND), J1.A12 (GND), J1.B1 (GND), J1.B12 (GND), J1.S1 (SHIELD), J3.5, Q3.2 (S), Q4.2 (S), R1.2, R2.2, R6.2, R9.2, R15.2, R16.2, R19.2, R20.2, SW1.2, SW1.3, TP3.1, U1.1 (GND), U1.2 (GND), U1.15 (GND), U1.33 (GND), U1.55 (GND), U2.2 (V_{SS}), U3.2 (GND), U4.5 (GND), U4.10 (GND), U4.12 (GND), U5.3 (GND), U6.2 (SEL), U6.3 (GND)
MIC_PWR: C16.1, U1.26 (P1.09), U6.5 (VDD)
OLED_1: J2.1, R16.1, R17.1
OLED_2: J2.2, R18.1, R19.1
PDM_CLK: U1.22 (P0.06), U6.4 (CLOCK)
PDM_DATA: U1.24 (P0.08), U6.1 (DATA)
PROG: R3.1, U2.5 (PROG)
SENS_SCL: R10.1, U1.18 (P0.01), U4.4 (SCL/SPC), U5.4 (SCL)
SENS_SDA: R11.1, U1.16 (P0.27), U4.6 (SDA/SDI/SDO), U5.6 (SDA)
SWDCLK: J3.4, U1.53 (SWDCLK)
SWDIO: J3.2, U1.51 (SWDIO)
USB_DN: J1.A7 (D-), J1.B7 (D-), U1.34 (D-), U3.3 (I/O2), U3.4 (I/O2)
USB_DP: J1.A6 (D+), J1.B6 (D+), U1.35 (D+), U3.1 (I/O1), U3.6 (I/O1)
VBAT: BT1.1 (+), C2.1, Q1.3 (D), U2.3 (V_{BAT})
VBUS: C1.1, C8.1, D1.2 (A), D3.1 (K), J1.A4 (VBUS), J1.A9 (VBUS), J1.B4 (VBUS), J1.B9 (VBUS), Q1.1 (G), R4.2, R6.1, U1.32 (VBUS), U2.4 (V_{DD}), U3.5 (VBUS)
VDD: C6.1, C7.1, C13.1, C14.1, C15.1, J3.1, R10.2, R11.2, R12.2, TP1.1, U1.28 (VDD), U4.1 (VDD_IO), U4.7 (SDO/SA0), U4.8 (CS), U4.14 (VDD), U5.1 (VDD)
VIB_EN: Q4.1 (G), R15.1, U1.43 (P0.21)
VIB_N: D2.2 (A), M1.2 (-), Q4.3 (D)
VSYS: C3.1, C4.1, C5.1, D1.1 (K), D2.1 (K), M1.1 (+), Q1.2 (S), Q2.2 (S), R7.2, TP2.1, U1.30 (VDDH)

Notes on the sheet:
Питание: USB-C, зарядка Li-Po, разделение питания
nRF52840 (модуль Raytac MDBT50Q) и программатор
Экран: ключ питания и выбор порядка выводов
Пищалка, вибромотор, кнопка
Датчики: акселерометр, свет, микрофон
Контрольные точки
Брелок-компаньон Olerast, плата rev B. Сгенерировано из hardware/rev-b/gen/netlist.py — правки только там.
Заряд: MCP73832, 100 мА (R3 = 10 кОм). Светодиод горит, пока идёт заряд.
Питание системы VSYS: от USB через D1, от батареи через Q1. VDDH модуля = VSYS, VDD = 3.3 В от его REG0 (UICR.REGOUT0).
Порядок питания экрана: R16+R18 — «GND VCC SCL SDA» (по умолчанию), R17+R19 — «VCC GND SCL SDA».
Экран выключается ключом Q2: на время сна выводы DISP_* — в отключённый вход, чтобы не питать модуль через подтяжки.

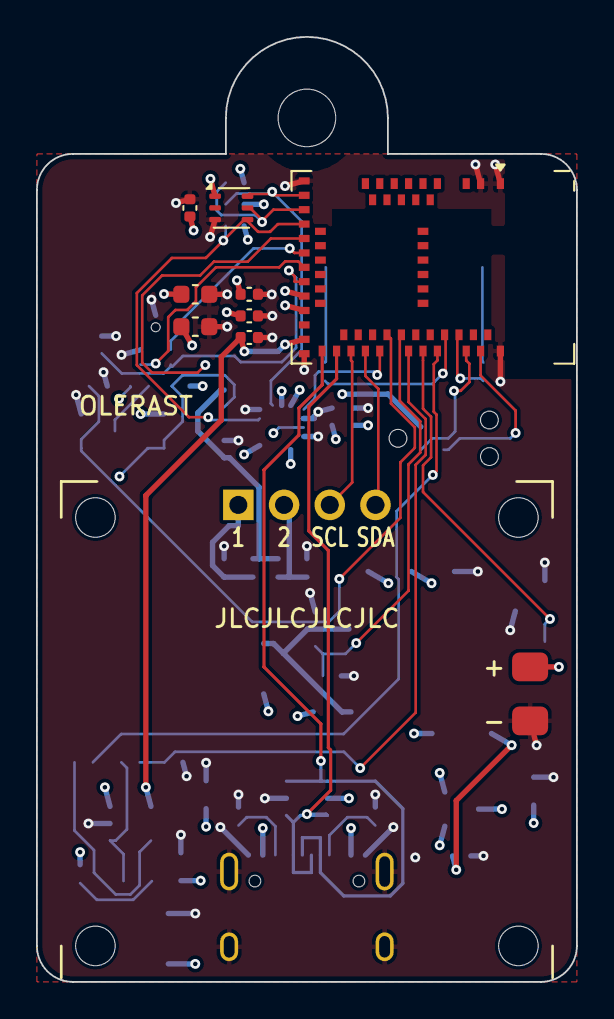
[picture p23: board keychain-rev-b.kicad_pcb from above]

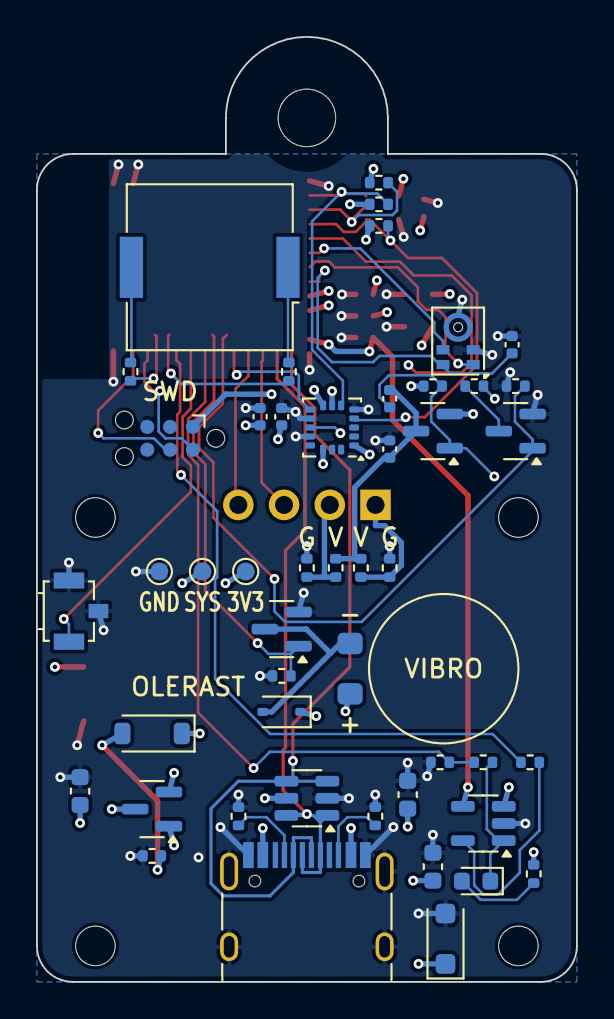
[picture p24: board keychain-rev-b.kicad_pcb from below]

Board: 4 copper layers, 30.0 x 52.5 mm, 59 parts (49 on the bottom side), 39 nets.

Other parts of the board:
H1: кольцо брелока или винт корпуса; MountingHole_3.2mm_M3
