olerast67/emotion-keychain/hardware/rev-b/out/panel/keychain-rev-b-panel.kicad_pcb

## KiCad design hardware/rev-b/out/panel/keychain-rev-b-panel.kicad_pcb (2026-10-28)

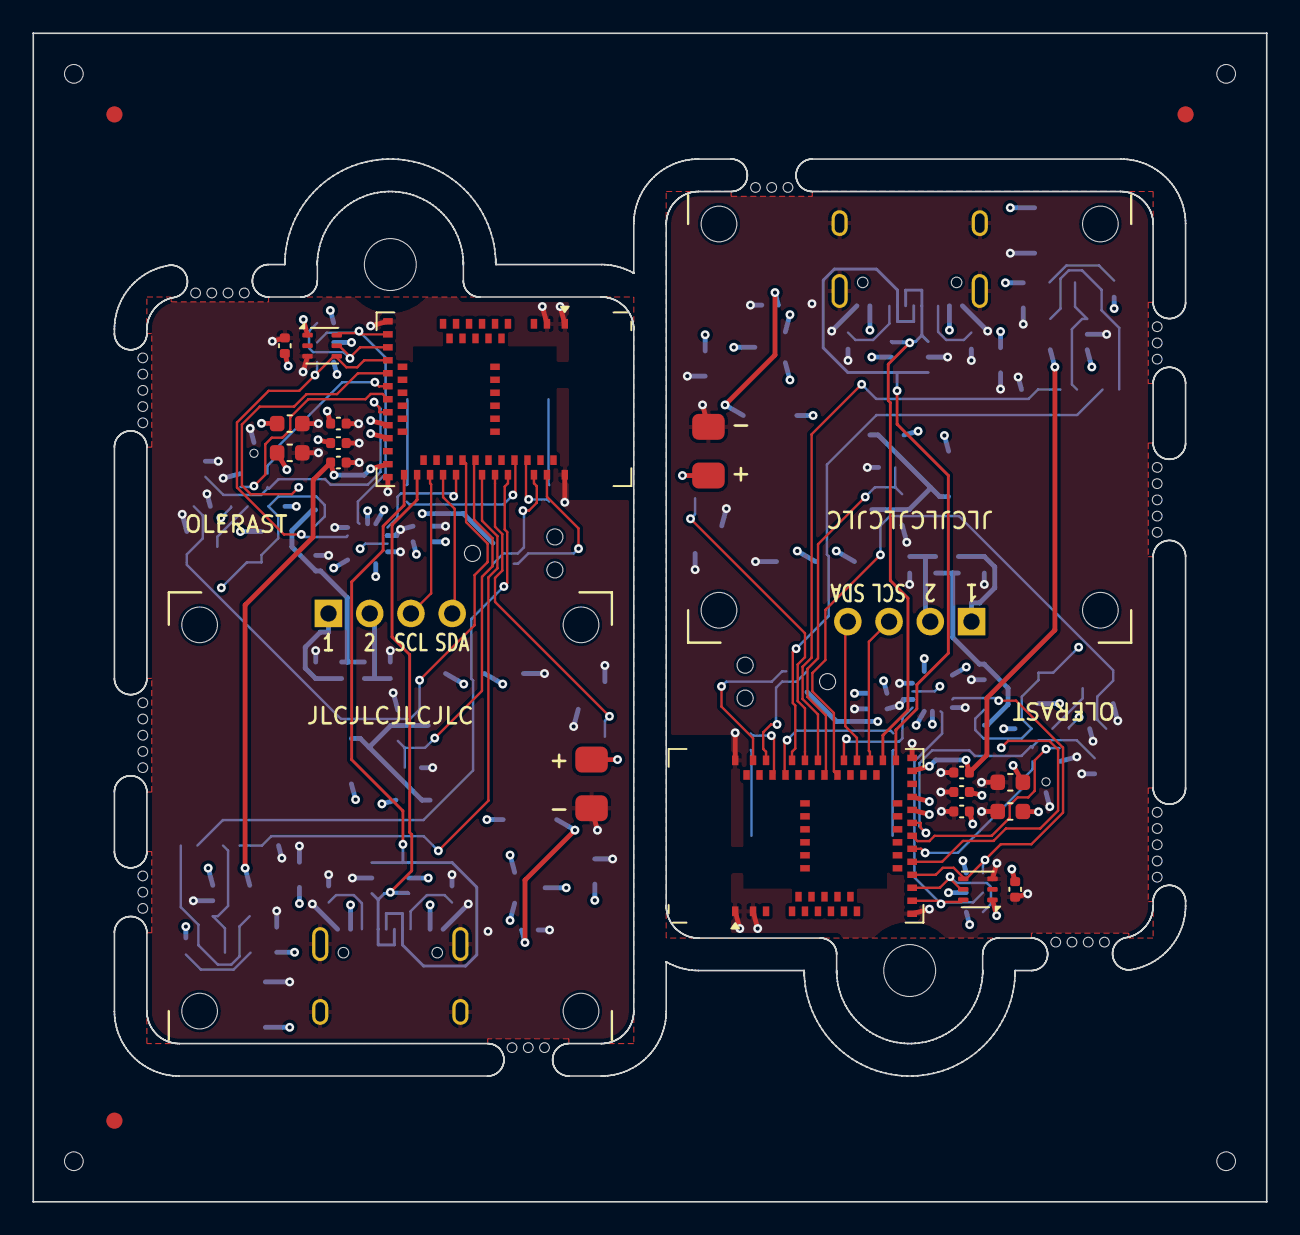
[picture p25: board keychain-rev-b-panel.kicad_pcb from above]

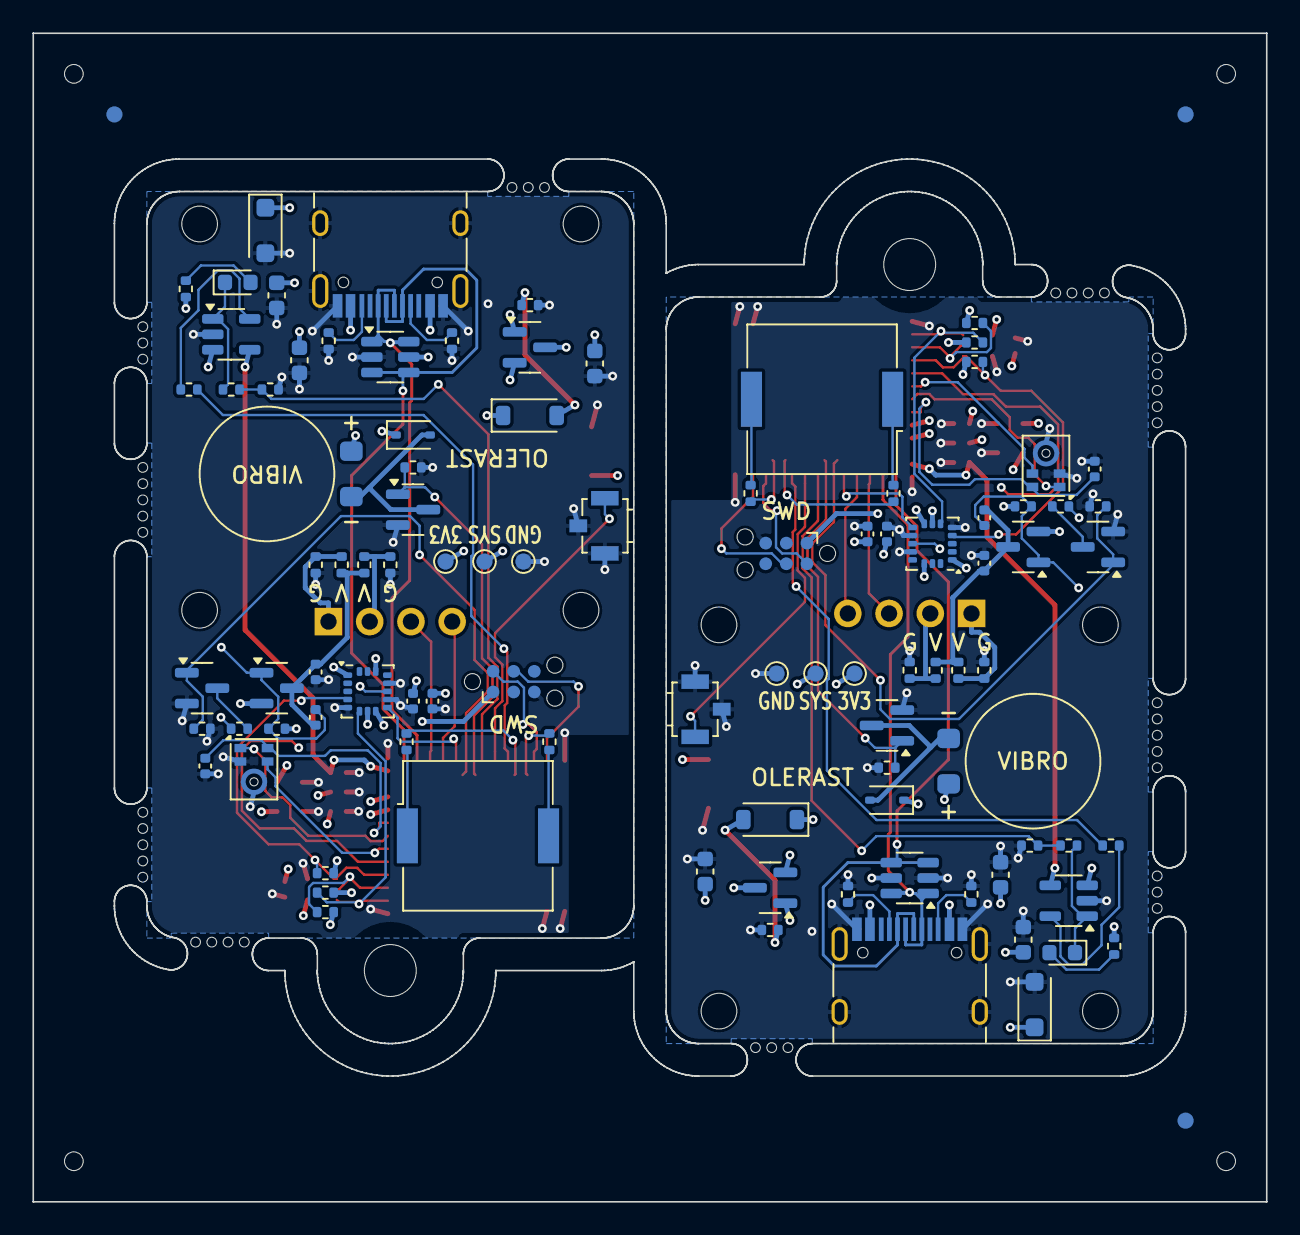
[picture p26: board keychain-rev-b-panel.kicad_pcb from below]

Board: 4 copper layers, 76.0 x 72.0 mm, 168 parts (101 on the bottom side), 78 nets.

Parts:
BT1_1, BT1_2: LiPo 402025; LiPo_Pads_20x25mm
BZ1_1, BZ1_2: PKMCS0909E4000; Buzzer_Murata_PKMCS0909E
C1_1, C1_2, C2_1, C2_2, C3_1, C3_2, C4_1, C4_2: 10uF; C_0603_1608Metric
C5_1, C5_2, C7_1, C7_2, C8_1, C8_2, C11_1, C11_2, C13_1, C13_2, C14_1, C14_2, C15_1, C15_2, C16_1, C16_2: 100nF; C_0402_1005Metric
C6_1, C6_2: 4.7uF; C_0603_1608Metric
C12_1, C12_2: 1uF; C_0402_1005Metric
D1_1, D1_2: B5819W; D_SOD-123
D2_1, D2_2: 1N4148WS; D_SOD-323
D3_1, D3_2: SMF5.0A; D_SOD-123F
H1_1, H1_2: кольцо брелока или винт корпуса; MountingHole_3.2mm_M3
J1_1, J1_2: USB-C; USB_C_Receptacle_HRO_TYPE-C-31-M-12
J2_1, J2_2: OLED 0.96" I2C; OLED_SSD1306_0.96in_I2C_Module
J3_1, J3_2: SWD; Tag-Connect_TC2030-IDC-NL_2x03_P1.27mm_Vertical
KiKit_FID_B_1, KiKit_FID_B_2, KiKit_FID_B_3: Fiducial
KiKit_FID_T_1, KiKit_FID_T_2, KiKit_FID_T_3: Fiducial
KiKit_MB_1_2, KiKit_MB_1_3, KiKit_MB_1_4, KiKit_MB_1_5, KiKit_MB_1_6, KiKit_MB_2_2, KiKit_MB_2_3, KiKit_MB_2_4, KiKit_MB_2_5, KiKit_MB_2_6, KiKit_MB_3_2, KiKit_MB_3_3, KiKit_MB_3_4, KiKit_MB_4_2, KiKit_MB_4_3, KiKit_MB_4_4, KiKit_MB_4_5, KiKit_MB_5_2, KiKit_MB_5_3, KiKit_MB_5_4, KiKit_MB_6_2, KiKit_MB_6_3, KiKit_MB_6_4, KiKit_MB_6_5, KiKit_MB_6_6, KiKit_MB_7_2, KiKit_MB_7_3, KiKit_MB_7_4, KiKit_MB_7_5, KiKit_MB_7_6, KiKit_MB_8_2, KiKit_MB_8_3, KiKit_MB_8_4, KiKit_MB_9_2, KiKit_MB_9_3, KiKit_MB_9_4, KiKit_MB_9_5, KiKit_MB_10_2, KiKit_MB_10_3, KiKit_MB_10_4: NPTH
KiKit_TO_1, KiKit_TO_2, KiKit_TO_3, KiKit_TO_4: NPTH
LED1_1, LED1_2: red; LED_0603_1608Metric
M1_1, M1_2: вибромотор 0820; VibroMotor_Coin_D8mm
Q1_1, Q1_2, Q2_1, Q2_2: AO3401A; SOT-23
Q3_1, Q3_2, Q4_1, Q4_2: AO3400A; SOT-23
R1_1, R1_2, R2_1, R2_2: 5.1k; R_0402_1005Metric
R3_1, R3_2, R5_1, R5_2, R6_1, R6_2, R8_1, R8_2, R10_1, R10_2, R11_1, R11_2, R12_1, R12_2: 10k; R_0402_1005Metric
R4_1, R4_2, R13_1, R13_2, R14_1, R14_2: 1k; R_0402_1005Metric
R7_1, R7_2, R9_1, R9_2, R15_1, R15_2: 100k; R_0402_1005Metric
R16_1, R16_2, R17_1, R17_2, R18_1, R18_2, R19_1, R19_2: 0R; R_0402_1005Metric
R20_1, R20_2: 47k; R_0402_1005Metric
SW1_1, SW1_2: B3U-3100P; SW_SPST_B3U-3100P
TP1_1, TP1_2: VDD; TestPoint_Pad_D1.0mm
TP2_1, TP2_2: VSYS; TestPoint_Pad_D1.0mm
TP3_1, TP3_2: GND; TestPoint_Pad_D1.0mm
U1_1, U1_2: MDBT50Q-1MV2; Raytac_MDBT50Q
U2_1, U2_2: MCP73832-2; SOT-23-5
U3_1, U3_2: USBLC6-2SC6; SOT-23-6
U4_1, U4_2: LIS3DH; LGA-16_3x3mm_P0.5mm_LayoutBorder3x5y
U5_1, U5_2: LTR-303ALS-01; Lite-On_LTR-303ALS-01
U6_1, U6_2: SPH0641LM4H-1; Knowles_LGA-5_3.5x2.65mm

Connections:
Board_0-ACC_INT1: U1_1.20, U4_1.11
Board_0-ACC_INT2: U1_1.41, U4_1.9
Board_0-ALS_INT: R12_1.1, U1_1.17, U5_1.5
Board_0-BTN: SW1_1.1, U1_1.46
Board_0-BUZ_A: BZ1_1.1, R13_1.2
Board_0-BUZ_A_IO: R13_1.1, U1_1.49
Board_0-BUZ_B: BZ1_1.2, R14_1.2
Board_0-BUZ_B_IO: R14_1.1, U1_1.50
Board_0-CC1: J1_1.A5, R1_1.1
Board_0-CC2: J1_1.B5, R2_1.1
Board_0-CHG_EN: R3_1.2, U1_1.48
Board_0-CHG_IO: R5_1.2, R20_1.1, U1_1.44
Board_0-CHG_LED: LED1_1.2, R4_1.1
Board_0-CHG_STAT: LED1_1.1, R5_1.1, U2_1.1
Board_0-DISP_EN: Q3_1.1, R9_1.1, U1_1.42
Board_0-DISP_G: C11_1.1, Q2_1.1, R7_1.1, R8_1.1
Board_0-DISP_PD: Q3_1.3, R8_1.2
Board_0-DISP_SCL: J2_1.3, U1_1.37
Board_0-DISP_SDA: J2_1.4, U1_1.39
Board_0-DISP_VCC: C11_1.2, C12_1.1, Q2_1.3, R17_1.2, R18_1.2
Board_0-GND: BT1_1.2, C1_1.2, C2_1.2, C3_1.2, C4_1.2, C5_1.2, C6_1.2, C7_1.2, C8_1.2, C12_1.2, C13_1.2, C14_1.2, C15_1.2, C16_1.2, D3_1.2, J1_1.A1, J1_1.A12, J1_1.B1, J1_1.B12, J1_1.S1, J3_1.5, Q3_1.2, Q4_1.2, R1_1.2, R2_1.2, R6_1.2, R9_1.2, R15_1.2, R16_1.2, R19_1.2, R20_1.2, SW1_1.2, SW1_1.3, TP3_1.1, U1_1.1, U1_1.2, U1_1.15, U1_1.33, U1_1.55, U2_1.2, U3_1.2, U4_1.5, U4_1.10, U4_1.12, U5_1.3, U6_1.2, U6_1.3
Board_0-MIC_PWR: C16_1.1, U1_1.26, U6_1.5
Board_0-OLED_1: J2_1.1, R16_1.1, R17_1.1
Board_0-OLED_2: J2_1.2, R18_1.1, R19_1.1
Board_0-PDM_CLK: U1_1.22, U6_1.4
Board_0-PDM_DATA: U1_1.24, U6_1.1
Board_0-PROG: R3_1.1, U2_1.5
Board_0-SENS_SCL: R10_1.1, U1_1.18, U4_1.4, U5_1.4
Board_0-SENS_SDA: R11_1.1, U1_1.16, U4_1.6, U5_1.6
Board_0-SWDCLK: J3_1.4, U1_1.53
Board_0-SWDIO: J3_1.2, U1_1.51
Board_0-USB_DN: J1_1.A7, J1_1.B7, U1_1.34, U3_1.3, U3_1.4
Board_0-USB_DP: J1_1.A6, J1_1.B6, U1_1.35, U3_1.1, U3_1.6
Board_0-VBAT: BT1_1.1, C2_1.1, Q1_1.3, U2_1.3
Board_0-VBUS: C1_1.1, C8_1.1, D1_1.2, D3_1.1, J1_1.A4, J1_1.A9, J1_1.B4, J1_1.B9, Q1_1.1, R4_1.2, R6_1.1, U1_1.32, U2_1.4, U3_1.5
Board_0-VDD: C6_1.1, C7_1.1, C13_1.1, C14_1.1, C15_1.1, J3_1.1, R10_1.2, R11_1.2, R12_1.2, TP1_1.1, U1_1.28, U4_1.1, U4_1.7, U4_1.8, U4_1.14, U5_1.1
Board_0-VIB_EN: Q4_1.1, R15_1.1, U1_1.43
Board_0-VIB_N: D2_1.2, M1_1.2, Q4_1.3
Board_0-VSYS: C3_1.1, C4_1.1, C5_1.1, D1_1.1, D2_1.1, M1_1.1, Q1_1.2, Q2_1.2, R7_1.2, TP2_1.1, U1_1.30
Board_1-ACC_INT1: U1_2.20, U4_2.11
Board_1-ACC_INT2: U1_2.41, U4_2.9
Board_1-ALS_INT: R12_2.1, U1_2.17, U5_2.5
Board_1-BTN: SW1_2.1, U1_2.46
Board_1-BUZ_A: BZ1_2.1, R13_2.2
Board_1-BUZ_A_IO: R13_2.1, U1_2.49
Board_1-BUZ_B: BZ1_2.2, R14_2.2
Board_1-BUZ_B_IO: R14_2.1, U1_2.50
Board_1-CC1: J1_2.A5, R1_2.1
Board_1-CC2: J1_2.B5, R2_2.1
Board_1-CHG_EN: R3_2.2, U1_2.48
Board_1-CHG_IO: R5_2.2, R20_2.1, U1_2.44
Board_1-CHG_LED: LED1_2.2, R4_2.1
Board_1-CHG_STAT: LED1_2.1, R5_2.1, U2_2.1
Board_1-DISP_EN: Q3_2.1, R9_2.1, U1_2.42
Board_1-DISP_G: C11_2.1, Q2_2.1, R7_2.1, R8_2.1
Board_1-DISP_PD: Q3_2.3, R8_2.2
Board_1-DISP_SCL: J2_2.3, U1_2.37
Board_1-DISP_SDA: J2_2.4, U1_2.39
Board_1-DISP_VCC: C11_2.2, C12_2.1, Q2_2.3, R17_2.2, R18_2.2
Board_1-GND: BT1_2.2, C1_2.2, C2_2.2, C3_2.2, C4_2.2, C5_2.2, C6_2.2, C7_2.2, C8_2.2, C12_2.2, C13_2.2, C14_2.2, C15_2.2, C16_2.2, D3_2.2, J1_2.A1, J1_2.A12, J1_2.B1, J1_2.B12, J1_2.S1, J3_2.5, Q3_2.2, Q4_2.2, R1_2.2, R2_2.2, R6_2.2, R9_2.2, R15_2.2, R16_2.2, R19_2.2, R20_2.2, SW1_2.2, SW1_2.3, TP3_2.1, U1_2.1, U1_2.2, U1_2.15, U1_2.33, U1_2.55, U2_2.2, U3_2.2, U4_2.5, U4_2.10, U4_2.12, U5_2.3, U6_2.2, U6_2.3
Board_1-MIC_PWR: C16_2.1, U1_2.26, U6_2.5
Board_1-OLED_1: J2_2.1, R16_2.1, R17_2.1
Board_1-OLED_2: J2_2.2, R18_2.1, R19_2.1
Board_1-PDM_CLK: U1_2.22, U6_2.4
Board_1-PDM_DATA: U1_2.24, U6_2.1
Board_1-PROG: R3_2.1, U2_2.5
Board_1-SENS_SCL: R10_2.1, U1_2.18, U4_2.4, U5_2.4
Board_1-SENS_SDA: R11_2.1, U1_2.16, U4_2.6, U5_2.6
Board_1-SWDCLK: J3_2.4, U1_2.53
Board_1-SWDIO: J3_2.2, U1_2.51
Board_1-USB_DN: J1_2.A7, J1_2.B7, U1_2.34, U3_2.3, U3_2.4
Board_1-USB_DP: J1_2.A6, J1_2.B6, U1_2.35, U3_2.1, U3_2.6
Board_1-VBAT: BT1_2.1, C2_2.1, Q1_2.3, U2_2.3
Board_1-VBUS: C1_2.1, C8_2.1, D1_2.2, D3_2.1, J1_2.A4, J1_2.A9, J1_2.B4, J1_2.B9, Q1_2.1, R4_2.2, R6_2.1, U1_2.32, U2_2.4, U3_2.5
Board_1-VDD: C6_2.1, C7_2.1, C13_2.1, C14_2.1, C15_2.1, J3_2.1, R10_2.2, R11_2.2, R12_2.2, TP1_2.1, U1_2.28, U4_2.1, U4_2.7, U4_2.8, U4_2.14, U5_2.1
Board_1-VIB_EN: Q4_2.1, R15_2.1, U1_2.43
Board_1-VIB_N: D2_2.2, M1_2.2, Q4_2.3
Board_1-VSYS: C3_2.1, C4_2.1, C5_2.1, D1_2.1, D2_2.1, M1_2.1, Q1_2.2, Q2_2.2, R7_2.2, TP2_2.1, U1_2.30
