olerast67/emotion-keychain/engine/src/engine.cpp

#include "face/engine.h"

#include "face/text.h"

namespace face {

namespace {

// Во сколько раз реже фирменные жесты, когда лицо успокоилось (взгляд — вдвое реже).
constexpr uint32_t kCalmAccentStretch = 3;
// Самое долгое внешнее удержание взгляда и самый долгий переход.
constexpr uint32_t kMaxLookHoldMs = 600000;
constexpr int kMaxTransitionMs = 10000;
// Ступень, которой рисуется наклон: примерно полпикселя сдвига зрачка.
constexpr float kTiltStep = 0.05f;
// Прицел: съезжается за kReticleLockMs, в конце мигает kReticleBlinkMs шагами по 75 мс.
// «Сканирование» без повода — раз в 3–8 минут.
constexpr uint32_t kReticleLockMs = 350, kReticleBlinkMs = 300, kReticleBlinkStep = 75;
constexpr uint32_t kScanMinMs = 180000, kScanSpreadMs = 300000;
// Надпись в углу мигает первые kBadgeBlinkMs шагами по kBadgeBlinkStep.
constexpr uint32_t kBadgeBlinkMs = 600, kBadgeBlinkStep = 150;

const char* const kThemeIds[] = {"classic", "cyber", "retro"};
static_assert(sizeof(kThemeIds) / sizeof(kThemeIds[0]) == (int)Theme::Count, "имя каждой темы");

// Ретро: каждый квадрат 2×2 горит целиком, если в нём горят хотя бы два пикселя.
// Квадраты начинаются с нечётных координат: пиксель в kSafeMargin − 1 от края попадает
// в квадрат, который к краю не ближе, поэтому безопасное поле не сужается.
void pixelate(Framebuffer& fb) {
  for (int y = 1; y + 1 < kHeight; y += 2)
    for (int x = 1; x + 1 < kWidth; x += 2) {
      const int n = fb.get(x, y) + fb.get(x + 1, y) + fb.get(x, y + 1) + fb.get(x + 1, y + 1);
      const Ink ink = n >= 2 ? Ink::Set : Ink::Clear;
      fb.plot(x, y, ink), fb.plot(x + 1, y, ink), fb.plot(x, y + 1, ink), fb.plot(x + 1, y + 1, ink);
    }
}

// Эмоции, на которых кибер-брелок «берёт цель».
bool locks_on(Expr e) {
  switch (e) {
    case Expr::focused:
    case Expr::suspicious:
    case Expr::determined:
    case Expr::alert:
    case Expr::curious:
    case Expr::skeptical:
    case Expr::hmm_squint:
    case Expr::challenge_accepted:
    case Expr::chad_stare: return true;
    default: return false;
  }
}

inline float frac(float x) { return x - (float)ifloor(x); }

void lerp_eye(const Eye& a, const Eye& b, float k, Eye& o) {
  o = k < 0.5f ? a : b;
  o.w = lerpf(a.w, b.w, k);
  o.h = lerpf(a.h, b.h, k);
  o.r = lerpf(a.r, b.r, k);
  o.t = lerpf(a.t, b.t, k);
  o.px = lerpf(a.px, b.px, k);
  o.py = lerpf(a.py, b.py, k);
  o.pr = lerpf(a.pr, b.pr, k);
  o.gx = lerpf(a.gx, b.gx, k);
  o.gy = lerpf(a.gy, b.gy, k);
  o.gr = lerpf(a.gr, b.gr, k);
  o.lid_cov = lerpf(a.lid_cov, b.lid_cov, k);
  o.lid_ang = lerpf(a.lid_ang, b.lid_ang, k);
  o.lid_bend = lerpf(a.lid_bend, b.lid_bend, k);
  o.low_cov = lerpf(a.low_cov, b.low_cov, k);
  o.low_bend = lerpf(a.low_bend, b.low_bend, k);
  o.dx = lerpf(a.dx, b.dx, k);
  o.dy = lerpf(a.dy, b.dy, k);
  o.sx = lerpf(a.sx, b.sx, k);
  o.sy = lerpf(a.sy, b.sy, k);
  o.rot = lerpf(a.rot, b.rot, k);
  o.squash = lerpf(a.squash, b.squash, k);
  o.stretch = lerpf(a.stretch, b.stretch, k);
}

void lerp_brow(Brow a, Brow b, float k, Brow& o) {
  // Брови появляются «из точки» и так же исчезают.
  if (a.len < 0.5f && b.len >= 0.5f) {
    a = b;
    a.len = 0;
  } else if (b.len < 0.5f && a.len >= 0.5f) {
    b = a;
    b.len = 0;
  }
  o.len = lerpf(a.len, b.len, k);
  o.t = lerpf(a.t, b.t, k);
  o.dx = lerpf(a.dx, b.dx, k);
  o.gap = lerpf(a.gap, b.gap, k);
  o.ang = lerpf(a.ang, b.ang, k);
  o.bend = lerpf(a.bend, b.bend, k);
}

void lerp_mouth(const Mouth& a, const Mouth& b, float k, Mouth& o) {
  o = k < 0.5f ? a : b;
  o.w = lerpf(a.w, b.w, k);
  o.curve = lerpf(a.curve, b.curve, k);
  o.open = lerpf(a.open, b.open, k);
  o.t = lerpf(a.t, b.t, k);
  o.tilt = lerpf(a.tilt, b.tilt, k);
  o.h = lerpf(a.h, b.h, k);
  o.dx = lerpf(a.dx, b.dx, k);
  o.dy = lerpf(a.dy, b.dy, k);
  o.sx = lerpf(a.sx, b.sx, k);
}

// Хэш FNV-1a по всем параметрам, от которых зависит картинка.
struct Hasher {
  uint32_t h = 2166136261u;
  void byte(uint8_t b) {
    h ^= b;
    h *= 16777619u;
  }
  void u32(uint32_t v) {
    for (int i = 0; i < 4; ++i) byte((uint8_t)(v >> (8 * i)));
  }
  void f(float v) {
    union {
      float f;
      uint32_t u;
    } c{v};
    u32(c.u);
  }
  void eye(const Eye& e) {
    byte((uint8_t)e.kind);
    byte((uint8_t)e.sq);
    const float vals[] = {e.w,  e.h,  e.r,       e.t,       e.px,       e.py,      e.pr,       e.gx,
                          e.gy, e.gr, e.lid_cov, e.lid_ang, e.lid_bend, e.low_cov, e.low_bend, e.dx,
                          e.dy, e.sx, e.sy,      e.rot,     e.squash,   e.stretch};
    for (float v : vals) f(v);
  }
  void face(const Face& fc) {
    for (int i = 0; i < 2; ++i) {
      eye(fc.eye[i]);
      const Brow& b = fc.brow[i];
      const float bv[] = {b.len, b.t, b.dx, b.gap, b.ang, b.bend};
      for (float v : bv) f(v);
    }
    const Mouth& m = fc.mouth;
    byte((uint8_t)m.kind);
    const float mv[] = {m.w, m.curve, m.open, m.t, m.tilt, m.h, m.dx, m.dy, m.sx};
    for (float v : mv) f(v);
    const float lv[] = {
        fc.layout.spacing, fc.layout.eye_y, fc.layout.mouth_y, fc.layout.tilt, fc.ox, fc.oy, fc.gx, fc.gy};
    for (float v : lv) f(v);
  }
};

inline void want(uint32_t& period, uint32_t ms) {
  if (ms < period) period = ms;
}

bool blinkable(EyeKind k) {
  return k == EyeKind::RRect || k == EyeKind::Heart || k == EyeKind::Star || k == EyeKind::Sparkle;
}

uint32_t hash32(uint32_t x) {
  x ^= x >> 16;
  x *= 0x7feb352du;
  x ^= x >> 15;
  x *= 0x846ca68bu;
  x ^= x >> 16;
  return x;
}

}  // namespace

const char* theme_id(Theme t) { return (int)t < (int)Theme::Count ? kThemeIds[(int)t] : "classic"; }

bool theme_from_id(const char* id, Theme* out) {
  for (int i = 0; i < (int)Theme::Count; ++i) {
    const char* a = kThemeIds[i];
    int k = 0;
    while (a[k] && a[k] == id[k]) ++k;
    if (!a[k] && !id[k]) return *out = (Theme)i, true;
  }
  return false;
}

const char* clip_id(Clip c) {
  static const char* const kIds[] = {
#define FACE_X(n) #n,
      FACE_CLIP_LIST(FACE_X)
#undef FACE_X
  };
  return (int)c < kClipCount ? kIds[(int)c] : "none";
}

uint16_t clip_duration_ms(Clip c) {
  switch (c) {
    case Clip::blink: return 200;
    case Clip::wink: return 520;
    case Clip::nod: return 820;
    case Clip::headshake: return 760;
    case Clip::startle: return 620;
    case Clip::yawn: return 2200;
    case Clip::double_take: return 1000;
    case Clip::sneeze: return 1600;
    case Clip::look_around: return 2300;
    case Clip::hop: return 760;
    case Clip::shiver: return 1000;
    case Clip::peek: return 1500;
    case Clip::glitch: return 700;
    case Clip::eye_roll: return 1300;
    case Clip::sigh: return 1500;
    case Clip::shake_off: return 650;
    case Clip::boop: return 460;
    default: return 0;
  }
}

void FaceEngine::init(uint32_t seed, uint32_t now_ms) {
  rng_.seed(seed);
  has_frame_ = false;
  front_.clear();
  back_.clear();
  dirty_n_ = 0;
  stats_ = EngineStats{};
  for (int i = 0; i < (int)Overlay::Count; ++i) ov_alpha_[i] = 0;
  ov_target_ = 0;
  clip_active_ = false;
  glitch_ = 0;
  drift_x_ = drift_y_ = 0;
  fit_from_x_ = fit_from_y_ = fit_to_x_ = fit_to_y_ = fit_x_ = fit_y_ = 0;
  drift_next_ = now_ms + 20000u + (rng_.next() % 20000u);
  gx_ = gy_ = g_from_x_ = g_from_y_ = g_to_x_ = g_to_y_ = 0;
  g_moving_ = false;
  g_ext_ = false;
  blink_on_ = blink_double_ = false;
  active_ms_ = now_ms;
  calm_ = false;
  expression_face(Expr::neutral, &base_);
  apply_quirks(base_);
  scene_ = Scene::None;
  tilt_x_ = tilt_y_ = tilt_cx_ = tilt_cy_ = tilt_qx_ = tilt_qy_ = 0;
  tilt_last_ = now_ms;
  micro_glitch_next_ = now_ms + 45000u + rng_.next() % 60000u;
  micro_glitch_on_ = false;
  reticle_on_ = reticle_shown_ = false;
  badge_on_ = badge_shown_ = false;
  scan_next_ = now_ms + kScanMinMs + rng_.next() % kScanSpreadMs;
  ov_last_ = now_ms;
  last_now_ = now_ms;
  set_expression(Expr::neutral, now_ms, 0);
}

void FaceEngine::set_expression(Expr e, uint32_t now_ms, int transition_ms) {
  if ((int)e >= kExprCount) return;
  preset_ = &face::expression(e);
  expr_ = e;
  expr_t0_ = now_ms;
  from_ = base_;
  expression_face(e, &to_);
  apply_quirks(to_);
  for (int i = 0; i < 2; ++i) eye_swap_[i] = from_.eye[i].kind != to_.eye[i].kind;
  mouth_swap_ = from_.mouth.kind != to_.mouth.kind;
  const float tempo = sanef(opt_.tempo, 1.0f, 0.3f, 3.0f);
  tr_ms_ = (uint16_t)(transition_ms < 0 ? imin(iround((float)preset_->in_ms * tempo), kMaxTransitionMs)
                                        : imin(transition_ms, kMaxTransitionMs));
  tr_t0_ = now_ms;
  tr_active_ = tr_ms_ > 0;
  if (!tr_active_) base_ = to_;
  ov_target_ = preset_->overlays;
  fit_from_x_ = fit_x_;
  fit_from_y_ = fit_y_;
  compute_fit();
  if (!tr_active_) fit_x_ = fit_to_x_, fit_y_ = fit_to_y_;
  blink_on_ = false;
  schedule_blink(now_ms + tr_ms_);
  g_moving_ = false;
  schedule_gaze(now_ms + tr_ms_ / 2);
  accent_on_ = false;
  // Первый жест — пораньше, чтобы новая эмоция сразу ожила (у спокойного лица — тоже реже).
  const uint32_t first_ms = preset_->accent_ms * (calm_ ? kCalmAccentStretch : 1u);
  accent_next_ = now_ms + tr_ms_ + (uint32_t)((float)first_ms * rng_.range(0.3f, 0.7f));
  if (opt_.theme == Theme::Cyber && locks_on(e)) scan(now_ms);
  next_update_ = now_ms;
}

void FaceEngine::scan(uint32_t now_ms, uint32_t ms) {
  reticle_on_ = true;
  reticle_t0_ = now_ms;
  reticle_ms_ = (uint32_t)imax((int)imin((int)ms, 60000), (int)(kReticleLockMs + kReticleBlinkMs));
  next_update_ = now_ms;
}

void FaceEngine::badge(const char* text, uint32_t now_ms, uint32_t ms) {
  int i = 0;
  for (; text && text[i] && i < 7; ++i) badge_[i] = text[i];
  badge_[i] = 0;
  badge_on_ = i > 0;
  badge_t0_ = now_ms;
  badge_ms_ = ms < 60000u ? ms : 60000u;
  next_update_ = now_ms;
}

void FaceEngine::note_activity(uint32_t now_ms) {
  active_ms_ = now_ms;
  if (!calm_) return;
  calm_ = false;
  // Спокойное лицо планировало жест надолго вперёд — оживляем его сразу.
  if (preset_ && !accent_on_) {
    const uint32_t soon = now_ms + (uint32_t)((float)preset_->accent_ms * rng_.range(0.3f, 0.7f));
    if (time_left(now_ms, soon) < time_left(now_ms, accent_next_)) accent_next_ = soon;
  }
  next_update_ = now_ms;
}

namespace {

// На сколько пикселей жест и движение пресета уводят лицо от его статичной
// рамки: слева, справа, сверху, снизу.
struct Pad {
  float l = 0, r = 0, t = 0, b = 0;
  void x(float v) { l = fmax_(l, v), r = fmax_(r, v); }
  void y(float v) { t = fmax_(t, v), b = fmax_(b, v); }
};

// Взгляд сдвигает глаза с бровями на 5·gx и 3·gy пикселей (см. render_face).
// Крайние значения взгляда для каждого режима — из update_gaze.
Pad gaze_pad(const Expression& e) {
  float x = 0, up = 0, down = 0;
  switch (e.gaze) {
    case Gaze::Idle: x = 0.95f, up = 0.5f, down = 0.4f; break;
    case Gaze::Still: x = 0.12f, up = down = 0.1f; break;
    case Gaze::Around: x = 1.0f, up = 0.7f, down = 0.5f; break;
    case Gaze::Up: x = 0.35f, up = 0.95f; break;
    case Gaze::Down: x = 0.4f, down = 0.95f; break;
    case Gaze::Left:
    case Gaze::Right: x = 1.0f, up = down = 0.15f; break;
    case Gaze::Avert: x = 0.8f, down = 0.75f; break;
    case Gaze::Dart: x = 1.0f, up = down = 0.6f; break;
    case Gaze::UpSide: x = 0.9f, up = 0.9f; break;
  }
  if (e.accent == Accent::Look) x = 1.0f;
  Pad p;
  p.x(5.0f * x);
  p.t = 3.0f * up;
  p.b = 3.0f * down;
  return p;
}

Pad motion_pad(const Expression& e) {
  Pad p;
  const float A = e.motion_amp;
  switch (e.motion) {
    case Motion::None:
    case Motion::Pulse: break;
    case Motion::Bounce: p.t = A; break;
    case Motion::Bob: p.y(A); break;
    case Motion::Tremble: p.x(A), p.y(A); break;
    case Motion::Shake:
    case Motion::Shiver: p.x(A); break;
    case Motion::Sway: p.x(A), p.y(A * 0.5f); break;
    case Motion::Float: p.y(A), p.x(A * 0.6f); break;
    case Motion::Nod: p.b = A; break;
    case Motion::Wobble: p.y(A), p.x(A * 0.4f); break;
  }
  if (e.motion == Motion::Pulse) p.x(A * 0.2f), p.y(A * 0.2f);
  switch (e.accent) {
    case Accent::Brows: p.t = fmax_(p.t, 3.0f); break;
    case Accent::Chatter: p.b = fmax_(p.b, 4.0f); break;
    case Accent::Hop: p.t = fmax_(p.t, 3.0f); break;
    case Accent::Tilt: p.y(3.0f); break;
    case Accent::Wiggle:
    case Accent::Shake:
    case Accent::Sway: p.x(2.0f); break;
    case Accent::Nod: p.b = fmax_(p.b, 2.0f); break;
    case Accent::Bob: p.t = fmax_(p.t, 1.5f); break;
    case Accent::Pulse: p.x(2.0f), p.y(2.0f); break;
    case Accent::Grin: p.x(2.0f); break;
    default: break;
  }
  return p;
}

}  // namespace

void FaceEngine::apply_quirks(Face& f) const {
  const Quirks& q = quirks_;
  f.layout.spacing += q.spacing;
  for (int i = 0; i < 2; ++i) {
    f.eye[i].sx *= q.eye_scale;
    f.eye[i].sy *= q.eye_scale;
    f.eye[i].pr *= q.pupil_scale;
    if (f.brow[i].len > 0.5f) f.brow[i].gap += q.brow_lift;
  }
  f.eye[1].sq = q.cyber_eye;
}

void FaceEngine::set_quirks(const Quirks& q, uint32_t now_ms) {
  // Внешность приходит снаружи (серийный номер, симулятор): чистим от NaN и крайностей.
  quirks_ = q;
  quirks_.spacing = sanef(q.spacing, 0.0f, -8.0f, 8.0f);
  quirks_.eye_scale = sanef(q.eye_scale, 1.0f, 0.5f, 1.5f);
  quirks_.pupil_scale = sanef(q.pupil_scale, 1.0f, 0.0f, 2.0f);
  quirks_.blink_rate = sanef(q.blink_rate, 1.0f, 0.25f, 4.0f);
  quirks_.brow_lift = sanef(q.brow_lift, 0.0f, -4.0f, 4.0f);
  expression_face(expr_, &base_);
  apply_quirks(base_);
  set_expression(expr_, now_ms, 0);
}

void FaceEngine::set_tilt(float x, float y) {
  x = sanef(x, 0.0f, -1.0f, 1.0f);
  y = sanef(y, 0.0f, -1.0f, 1.0f);
  // Мёртвая зона: шум акселерометра не будит движок и не дёргает зрачки.
  if (fabs_(x - tilt_x_) < kTiltDeadband && fabs_(y - tilt_y_) < kTiltDeadband) return;
  tilt_x_ = x;
  tilt_y_ = y;
  note_activity(last_now_);
  next_update_ = last_now_;
}

void FaceEngine::jerk(float dx, float dy, uint32_t now_ms) {
  if (!finitef(dx) || !finitef(dy)) return;
  const float m = fmax_(fabs_(dx), fabs_(dy));
  if (m < 0.05f) return;
  const float tx = clampf(dx / m, -1.0f, 1.0f), ty = clampf(dy / m * 0.5f, -0.5f, 0.5f);
  // Рывок в ту же сторону, куда персонаж и так смотрит, только продлевает взгляд.
  if (g_ext_ && fabs_(tx - g_to_x_) < kTiltDeadband && fabs_(ty - g_to_y_) < kTiltDeadband) {
    g_ext_until_ = g_next_ = now_ms + 700u;
    note_activity(now_ms);
    return;
  }
  look_at(tx, ty, now_ms, 700);
}

void FaceEngine::play_scene(Scene s, uint32_t now_ms, const SceneParams& p) {
  if ((int)s >= kSceneCount) return;
  scene_ = s;
  scene_t0_ = now_ms;
  scene_p_ = p;
  next_update_ = now_ms;
}

namespace {

struct InkBox {
  int x0 = kWidth, x1 = -1, y0 = kHeight, y1 = -1;
  bool empty() const { return x1 < 0; }
};

InkBox ink_box(const Framebuffer& fb) {
  InkBox r;
  for (int p = 0; p < kPages; ++p)
    for (int x = 0; x < kWidth; ++x) {
      const uint8_t b = fb.data[p * kWidth + x];
      if (!b) continue;
      r.x0 = imin(r.x0, x), r.x1 = imax(r.x1, x);
      r.y0 = imin(r.y0, p * 8 + __builtin_ctz(b)), r.y1 = imax(r.y1, p * 8 + 31 - __builtin_clz((uint32_t)b));
    }
  return r;
}

// Лицо не подходит к краю ближе kSafeMargin − 1. Поле рассчитывает compute_fit, но наклон
// брелока, переходы между эмоциями и жесты иногда выносят лицо дальше: тогда весь слой
// сдвигается внутрь, вместе с привязками для рамки темы. Сдвиг считается по самому лицу
// (face — его рамка до значков): значки, которые пульсируют и летают, иначе дёргали бы всё
// лицо туда-обратно. То, что от значков вылезло за поле, обрезается.
void keep_inside(Framebuffer& fb, Anchors& a, InkBox face) {
  if (face.empty()) face = ink_box(fb);
  if (face.empty()) return;
  const int m = kSafeMargin - 1;
  auto fits = [m](int lo, int hi, int size) { return hi - lo + 1 <= size - 2 * m; };
  auto push = [m, fits](int lo, int hi, int size) {
    if (!fits(lo, hi, size)) return 0;  // шире поля — не трогаем
    if (lo < m) return m - lo;
    if (hi > size - 1 - m) return size - 1 - m - hi;
    return 0;
  };
  const int dx = push(face.x0, face.x1, kWidth), dy = push(face.y0, face.y1, kHeight);
  if (dx || dy) {
    static Framebuffer tmp;
    tmp.clear();
    const InkBox all = ink_box(fb);
    for (int y = all.y0; y <= all.y1; ++y)
      for (int x = all.x0; x <= all.x1; ++x)
        if (fb.get(x, y)) tmp.set(x + dx, y + dy);
    fb.copy_from(tmp);
    for (int i = 0; i < 2; ++i) a.ex[i] += (float)dx, a.ey[i] += (float)dy;
    a.mx += (float)dx, a.my += (float)dy, a.ox += (float)dx, a.oy += (float)dy;
  }
  if (fits(face.x0, face.x1, kWidth))
    for (int y = 0; y < kHeight; ++y) fb.hspan(y, 0, m - 1, Ink::Clear), fb.hspan(y, kWidth - m, kWidth - 1, Ink::Clear);
  if (fits(face.y0, face.y1, kHeight))
    for (int y = 0; y < m; ++y) fb.hspan(y, 0, kWidth - 1, Ink::Clear), fb.hspan(kHeight - 1 - y, 0, kWidth - 1, Ink::Clear);
}

}  // namespace

void FaceEngine::compute_fit() {
  // Рисуем целевое лицо со значками в черновой буфер и смотрим, где оказались
  // крайние пиксели. Значки, привязанные к экрану, а не к лицу, сами держат поле.
  back_.clear();
  Face f = to_;
  f.ox = f.oy = 0;
  Anchors a;
  render_face(back_, f, &a);
  // Значок появляется с «подскоком» (ease_out_back): при alpha ≈ 0.58 он на 10 % крупнее,
  // чем потом. Поле считаем и по этому кадру.
  const float kAlphas[2] = {1.0f, 0.58f};
  for (int i = 0; i < (int)Overlay::Count; ++i) {
    if (!((ov_target_ >> i) & 1ull) || overlay_screen_space((Overlay)i)) continue;
    for (float al : kAlphas)
      for (int k = 0; k < 8; ++k) render_overlay(back_, (Overlay)i, a, al, (float)k * 0.31f);
  }
  // Рамка темы и риски кибер-глаза сами прижаты к безопасному полю, в расчёт не входят.
  int x0 = kWidth, x1 = -1, y0 = kHeight, y1 = -1;
  for (int p = 0; p < kPages; ++p)
    for (int x = 0; x < kWidth; ++x) {
      const uint8_t b = back_.data[p * kWidth + x];
      if (!b) continue;
      x0 = imin(x0, x), x1 = imax(x1, x);
      y0 = imin(y0, p * 8 + __builtin_ctz(b)), y1 = imax(y1, p * 8 + 31 - __builtin_clz((uint32_t)b));
    }
  back_.clear();
  if (x1 >= 0) {
    const Pad m = motion_pad(*preset_), g = gaze_pad(*preset_);
    x0 -= iceil(m.l + g.l), x1 += iceil(m.r + g.r), y0 -= iceil(m.t + g.t), y1 += iceil(m.b + g.b);
  }
  if (x1 < 0) {
    fit_to_x_ = fit_to_y_ = 0;
    drift_lo_x_ = -3, drift_hi_x_ = 3, drift_lo_y_ = -2, drift_hi_y_ = 2;
    return;
  }
  auto fit = [](int lo, int hi, int size) {
    const int m = kSafeMargin;
    if (hi - lo + 1 > size - 2 * m) return (size - 1 - hi - lo) / 2;  // не влезает — по центру
    if (lo < m) return m - lo;
    if (hi > size - 1 - m) return size - 1 - m - hi;
    return 0;
  };
  const int fx = fit(x0, x1, kWidth), fy = fit(y0, y1, kHeight);
  fit_to_x_ = (float)fx;
  fit_to_y_ = (float)fy;
  // Дрейф не подпускает эмоцию к краю ближе, чем на пиксель меньше поля.
  const int m = kSafeMargin - 1;
  drift_lo_x_ = imin(0, imax(-3, m - (x0 + fx))), drift_hi_x_ = imax(0, imin(3, kWidth - 1 - m - (x1 + fx)));
  drift_lo_y_ = imin(0, imax(-2, m - (y0 + fy))), drift_hi_y_ = imax(0, imin(2, kHeight - 1 - m - (y1 + fy)));
}

void FaceEngine::schedule_accent(uint32_t from) {
  // Успокоившееся лицо жестикулирует реже: долгие тихие состояния почти не будят процессор.
  const uint32_t ms = preset_->accent_ms * (calm_ ? kCalmAccentStretch : 1u);
  accent_next_ = from + (uint32_t)((float)ms * rng_.range(0.65f, 1.35f));
}

namespace {

uint16_t accent_duration(Accent a) {
  switch (a) {
    case Accent::Breath: return 1400;
    case Accent::Brows: return 650;
    case Accent::Chatter: return 750;
    case Accent::Squint: return 520;
    case Accent::Hop: return 460;
    case Accent::Tilt: return 1300;
    case Accent::Look: return 1200;
    case Accent::Wiggle: return 700;
    case Accent::Pulse: return 520;
    case Accent::Twitch: return 380;
    case Accent::Nod: return 640;
    case Accent::Shake: return 560;
    case Accent::Glint: return 650;
    case Accent::Grin: return 800;
    case Accent::Sway: return 1600;
    case Accent::Bob: return 1000;
    case Accent::None: return 0;
  }
  return 0;
}

}  // namespace

void FaceEngine::apply_accent(uint32_t now, uint32_t& period) {
  if (!preset_ || preset_->accent == Accent::None || !opt_.idle_motion) return;
  if (!accent_on_) {
    if (!time_reached(now, accent_next_) || tr_active_ || clip_running(now)) return;
    accent_on_ = true;
    accent_t0_ = now;
    accent_sign_ = rng_.chance(0.5f) ? 1.0f : -1.0f;
  }
  const Accent a = preset_->accent;
  const float k = (float)(now - accent_t0_) / (float)accent_duration(a);
  if (k >= 1.0f) {
    accent_on_ = false;
    schedule_accent(now);
    return;
  }
  const float b = bump(k);
  Face& c = composed_;
  uint32_t p = frame_ms();
  switch (a) {
    case Accent::None: break;
    case Accent::Breath:
      for (int i = 0; i < 2; ++i) c.eye[i].sy *= 1.0f + 0.05f * b;
      c.mouth.sx *= 1.0f + 0.06f * b;
      p = 100;
      break;
    case Accent::Brows: {
      bool has = false;
      for (int i = 0; i < 2; ++i) {
        if (c.brow[i].len > 0.5f) {
          c.brow[i].gap += 3.0f * b;
          has = true;
        }
      }
      if (!has)
        for (int i = 0; i < 2; ++i) c.eye[i].sy *= 1.0f + 0.1f * b;
      break;
    }
    case Accent::Chatter: {
      const float ch = fabs_(fsin(kPi * 3.0f * k)) * (1.0f - k * 0.3f);
      if (c.mouth.kind == MouthKind::Curve || c.mouth.kind == MouthKind::Scream || c.mouth.kind == MouthKind::Rage)
        c.mouth.open += 4.0f * ch;
      else
        c.mouth.h *= 1.0f + 0.35f * ch;
      p = 50;
      break;
    }
    case Accent::Squint:
      for (int i = 0; i < 2; ++i) c.eye[i].squash *= 1.0f - 0.28f * b;
      c.mouth.curve += 1.0f * b;
      break;
    case Accent::Hop: c.oy -= 3.0f * b; break;
    case Accent::Tilt:
      c.layout.tilt += 3.0f * accent_sign_ * envelope(k, 0.25f, 0.35f);
      p = 66;
      break;
    case Accent::Look: c.gx = clampf(c.gx + 0.9f * accent_sign_ * envelope(k, 0.12f, 0.2f), -1.0f, 1.0f); break;
    case Accent::Wiggle:
      for (int i = 0; i < 2; ++i) c.eye[i].dx += 2.0f * fsin(kTau * 2.0f * k) * (1.0f - k);
      break;
    case Accent::Pulse:
      for (int i = 0; i < 2; ++i) {
        c.eye[i].sx *= 1.0f + 0.1f * b;
        c.eye[i].sy *= 1.0f + 0.1f * b;
      }
      break;
    case Accent::Twitch: c.eye[accent_sign_ > 0 ? 0 : 1].squash *= 1.0f - 0.55f * bump(frac(k * 2.0f)); break;
    case Accent::Nod: c.oy += 2.0f * fabs_(fsin(kTau * k)); break;
    case Accent::Shake: c.ox += 2.0f * fsin(kTau * 3.0f * k) * (1.0f - k); break;
    case Accent::Glint:
      for (int i = 0; i < 2; ++i) {
        c.eye[i].pr *= 1.0f + 0.3f * b;
        c.eye[i].gr *= 1.0f + 0.3f * b;
      }
      break;
    case Accent::Grin:
      c.mouth.sx *= 1.0f + 0.12f * b;
      c.mouth.curve += 1.5f * b;
      break;
    case Accent::Sway:
      c.ox += 2.0f * fsin(kTau * k);
      p = 66;
      break;
    case Accent::Bob:
      c.oy -= 1.5f * fsin(kPi * k);
      p = 66;
      break;
  }
  want(period, p);
}

void FaceEngine::play_clip(Clip c, uint32_t now_ms) {
  if ((int)c >= kClipCount) return;
  if (c == Clip::blink) {
    blink_on_ = true;
    blink_t0_ = now_ms;
    blink_ms_ = 180;
    next_update_ = now_ms;
    return;
  }
  clip_ = c;
  clip_t0_ = now_ms;
  clip_active_ = true;
  next_update_ = now_ms;
}

void FaceEngine::look_at(float gx, float gy, uint32_t now_ms, uint32_t hold_ms) {
  g_from_x_ = gx_;
  g_from_y_ = gy_;
  g_to_x_ = sanef(gx, 0.0f, -1.0f, 1.0f);
  g_to_y_ = sanef(gy, 0.0f, -1.0f, 1.0f);
  g_t0_ = now_ms;
  g_ms_ = 90;
  g_moving_ = true;
  g_ext_ = true;
  g_ext_until_ = now_ms + (hold_ms < kMaxLookHoldMs ? hold_ms : kMaxLookHoldMs);
  g_next_ = g_ext_until_;
  note_activity(now_ms);
  next_update_ = now_ms;
}

bool FaceEngine::clip_running(uint32_t now) const { return clip_active_ && now - clip_t0_ < clip_duration_ms(clip_); }

bool FaceEngine::clip_holds_eyes(uint32_t now) const {
  // Испуг, чих и «тык» сами сжимают глаза: моргание на них не накладывается.
  return clip_running(now) && (clip_ == Clip::startle || clip_ == Clip::sneeze || clip_ == Clip::boop);
}

int FaceEngine::dirty(DirtyWindow out[kPages]) const {
  for (int i = 0; i < dirty_n_; ++i) out[i] = dirty_[i];
  return dirty_n_;
}

void FaceEngine::schedule_blink(uint32_t from) {
  if (!preset_) return;
  uint32_t lo, hi;
  blink_armed_ = preset_->blink != Blink::None;
  switch (preset_->blink) {
    case Blink::None: return;
    case Blink::Rare: lo = 6000, hi = 14000; break;
    case Blink::Often: lo = 900, hi = 2600; break;
    case Blink::Slow: lo = 2500, hi = 6000; break;
    case Blink::Normal:
    default: lo = 2500, hi = 6500; break;
  }
  blink_next_ = from + (uint32_t)((float)(lo + rng_.next() % (hi - lo)) * quirks_.blink_rate);
}

void FaceEngine::update_blink(uint32_t now, uint32_t& period) {
  if (!opt_.idle_motion && !blink_on_) return;
  const bool held = clip_holds_eyes(now);
  if (blink_on_ && held) {
    // Клип сам управляет глазами: это моргание отменяется, следующее планируем заново.
    blink_on_ = blink_double_ = false;
    schedule_blink(now);
  }
  if (!blink_on_ && blink_armed_ && time_reached(now, blink_next_) && !tr_active_ && !held) {
    blink_on_ = true;
    blink_t0_ = now;
    blink_ms_ = preset_->blink == Blink::Slow ? 560 : (preset_->blink == Blink::Often ? 150 : 180);
    blink_armed_ = false;  // следующее моргание планируется, когда закончится это
  }
  if (!blink_on_) return;
  float k = (float)(now - blink_t0_) / (float)blink_ms_;
  if (k >= 1.0f) {
    blink_on_ = false;
    float double_p = preset_->blink == Blink::Often ? 0.3f : (preset_->blink == Blink::Slow ? 0.0f : 0.15f);
    if (!blink_double_ && rng_.chance(double_p)) {
      blink_double_ = true;
      blink_next_ = now + 110;
      blink_armed_ = true;
    } else {
      blink_double_ = false;
      schedule_blink(now);
    }
    return;
  }
  float sq;
  if (k < 0.38f)
    sq = 1.0f - ease_in(k / 0.38f);
  else if (k < 0.52f)
    sq = 0.0f;
  else
    sq = ease_out((k - 0.52f) / 0.48f);
  float st = 1.0f + 0.10f * bump(k);
  for (int i = 0; i < 2; ++i) {
    if (!blinkable(composed_.eye[i].kind)) continue;
    composed_.eye[i].squash *= sq;
    composed_.eye[i].stretch *= st;
  }
  want(period, frame_ms());
}

void FaceEngine::schedule_gaze(uint32_t from) {
  if (!preset_) return;
  uint32_t lo, hi;
  switch (preset_->gaze) {
    case Gaze::Still: lo = 3000, hi = 7000; break;
    case Gaze::Around: lo = 700, hi = 1800; break;
    case Gaze::Dart: lo = 250, hi = 700; break;
    case Gaze::Up:
    case Gaze::Down:
    case Gaze::UpSide: lo = 1500, hi = 3500; break;
    case Gaze::Left:
    case Gaze::Right:
    case Gaze::Avert: lo = 1800, hi = 4000; break;
    case Gaze::Idle:
    default: lo = 1200, hi = 3600; break;
  }
  // Спокойное лицо и осматривается вдвое реже.
  g_next_ = from + (lo + rng_.next() % (hi - lo)) * (calm_ ? 2u : 1u);
}

void FaceEngine::update_gaze(uint32_t now, uint32_t& period) {
  if (g_ext_ && time_reached(now, g_ext_until_)) g_ext_ = false;
  if (opt_.idle_motion && !g_moving_ && !g_ext_ && time_reached(now, g_next_)) {
    float tx = 0, ty = 0;
    float r = rng_.unit();
    switch (preset_->gaze) {
      case Gaze::Idle:
        if (r < 0.55f)
          tx = rng_.range(-0.25f, 0.25f), ty = rng_.range(-0.2f, 0.2f);
        else if (r < 0.88f)
          tx = rng_.range(-0.8f, 0.8f), ty = rng_.range(-0.5f, 0.4f);
        else
          tx = rng_.chance(0.5f) ? -0.95f : 0.95f, ty = rng_.range(-0.3f, 0.3f);
        break;
      case Gaze::Still: tx = rng_.range(-0.12f, 0.12f), ty = rng_.range(-0.1f, 0.1f); break;
      case Gaze::Around: tx = rng_.range(-1.0f, 1.0f), ty = rng_.range(-0.7f, 0.5f); break;
      case Gaze::Up: tx = rng_.range(-0.35f, 0.35f), ty = rng_.range(-0.95f, -0.75f); break;
      case Gaze::Down: tx = rng_.range(-0.4f, 0.4f), ty = rng_.range(0.7f, 0.95f); break;
      case Gaze::Left: tx = rng_.range(-1.0f, -0.85f), ty = rng_.range(-0.15f, 0.15f); break;
      case Gaze::Right: tx = rng_.range(0.85f, 1.0f), ty = rng_.range(-0.15f, 0.15f); break;
      case Gaze::Avert: tx = (gx_ > 0 ? -0.8f : 0.8f), ty = rng_.range(0.5f, 0.75f); break;
      case Gaze::Dart: tx = rng_.range(-1.0f, 1.0f), ty = rng_.range(-0.6f, 0.6f); break;
      case Gaze::UpSide: tx = rng_.range(0.6f, 0.9f) * (r < 0.8f ? 1.0f : -1.0f), ty = rng_.range(-0.9f, -0.65f); break;
    }
    g_from_x_ = gx_, g_from_y_ = gy_;
    g_to_x_ = tx, g_to_y_ = ty;
    float dist = fabs_(tx - gx_) + fabs_(ty - gy_);
    g_ms_ = (uint16_t)(50.0f + 45.0f * dist);
    g_t0_ = now;
    g_moving_ = dist > 0.04f;
    schedule_gaze(now);
  }
  float squash = 1.0f;
  if (g_moving_) {
    float k = (float)(now - g_t0_) / (float)g_ms_;
    if (k >= 1.0f) {
      gx_ = g_to_x_, gy_ = g_to_y_;
      g_moving_ = false;
    } else {
      float e = ease_out(k);
      gx_ = lerpf(g_from_x_, g_to_x_, e);
      gy_ = lerpf(g_from_y_, g_to_y_, e);
      float dist = fabs_(g_to_x_ - g_from_x_) + fabs_(g_to_y_ - g_from_y_);
      if (dist > 0.5f) squash = 1.0f - 0.12f * bump(k);
      want(period, frame_ms());
    }
  }
  composed_.gx = gx_;
  composed_.gy = gy_;
  if (squash < 1.0f) {
    for (int i = 0; i < 2; ++i)
      if (blinkable(composed_.eye[i].kind)) composed_.eye[i].squash *= squash;
  }
}

namespace {

// Сдвиг лица от движения пресета — в целых пикселях: лицо и так стоит на целых
// координатах, а целые сдвиги позволяют точно знать, когда картинка сменится,
// и не будить процессор между этими моментами.
struct MotionStep {
  int ox = 0, oy = 0, tilt = 0;
  float scale = 1.0f;  // Pulse: масштаб глаз
  bool operator==(const MotionStep& o) const { return ox == o.ox && oy == o.oy && tilt == o.tilt && scale == o.scale; }
};

// Период движения в мс. Фаза считается от целых мс по модулю периода,
// поэтому анимация не теряет точность, сколько бы ни держалась эмоция.
uint32_t motion_period(const Expression& x) {
  const uint32_t p = (uint32_t)imax(2, iround(1000.0f / fmax_(x.motion_hz, 0.05f)));
  return x.motion == Motion::Float ? p * 2 : p;  // вторая составляющая — с половинной частотой
}

MotionStep motion_at(const Expression& x, uint32_t el) {
  MotionStep m;
  const float A = x.motion_amp;
  const uint32_t P = motion_period(x);
  const float ph = (float)(el % P) / (float)P;
  const float s = fsin(kTau * ph);
  switch (x.motion) {
    case Motion::None: break;
    case Motion::Bounce: m.oy = -iround(A * fabs_(fsin(kPi * ph))); break;
    case Motion::Bob: m.oy = iround(A * s); break;
    case Motion::Tremble: {
      const uint32_t h = hash32((el / P) * 2654435761u ^ 0x5bd1e995u);
      const int a = (int)A, span = a * 2 + 1;
      m.ox = (int)(h % (uint32_t)span) - a;
      m.oy = (int)((h >> 8) % (uint32_t)span) - a;
      break;
    }
    case Motion::Shake: m.ox = iround(A * s); break;
    case Motion::Sway:
      m.ox = iround(A * s);
      m.tilt = iround(A * 0.5f * s);
      break;
    case Motion::Shiver:
      // Дрожь приступами: 1 с из 4, иначе холод съест батарею.
      if (el % 4000u < 1000u) m.ox = el % P < P / 2 ? iround(A) : -iround(A);
      break;
    case Motion::Pulse: {
      const float k = bump(clampf(ph / 0.16f, 0.0f, 1.0f)) + 0.7f * bump(clampf((ph - 0.22f) / 0.16f, 0.0f, 1.0f));
      m.scale = 1.0f + A * 0.01f * k;
      break;
    }
    case Motion::Float:
      m.oy = iround(A * fsin(kTau * 2.0f * ph));  // период Float — двойной
      m.ox = iround(A * 0.6f * s);
      break;
    case Motion::Nod: m.oy = iround(A * fabs_(fsin(kPi * ph))); break;
    case Motion::Wobble:
      m.tilt = iround(A * s);
      m.ox = iround(A * 0.4f * s);
      break;
  }
  return m;
}

// Через сколько мс движение сдвинет лицо хотя бы на пиксель (не дальше limit).
uint32_t motion_wait(const Expression& x, uint32_t el, uint32_t limit) {
  const uint32_t P = motion_period(x);
  switch (x.motion) {
    case Motion::None: return 0;
    case Motion::Pulse: return 40;  // глаза плавно меняют размер
    case Motion::Tremble: return P - el % P;
    case Motion::Shiver: {
      const uint32_t c = el % 4000u;
      if (c >= 1000u) return 4000u - c;  // до следующего приступа
      const uint32_t in = el % P, flip = in < P / 2 ? P / 2 - in : P - in;  // смена стороны
      return flip < 1000u - c ? flip : 1000u - c;
    }
    default: break;
  }
  // Плавные движения: шагаем вперёд, пока сдвиг не сменится, затем уточняем делением пополам.
  const MotionStep cur = motion_at(x, el);
  const uint32_t step = (uint32_t)imax(2, (int)(P / 32));
  uint32_t lo = 0;
  for (uint32_t d = step; d <= limit; d += step) {
    if (!(motion_at(x, el + d) == cur)) {
      uint32_t hi = d;
      while (hi - lo > 1) {
        const uint32_t mid = (lo + hi) / 2;
        if (motion_at(x, el + mid) == cur)
          lo = mid;
        else
          hi = mid;
      }
      return hi;
    }
    lo = d;
  }
  return limit;
}

}  // namespace

void FaceEngine::apply_motion(uint32_t now) {
  if (!preset_ || preset_->motion == Motion::None) return;
  const uint32_t el = now - expr_t0_;
  const MotionStep m = motion_at(*preset_, el);
  Face& c = composed_;
  c.ox += (float)m.ox;
  c.oy += (float)m.oy;
  c.layout.tilt += (float)m.tilt;
  if (m.scale != 1.0f) {
    for (int i = 0; i < 2; ++i) {
      c.eye[i].sx *= m.scale;
      c.eye[i].sy *= m.scale;
    }
  }
  // Кадр нужен ровно тогда, когда лицо сдвинется на пиксель, но не чаще frame_ms.
  // Медленному движению не к спеху: его шаг может подождать до 200 мс и уйти
  // вместе с кадром, который и так запланирован (например, для Zzz во сне).
  const uint32_t P = motion_period(*preset_);
  const uint32_t w = motion_wait(*preset_, el, (uint32_t)imin((int)P, 10000));
  motion_wake_ = w > frame_ms() ? w : frame_ms();
  motion_slack_ = P >= 1000u ? (uint32_t)imin(200, (int)(P / 16)) : 0u;
}

void FaceEngine::apply_clip(uint32_t now, uint32_t& period) {
  glitch_ = 0;
  if (!clip_active_) return;
  const uint32_t dur = clip_duration_ms(clip_);
  const float ms = (float)(now - clip_t0_);
  if (ms >= (float)dur) {
    clip_active_ = false;
    return;
  }
  want(period, frame_ms());
  const float k = ms / (float)dur;
  Face& c = composed_;
  switch (clip_) {
    case Clip::blink:
    case Clip::Count:
    case Clip::None: break;
    case Clip::wink: {
      float env = envelope(k, 0.18f, 0.3f);
      c.eye[1].squash *= 1.0f - env;
      c.eye[0].low_cov = fmax_(c.eye[0].low_cov, 0.12f * env);
      c.mouth.curve += 2.5f * env;
      break;
    }
    case Clip::nod: c.oy += 3.0f * fabs_(fsin(kTau * k)) * (1.0f - k * 0.3f); break;
    case Clip::headshake: c.ox += 4.0f * fsin(kTau * 3.0f * k) * envelope(k, 0.1f, 0.3f); break;
    case Clip::startle: {
      float env = envelope(k, 0.1f, 0.6f);
      for (int i = 0; i < 2; ++i) {
        c.eye[i].sx *= 1.0f + 0.25f * env;
        c.eye[i].sy *= 1.0f + 0.25f * env;
      }
      c.oy -= 3.0f * bump(clampf(k * 2.0f, 0.0f, 1.0f));
      break;
    }
    case Clip::yawn: {
      float env = envelope(k, 0.32f, 0.28f);
      if (env > 0.08f) {
        float yw = 10.0f + 5.0f * env, yh = 4.0f + 14.0f * env;
        c.mouth.kind = MouthKind::Ring;
        c.mouth.w = yw;
        c.mouth.h = yh;
        c.mouth.t = 3.0f;
        c.mouth.sx = 1.0f;
        c.mouth.dy += env * 2.0f;
      }
      for (int i = 0; i < 2; ++i) {
        if (blinkable(c.eye[i].kind)) c.eye[i].squash *= 1.0f - 0.85f * env;
      }
      c.oy -= 2.0f * env;
      break;
    }
    case Clip::double_take: {
      float gx;
      if (ms < 220)
        gx = ease_out(ms / 220.0f) * 0.9f;
      else if (ms < 400)
        gx = 0.9f * (1.0f - ease_in_out((ms - 220) / 180.0f));
      else if (ms < 520)
        gx = 0.95f * ease_out((ms - 400) / 120.0f);
      else if (ms < 850)
        gx = 0.95f;
      else
        gx = 0.95f * (1.0f - (ms - 850) / 150.0f);
      c.gx = gx;
      if (ms > 400 && ms < 850) {
        float e = bump((ms - 400) / 450.0f);
        for (int i = 0; i < 2; ++i) {
          c.eye[i].sx *= 1.0f + 0.22f * e;
          c.eye[i].sy *= 1.0f + 0.22f * e;
        }
      }
      break;
    }
    case Clip::sneeze: {
      if (ms < 800) {
        float a = ease_in_out(ms / 800.0f);
        for (int i = 0; i < 2; ++i)
          if (blinkable(c.eye[i].kind)) c.eye[i].squash *= 1.0f - 0.55f * a;
        c.mouth.kind = MouthKind::Ring;
        c.mouth.w = 6.0f + 4.0f * a;
        c.mouth.h = 5.0f + 5.0f * a;
        c.mouth.t = 2.5f;
        c.mouth.sx = 1.0f;
        c.oy -= 2.5f * a;
      } else if (ms < 1000) {
        float b = (ms - 800) / 200.0f;
        for (int i = 0; i < 2; ++i) {
          const float dx0 = c.eye[i].dx;
          c.eye[i] = chevron(22, 18, 4);
          c.eye[i].dx = dx0;
        }
        c.mouth = open(20, 0, 9);
        c.oy += 4.0f * bump(b);
        c.ox += 2.0f * fsin(b * kTau * 2.0f);
      } else {
        float r = (ms - 1000) / 600.0f;
        for (int i = 0; i < 2; ++i)
          if (blinkable(c.eye[i].kind)) c.eye[i].squash *= 0.4f + 0.6f * ease_out(r);
      }
      break;
    }
    case Clip::look_around: {
      float gx = 0, gy = 0;
      if (ms < 120)
        gx = -ease_out(ms / 120.0f);
      else if (ms < 750)
        gx = -1.0f;
      else if (ms < 900)
        gx = -1.0f + 2.0f * ease_in_out((ms - 750) / 150.0f);
      else if (ms < 1600)
        gx = 1.0f;
      else if (ms < 1750)
        gx = 1.0f - ease_in_out((ms - 1600) / 150.0f), gy = -0.5f * ease_out((ms - 1600) / 150.0f);
      else if (ms < 2100)
        gx = 0, gy = -0.5f;
      else
        gy = -0.5f * (1.0f - (ms - 2100) / 200.0f);
      c.gx = gx;
      c.gy = gy;
      break;
    }
    case Clip::hop: {
      float h = fabs_(fsin(kPi * 2.0f * k));
      c.oy -= 7.0f * h;
      if (h < 0.2f && k > 0.05f)
        for (int i = 0; i < 2; ++i) c.eye[i].squash *= 0.85f;
      break;
    }
    case Clip::shiver:
      c.ox += ((int)(ms / 40.0f) & 1) ? 1.0f : -1.0f;
      for (int i = 0; i < 2; ++i) c.eye[i].squash *= 0.92f;
      break;
    case Clip::peek: {
      if (ms < 700)
        c.oy += 44.0f * (1.0f - ease_out_back(ms / 700.0f));
      else if (ms < 1000)
        c.gx = -0.9f * bump((ms - 700) / 300.0f);
      else if (ms < 1300)
        c.gx = 0.9f * bump((ms - 1000) / 300.0f);
      break;
    }
    case Clip::glitch: glitch_ = 1.0f - k; break;
    case Clip::eye_roll: {
      if (ms < 900) {
        float th = kPi + kPi * ease_in_out(ms / 900.0f);
        c.gx = fcos(th);
        c.gy = 0.85f * fsin(th);
      } else {
        c.gx = 1.0f - (ms - 900) / 400.0f;
      }
      for (int i = 0; i < 2; ++i) c.eye[i].lid_cov = fmax_(c.eye[i].lid_cov, 0.3f * envelope(k, 0.2f, 0.2f));
      break;
    }
    case Clip::sigh: {
      float env = envelope(k, 0.35f, 0.35f);
      for (int i = 0; i < 2; ++i) c.eye[i].lid_cov = fmax_(c.eye[i].lid_cov, 0.45f * env);
      c.oy += 2.0f * env;
      if (env > 0.5f) {
        c.mouth.kind = MouthKind::Ring;
        c.mouth.w = 6.0f;
        c.mouth.h = 6.0f;
        c.mouth.t = 2.0f;
        c.mouth.sx = 1.0f;
      }
      break;
    }
    case Clip::boop: {
      // «Тык!»: глаза сплющиваются на пару кадров и отскакивают.
      const float hit = bump(clampf(ms / 120.0f, 0.0f, 1.0f));
      const float rebound = bump(clampf((ms - 120.0f) / 340.0f, 0.0f, 1.0f));
      for (int i = 0; i < 2; ++i) {
        c.eye[i].squash *= 1.0f - 0.3f * hit + 0.06f * rebound;
        c.eye[i].stretch *= 1.0f + 0.1f * hit;
      }
      c.oy += 2.0f * hit;
      break;
    }
    case Clip::shake_off: {
      c.ox += 5.0f * fsin(kTau * ms / 110.0f) * (1.0f - k);
      for (int i = 0; i < 2; ++i)
        if (blinkable(c.eye[i].kind)) c.eye[i].squash *= 0.75f + 0.25f * k;
      break;
    }
  }
}

void FaceEngine::overlays_update(uint32_t now, uint32_t& period) {
  // Появление и исчезание идут не быстрее кадра: если лицо до этого спало,
  // первый кадр не перескакивает сразу к концу и «пружинка» значка видна.
  uint32_t dt = now - ov_last_;
  if (dt > frame_ms()) dt = frame_ms();
  ov_last_ = now;
  const float step = (float)dt / 180.0f;
  for (int i = 0; i < (int)Overlay::Count; ++i) {
    const bool on = (ov_target_ >> i) & 1ull;
    float& a = ov_alpha_[i];
    if (on && a < 1.0f) {
      if (a <= 0.0f) ov_t0_[i] = now;
      a = fmin_(1.0f, a + step);
      want(period, frame_ms());
    } else if (!on && a > 0.0f) {
      a = fmax_(0.0f, a - step);
      want(period, frame_ms());
    }
  }
}

namespace {

// Ступень, которой рисуется сглаженный наклон.
inline float tilt_quantize(float v) { return (float)iround(v / kTiltStep) * kTiltStep; }

// Через сколько мс сглаженный наклон c, догоняющий цель x, перейдёт на другую
// ступень. За один шаг dt разрыв сжимается в 120 / (dt + 120) раз, отсюда
// dt = 120 · (разрыв / нужный разрыв − 1). Ступень не сменится — ждать нечего.
uint32_t tilt_wait(float c, float x) {
  const float gap = fabs_(x - c);
  const int q = iround(c / kTiltStep);
  if (gap <= 0.02f || q == iround(x / kTiltStep)) return kMaxSleepMs;
  const float edge = ((float)q + (x > c ? 0.5f : -0.5f)) * kTiltStep;
  const float need = fmax_(fabs_(x - edge) - 0.001f, 0.001f);
  return (uint32_t)(120.0f * fmax_(gap / need - 1.0f, 0.0f)) + 1u;
}

}  // namespace

void FaceEngine::apply_tilt(uint32_t now, uint32_t& period) {
  // Зрачки догоняют силу тяжести с небольшой инерцией.
  uint32_t dt_ms = now - tilt_last_;
  tilt_last_ = now;
  if (dt_ms > 1000u) dt_ms = 1000u;
  const float dt = (float)dt_ms, k = dt / (dt + 120.0f);
  tilt_cx_ += (tilt_x_ - tilt_cx_) * k;
  tilt_cy_ += (tilt_y_ - tilt_cy_) * k;
  if (fabs_(tilt_x_ - tilt_cx_) <= 0.02f && fabs_(tilt_y_ - tilt_cy_) <= 0.02f) {
    tilt_cx_ = tilt_x_, tilt_cy_ = tilt_y_;  // догнали
  } else {
    // Наклон рисуется ступенями: просыпаемся, только когда ступень сменится.
    const uint32_t wx = tilt_wait(tilt_cx_, tilt_x_), wy = tilt_wait(tilt_cy_, tilt_y_);
    const uint32_t w = wx < wy ? wx : wy;
    want(period, w > frame_ms() ? w : frame_ms());
  }
  tilt_qx_ = tilt_quantize(tilt_cx_);
  tilt_qy_ = tilt_quantize(tilt_cy_);
  if (fabs_(tilt_qx_) > 0.01f || fabs_(tilt_qy_) > 0.01f) {
    // Чем сильнее наклон, тем меньше остаётся от собственного взгляда.
    const float wx = fabs_(tilt_qx_), wy = fabs_(tilt_qy_);
    composed_.gx = clampf(composed_.gx * (1.0f - 0.85f * wx) + tilt_qx_ * 0.95f, -1.0f, 1.0f);
    composed_.gy = clampf(composed_.gy * (1.0f - 0.6f * wy) + tilt_qy_ * 0.4f, -0.6f, 0.6f);
  }
}

bool FaceEngine::update(uint32_t now) {
  if (!preset_) init(1, now);
  if (preset_->hold_ms && now - expr_t0_ >= preset_->hold_ms)
    set_expression(filter_ ? filter_(preset_->next, filter_ctx_) : preset_->next, now);
  if (!calm_ && opt_.calm_after_ms && now - active_ms_ >= opt_.calm_after_ms) calm_ = true;

  uint32_t period = kMaxSleepMs;  // через сколько мс нужен кадр; статичному лицу — через kMaxSleepMs

  if (tr_active_) {
    float k = (float)(now - tr_t0_) / (float)tr_ms_;
    if (k >= 1.0f) {
      base_ = to_;
      fit_x_ = fit_to_x_, fit_y_ = fit_to_y_;
      tr_active_ = false;
    } else {
      const float e = ease_in_out(k);
      lerp_mouth(from_.mouth, to_.mouth, e, base_.mouth);
      for (int i = 0; i < 2; ++i) {
        if (eye_swap_[i]) {
          // Смена формы глаза прячется за морганием: закрыть — подменить — открыть.
          Eye pos;
          lerp_eye(from_.eye[i], to_.eye[i], e, pos);
          if (k < 0.5f) {
            base_.eye[i] = from_.eye[i];
            base_.eye[i].squash = from_.eye[i].squash * (1.0f - ease_in(k * 2.0f));
          } else {
            base_.eye[i] = to_.eye[i];
            base_.eye[i].squash = ease_out(k * 2.0f - 1.0f);
          }
          base_.eye[i].dx = pos.dx;
          base_.eye[i].dy = pos.dy;
        } else {
          lerp_eye(from_.eye[i], to_.eye[i], e, base_.eye[i]);
        }
        lerp_brow(from_.brow[i], to_.brow[i], e, base_.brow[i]);
      }
      if (mouth_swap_) {
        const Mouth& src = k < 0.5f ? from_.mouth : to_.mouth;
        base_.mouth = src;
        base_.mouth.sx =
            src.sx * (k < 0.5f ? 1.0f - 0.85f * ease_in(k * 2.0f) : 0.15f + 0.85f * ease_out(k * 2.0f - 1.0f));
        base_.mouth.dx = lerpf(from_.mouth.dx, to_.mouth.dx, e);
        base_.mouth.dy = lerpf(from_.mouth.dy, to_.mouth.dy, e);
      }
      base_.layout.spacing = lerpf(from_.layout.spacing, to_.layout.spacing, e);
      base_.layout.eye_y = lerpf(from_.layout.eye_y, to_.layout.eye_y, e);
      base_.layout.mouth_y = lerpf(from_.layout.mouth_y, to_.layout.mouth_y, e);
      base_.layout.tilt = lerpf(from_.layout.tilt, to_.layout.tilt, e);
      fit_x_ = lerpf(fit_from_x_, fit_to_x_, e);
      fit_y_ = lerpf(fit_from_y_, fit_to_y_, e);
      want(period, frame_ms());
    }
  }

  composed_ = base_;
  composed_.ox = fit_x_;
  composed_.oy = fit_y_;
  motion_wake_ = 0;
  for (int i = 0; i < 2; ++i) {
    // Спирали крутятся, пока держится эмоция: 0.3°/мс, оборот за 1.2 с.
    if (composed_.eye[i].kind == EyeKind::Spiral) {
      composed_.eye[i].rot += (float)((now - expr_t0_) % 1200u) * 0.3f;
      want(period, 50);
    }
  }
  apply_motion(now);
  update_gaze(now, period);
  apply_accent(now, period);
  update_blink(now, period);
  apply_clip(now, period);
  apply_tilt(now, period);

  // Киберпанк: редкие короткие сбои сигнала, раз в 45–150 с.
  const bool cyber = opt_.theme == Theme::Cyber;
  if ((cyber || opt_.glitches) && opt_.idle_motion && scene_ == Scene::None) {
    if (time_reached(now, micro_glitch_next_)) {
      micro_glitch_on_ = true;
      micro_glitch_until_ = now + 140u;
      micro_glitch_next_ = now + 45000u + rng_.next() % 105000u;
    }
    if (micro_glitch_on_ && time_reached(now, micro_glitch_until_)) micro_glitch_on_ = false;
    if (micro_glitch_on_) {
      glitch_ = fmax_(glitch_, 0.3f);
      want(period, 50);
    }
  }
  // Прицел: только в кибер-теме и только поверх лица, не сцены.
  if (cyber && opt_.idle_motion && scene_ == Scene::None && time_reached(now, scan_next_)) {
    scan(now);
    scan_next_ = now + kScanMinMs + rng_.next() % kScanSpreadMs;
  }
  float reticle = -1.0f;  // < 0 — не виден, иначе 0..1 — насколько уголки съехались
  uint32_t reticle_wake = 0;
  if (reticle_on_) {
    const uint32_t rt = now - reticle_t0_, blink_at = reticle_ms_ - kReticleBlinkMs;
    if (!cyber || rt >= reticle_ms_) {
      reticle_on_ = false;
    } else if (rt < kReticleLockMs) {
      reticle = ease_out((float)rt / (float)kReticleLockMs);
      want(period, frame_ms());
    } else if (rt < blink_at) {
      reticle = 1.0f;
      reticle_wake = blink_at - rt;
    } else {
      const uint32_t b = rt - blink_at;
      reticle = (b / kReticleBlinkStep) % 2u ? -1.0f : 1.0f;
      reticle_wake = kReticleBlinkStep - b % kReticleBlinkStep;
    }
  }
  if (scene_ != Scene::None) reticle = -1.0f;
  reticle_shown_ = reticle >= 0.0f;
  // Надпись в углу: мигает, потом горит до конца срока.
  uint32_t badge_wake = 0;
  bool badge_vis = false;
  if (badge_on_) {
    const uint32_t bt = now - badge_t0_;
    if (bt >= badge_ms_) {
      badge_on_ = false;
    } else if (bt < kBadgeBlinkMs) {
      badge_vis = (bt / kBadgeBlinkStep) % 2u == 0u;
      badge_wake = kBadgeBlinkStep - bt % kBadgeBlinkStep;
    } else {
      badge_vis = true;
      badge_wake = badge_ms_ - bt;
    }
  }
  badge_shown_ = badge_vis && scene_ == Scene::None;
  const bool glint = quirks_.cyber_eye && (now % 5000u) < 400u;
  if (glint) want(period, 100);

  // Сцена поверх всего: лицо живёт под ней, но на экран идёт сцена.
  uint32_t scene_t = 0;
  if (scene_ != Scene::None) {
    scene_t = now - scene_t0_;
    if (scene_t >= scene_duration_ms(scene_)) {
      scene_ = Scene::None;
      want(period, frame_ms());
    } else {
      const uint16_t sp = scene_frame_ms(scene_, scene_t);
      scene_t -= scene_t % sp;
      want(period, sp);
    }
  }

  if (opt_.drift && time_reached(now, drift_next_)) {
    // Шаг дрейфа на 1 px раз в 20–40 с: глаза не стоят часами на одних пикселях.
    int nx = drift_x_ + rng_.irange(-1, 1), ny = drift_y_ + rng_.irange(-1, 1);
    drift_x_ = iclamp(nx, -3, 3);
    drift_y_ = iclamp(ny, -2, 2);
    drift_next_ = now + 20000u + rng_.next() % 20000u;
  }
  if (opt_.drift) {
    composed_.ox += (float)iclamp(drift_x_, drift_lo_x_, drift_hi_x_);
    composed_.oy += (float)iclamp(drift_y_, drift_lo_y_, drift_hi_y_);
  }

  overlays_update(now, period);

  // У каждого значка свои часы: время для отрисовки меняется, только когда меняется
  // картинка значка, поэтому кадр ради чужого движения не перерисовывает его лишний раз.
  uint32_t ov_local[(int)Overlay::Count];
  Hasher hs;
  hs.face(composed_);
  for (int i = 0; i < (int)Overlay::Count; ++i) {
    ov_local[i] = 0;
    if (ov_alpha_[i] <= 0.0f) continue;
    uint32_t wait = 0;
    ov_local[i] = overlay_clock((Overlay)i, now - ov_t0_[i], &wait);
    if (wait) want(period, wait);
    hs.byte((uint8_t)i);
    hs.f(ov_alpha_[i]);
    hs.u32(ov_local[i]);
  }
  hs.f(glitch_);
  hs.u32(glitch_ > 0.0f ? now / 50u : 0u);
  hs.byte((uint8_t)(opt_.scanlines | opt_.upside_down << 1));
  hs.byte((uint8_t)((uint8_t)opt_.theme | quirks_.cyber_eye << 2 | glint << 3));
  hs.f(reticle);
  hs.byte((uint8_t)badge_shown_);
  for (int i = 0; badge_shown_ && badge_[i]; ++i) hs.byte((uint8_t)badge_[i]);
  hs.byte((uint8_t)scene_);
  hs.u32(scene_t);
  hs.u32(opt_.scanlines ? (expr_t0_ / 1000u + now / 20000u) & 1u : 0u);

  // Ничего не изменилось — не рисуем вовсе (на МК это экономит процессорное время).
  const bool same = has_frame_ && hs.h == frame_hash_;
  frame_hash_ = hs.h;
  has_frame_ = true;
  if (same) {
    dirty_n_ = 0;
  } else {
    back_.clear();
    if (scene_ != Scene::None) {
      render_scene(back_, scene_, scene_t, scene_p_, composed_);
    } else {
      Anchors anchors;
      render_face(back_, composed_, &anchors);
      const InkBox face = ink_box(back_);
      for (int i = 0; i < (int)Overlay::Count; ++i) {
        if (ov_alpha_[i] > 0.0f && !overlay_screen_space((Overlay)i))
          render_overlay(back_, (Overlay)i, anchors, ov_alpha_[i], (float)ov_local[i] * 0.001f);
      }
      keep_inside(back_, anchors, face);
      for (int i = 0; i < (int)Overlay::Count; ++i) {
        if (ov_alpha_[i] > 0.0f && overlay_screen_space((Overlay)i))
          render_overlay(back_, (Overlay)i, anchors, ov_alpha_[i], (float)ov_local[i] * 0.001f);
      }
      render_theme(back_, anchors, reticle, quirks_.cyber_eye, glint);
      if (opt_.theme == Theme::Retro) pixelate(back_);
      if (badge_shown_) {
        // Под надписью — тёмная подложка: читается поверх бровей и значков.
        const int x0 = kSafeMargin, y0 = kSafeMargin, x1 = x0 + text_width(badge_) - 1, y1 = y0 + text_height() - 1;
        for (int y = y0 - 1; y <= y1 + 1; ++y) back_.hspan(y, x0 - 1, x1 + 1, Ink::Clear);
        draw_text(back_, x0, y0, badge_);
      }
    }

    if (glitch_ > 0.0f) {
      // Сбой: сдвигаем полосы строк и инвертируем одну из них.
      uint32_t h = hash32((now / 50u) * 2246822519u);
      int bands = 2 + (int)(glitch_ * 4.0f);
      for (int b = 0; b < bands; ++b) {
        h = hash32(h + (uint32_t)b);
        int y0 = (int)(h % kHeight), len = 2 + (int)((h >> 8) % 6u), sh = (int)((h >> 16) % 13u) - 6;
        for (int y = y0; y < y0 + len && y < kHeight; ++y) {
          bool row[kWidth];
          for (int x = 0; x < kWidth; ++x) row[x] = back_.get(x, y);
          for (int x = 0; x < kWidth; ++x) {
            int sx = x - sh;
            back_.plot(x, y, (sx >= 0 && sx < kWidth && row[sx]) ? Ink::Set : Ink::Clear);
          }
        }
        if (b == 0) {
          int yy = (int)((h >> 4) % kHeight);
          back_.hspan(yy, 0, kWidth - 1, Ink::Invert);
        }
      }
    }
    if (opt_.scanlines) {
      const int phase = (int)((expr_t0_ / 1000u + now / 20000u) & 1u);
      for (int y = phase; y < kHeight; y += 2) back_.hspan(y, 0, kWidth - 1, Ink::Clear);
    }
    if (opt_.upside_down) back_.rotate180();

    ++stats_.renders;
    dirty_n_ = diff_frames(front_, back_, dirty_);
    if (dirty_n_) {
      front_.copy_from(back_);
      ++stats_.frames;
      stats_.bytes += (uint32_t)dirty_bytes(dirty_, dirty_n_);
    }
  }

  // Когда проснуться: ближайшее запланированное событие, но не дальше kMaxSleepMs.
  // Все сроки — через time_left, поэтому переполнение millis() ничего не ломает.
  uint32_t wake[16];
  int nw = 0;
  auto at = [&](uint32_t t) {
    const uint32_t d = time_left(now, t);
    if (d) wake[nw++] = d;
  };
  wake[nw++] = period;
  if (opt_.idle_motion) {
    if (blink_armed_) at(blink_next_);
    at(g_next_);
    if (g_ext_) at(g_ext_until_);
    if (!accent_on_ && preset_->accent != Accent::None) at(accent_next_);
  }
  if (opt_.drift) at(drift_next_);
  if (preset_->hold_ms) at(expr_t0_ + preset_->hold_ms);
  if (opt_.scanlines) wake[nw++] = 20000u - now % 20000u;
  if (quirks_.cyber_eye) wake[nw++] = (glint ? 400u : 5000u) - now % 5000u;
  if ((cyber || opt_.glitches) && opt_.idle_motion) {
    at(micro_glitch_next_);
    if (micro_glitch_on_) at(micro_glitch_until_);
    if (cyber && scene_ == Scene::None) at(scan_next_);
  }
  if (reticle_wake) wake[nw++] = reticle_wake;
  if (badge_wake) wake[nw++] = badge_wake;
  if (reticle_on_) at(reticle_t0_ + reticle_ms_);
  if (scene_ != Scene::None) at(scene_ends_ms());
  // События, выпавшие рядом, сливаются: процессор просыпается один раз на всех.
  uint32_t first = kMaxSleepMs;
  for (int i = 0; i < nw; ++i)
    if (wake[i] < first) first = wake[i];
  // Шаг движения ждёт ближайшего кадра, если тот в пределах его запаса.
  if (motion_wake_ && (first < motion_wake_ || first > motion_wake_ + motion_slack_)) {
    wake[nw++] = motion_wake_;
    if (motion_wake_ < first) first = motion_wake_;
  }
  uint32_t sleep = first;
  for (int i = 0; i < nw; ++i)
    if (wake[i] > sleep && wake[i] <= first + kWakeMergeMs) sleep = wake[i];
  next_update_ = now + (sleep ? sleep : 1u);
  last_now_ = now;
  return dirty_n_ > 0;
}

}  // namespace face
