olerast67/emotion-keychain/engine/src/expressions.cpp

// Каталог эмоций. Раскладка по умолчанию: глаза-кольца Ø30 с обводкой 4 px,
// центры глаз на x = 37 и 91, y = 27; рот на y = 49. Все размеры в пикселях.
//
// Чтобы добавить эмоцию: допишите id в FACE_EXPR_LIST (expressions.h) и пресет
// сюда в том же месте списка. Тест проверит, что порядок совпадает.
#include "face/expressions.h"

namespace face {

namespace {

using O = Overlay;

// Повторяющиеся детали.
constexpr Eye kRing = ring(30, 4);
constexpr Eye kLook = ring(30, 4).pupil(3, -3, 4);  // базовый взгляд: зрачки к носу и чуть вверх
constexpr Brow kSadBrow = brow(16, 16, 0);
constexpr Brow kAngryBrow = brow(18, -22, 0).at(0, 2);
constexpr Brow kWorryBrow = brow(16, 18, 1);

const Expression kExpressions[] = {
    // ---------------- Позитивные ----------------
    {.id = "neutral",
     .name = "Спокойствие",
     .name_en = "Neutral",
     .cat = Category::Positive,
     .eyes = both(kLook),
     .mouth = line(16),
     .accent = Accent::Breath,
     .accent_ms = 4000,
     .when = "Состояние по умолчанию: ничего особенного не происходит.",
     .when_en = "Default state: nothing special is happening."},
    {.id = "calm",
     .name = "Умиротворение",
     .name_en = "Calm",
     .cat = Category::Positive,
     .eyes = both(ring(30, 4).pupil(2, -1, 4).lid(0.22f, 0, 0.15f)),
     .mouth = smile(14, 2),
     .gaze = Gaze::Still,
     .blink = Blink::Slow,
     .accent = Accent::Breath,
     .accent_ms = 5000,
     .when = "Тихо, светло, никто не трогает уже несколько минут.",
     .when_en = "Quiet, bright, nobody has touched it for a few minutes."},
    {.id = "happy",
     .name = "Радость",
     .name_en = "Happy",
     .cat = Category::Positive,
     .eyes = both(ring(30, 4).pupil(3, -3, 4).low(0.28f, 0.6f)),
     .mouth = smile(20, 5),
     .accent = Accent::Grin,
     .accent_ms = 3500,
     .when = "Приятное событие: погладили, взяли в руки, хорошее настроение.",
     .when_en = "Something nice: petted, picked up, in a good mood."},
    {.id = "joy",
     .name = "Восторг",
     .name_en = "Joy",
     .cat = Category::Positive,
     .eyes = both(arc_up(28, 14, 4)),
     .mouth = open(22, 1, 8),
     .motion = Motion::Bob,
     .motion_amp = 1,
     .motion_hz = 1.5f,
     .accent = Accent::Hop,
     .accent_ms = 2500,
     .hold_ms = 5000,
     .next = Expr::happy,
     .when = "Очень хорошо: много внимания подряд, зарядился, утро после сна.",
     .when_en = "Feeling great: lots of attention in a row, fully charged, morning after sleep."},
    {.id = "laugh",
     .name = "Смех",
     .name_en = "Laughing",
     .cat = Category::Positive,
     .eyes = both(chevron(24, 20, 4)),
     .mouth = open(24, 0, 11),
     .overlays = ov(O::BlushLines),
     .motion = Motion::Bounce,
     .motion_amp = 2,
     .motion_hz = 3.2f,
     .blink = Blink::None,
     .accent = Accent::None,
     .hold_ms = 3500,
     .next = Expr::happy,
     .when = "Двойной тап, щекотка (частые лёгкие тапы), смешной звук.",
     .when_en = "Double tap, tickling (quick light taps), a funny sound."},
    {.id = "giggle",
     .name = "Хихиканье",
     .name_en = "Giggling",
     .cat = Category::Positive,
     .eyes = both(arc_up(26, 12, 4)),
     .mouth = open(14, 1, 5),
     .overlays = ov(O::BlushLines),
     .motion = Motion::Bounce,
     .motion_amp = 1,
     .motion_hz = 4,
     .blink = Blink::None,
     .accent = Accent::None,
     .hold_ms = 2500,
     .next = Expr::happy,
     .when = "Лёгкий тап в хорошем настроении; затихающий смех.",
     .when_en = "A light tap in a good mood; laughter fading out."},
    {.id = "love",
     .name = "Влюблённость",
     .name_en = "In love",
     .cat = Category::Positive,
     .eyes = both(heart(30, 27)),
     .mouth = smile(16, 4),
     .overlays = ov(O::Hearts),
     .motion = Motion::Pulse,
     .motion_amp = 10,
     .motion_hz = 1.1f,
     .blink = Blink::None,
     .accent = Accent::None,
     .hold_ms = 6000,
     .next = Expr::adoring,
     .when = "Долгое внимание: держат в руках, гладят, много тапов в хорошем настроении.",
     .when_en = "Long attention: held, petted, many taps in a good mood."},
    {.id = "adoring",
     .name = "Умиление",
     .name_en = "Adoring",
     .cat = Category::Positive,
     .eyes = both(filled(26, 28).glint(4, -6, 4).glint2(-4, 4, 2)),
     .mouth = smile(14, 4),
     .overlays = ov(O::BlushDither),
     .gaze = Gaze::Still,
     .accent = Accent::Glint,
     .accent_ms = 2500,
     .when = "После «влюблённости», тёплое спокойное внимание.",
     .when_en = "After “in love”: warm, calm attention."},
    {.id = "excited",
     .name = "Возбуждение",
     .name_en = "Excited",
     .cat = Category::Positive,
     .eyes = both(ring(32, 4).pupil(2, -3, 6)),
     .mouth = open(22, 2, 9),
     .overlays = ov(O::Sparkles),
     .motion = Motion::Bounce,
     .motion_amp = 2,
     .motion_hz = 2.5f,
     .gaze = Gaze::Around,
     .accent = Accent::Glint,
     .accent_ms = 2000,
     .hold_ms = 4000,
     .next = Expr::happy,
     .when = "Начало прогулки, бег, новое место, ждёт чего-то хорошего.",
     .when_en = "A walk begins, running, a new place, expecting something good."},
    {.id = "starstruck",
     .name = "Восхищение",
     .name_en = "Starstruck",
     .cat = Category::Positive,
     .eyes = both(star(30)),
     .mouth = open(20, 1, 8),
     .overlays = ov(O::Sparkles),
     .motion = Motion::Pulse,
     .motion_amp = 6,
     .motion_hz = 1.4f,
     .blink = Blink::None,
     .accent = Accent::None,
     .hold_ms = 4000,
     .next = Expr::happy,
     .when = "Что-то потрясающее: пасхалка, особая дата, редкое событие.",
     .when_en = "Something amazing: an easter egg, a special date, a rare event."},
    {.id = "proud",
     .name = "Гордость",
     .name_en = "Proud",
     .cat = Category::Positive,
     .eyes = both(ring(30, 4).pupil(1, -1, 4).lid(0.42f, -6)),
     .brows = brows(brow(15, 8, 1)),
     .mouth = smile(18, 3),
     .lay = layout(54, 25, 47),
     .gaze = Gaze::Up,
     .blink = Blink::Rare,
     .accent = Accent::Nod,
     .accent_ms = 3000,
     .hold_ms = 4000,
     .next = Expr::happy,
     .when = "Долго носили без падений, «рекорд» шагов, похвалили кнопкой.",
     .when_en = "Carried for a long time without falls, a step “record”, praised with the button."},
    {.id = "wink",
     .name = "Подмигивание",
     .name_en = "Wink",
     .cat = Category::Positive,
     .eyes = pair(kLook, arc_up(26, 12, 4)),
     .mouth = smile(18, 5),
     .blink = Blink::None,
     .accent = Accent::Grin,
     .accent_ms = 2000,
     .hold_ms = 1800,
     .next = Expr::happy,
     .when = "Приветствие, ответ на одиночный тап, случайная шалость.",
     .when_en = "A greeting, reply to a single tap, a random prank."},
    {.id = "playful",
     .name = "Дурачится",
     .name_en = "Playful",
     .cat = Category::Positive,
     .eyes = pair(chevron(22, 18, 4), kLook),
     .mouth = tongue(18, 2, 6),
     .blink = Blink::None,
     .accent = Accent::Wiggle,
     .accent_ms = 2500,
     .hold_ms = 3000,
     .next = Expr::happy,
     .when = "Игривое настроение, ответ на щекотку, «бе-е».",
     .when_en = "Playful mood, reply to tickling, sticking its tongue out."},
    {.id = "kiss",
     .name = "Поцелуй",
     .name_en = "Kiss",
     .cat = Category::Positive,
     .eyes = both(arc_down(24, 10, 4)),
     .mouth = pucker(12, 2.5f).at(1, 0),
     .overlays = ov(O::Hearts),
     .blink = Blink::None,
     .accent = Accent::Bob,
     .accent_ms = 2500,
     .hold_ms = 2500,
     .next = Expr::adoring,
     .when = "Нежность: долго держат в ладони, вечер после хорошего дня.",
     .when_en = "Tenderness: held in a palm for a long time, an evening after a good day."},
    {.id = "grateful",
     .name = "Благодарность",
     .name_en = "Grateful",
     .cat = Category::Positive,
     .eyes = both(arc_down(26, 10, 4)),
     .brows = brows(brow(14, 10, 1)),
     .mouth = smile(16, 4),
     .motion = Motion::Nod,
     .motion_amp = 2,
     .motion_hz = 0.8f,
     .blink = Blink::None,
     .accent = Accent::None,
     .hold_ms = 2600,
     .next = Expr::happy,
     .when = "Поставили на зарядку, когда был голоден; помогли после падения.",
     .when_en = "Put on charge while hungry; helped up after a fall."},
    {.id = "relieved",
     .name = "Облегчение",
     .name_en = "Relieved",
     .cat = Category::Positive,
     .eyes = both(arc_down(26, 9, 4)),
     .mouth = smile(14, 2),
     .overlays = ov(O::Sweat),
     .blink = Blink::None,
     .accent = Accent::Breath,
     .accent_ms = 3000,
     .hold_ms = 3000,
     .next = Expr::calm,
     .when = "Тряска закончилась, снова светло после темноты, зарядка после «голода».",
     .when_en = "Shaking stopped, light again after darkness, charging after “hunger”."},
    {.id = "content",
     .name = "Довольство",
     .name_en = "Content",
     .cat = Category::Positive,
     .eyes = both(ring(30, 4).pupil(0, 2, 4).lid(0.45f, -4, 0.1f)),
     .mouth = smile(18, 4),
     .gaze = Gaze::Still,
     .blink = Blink::Slow,
     .accent = Accent::Breath,
     .accent_ms = 5000,
     .when = "Сыт (заряжен), спокойная обстановка, после приятного события.",
     .when_en = "Well fed (charged), calm surroundings, after something nice."},

    // ---------------- Негативные ----------------
    {.id = "sad",
     .name = "Грусть",
     .name_en = "Sad",
     .cat = Category::Negative,
     .eyes = both(ring(30, 4).pupil(1, 3, 4).lid(0.26f, -22)),
     .brows = brows(kSadBrow),
     .mouth = smile(16, -5),
     .gaze = Gaze::Down,
     .blink = Blink::Slow,
     .accent = Accent::Breath,
     .accent_ms = 5000,
     .when = "Давно не трогали, грубо обошлись, затихающий плач.",
     .when_en = "Not touched for a long time, treated roughly, crying fading out."},
    {.id = "crying",
     .name = "Плач",
     .name_en = "Crying",
     .cat = Category::Negative,
     .eyes = both(ring(28, 4).pupil(1, 2, 3).lid(0.42f, -16)),
     .brows = brows(kSadBrow),
     .mouth = wavy(16, 1.5f),
     .overlays = ov(O::Tear),
     .gaze = Gaze::Down,
     .blink = Blink::Slow,
     .accent = Accent::Squint,
     .accent_ms = 2500,
     .hold_ms = 6000,
     .next = Expr::sad,
     .when = "После сильного удара или долгого одиночества; когда «рыдание» стихает.",
     .when_en = "After a hard hit or long loneliness; when “sobbing” calms down."},
    {.id = "sobbing",
     .name = "Рыдание",
     .name_en = "Sobbing",
     .cat = Category::Negative,
     .eyes = both(filled(26, 4, 2)),
     .brows = brows(brow(16, 20, 0)),
     .mouth = open(20, -6, 6),
     .overlays = ov(O::TearStream),
     .motion = Motion::Tremble,
     .motion_amp = 1,
     .motion_hz = 12,
     .blink = Blink::None,
     .accent = Accent::None,
     .hold_ms = 4000,
     .next = Expr::crying,
     .when = "Очень больно или обидно: падение с высоты, долгая тряска, «Т_Т».",
     .when_en = "Really hurt or offended: a fall from a height, long shaking, “T_T”."},
    {.id = "disappointed",
     .name = "Разочарование",
     .name_en = "Disappointed",
     .cat = Category::Negative,
     .eyes = both(ring(30, 4).pupil(0, 3, 4).lid(0.5f, -6)),
     .mouth = smile(12, -2),
     .gaze = Gaze::Down,
     .blink = Blink::Slow,
     .accent = Accent::Breath,
     .accent_ms = 5000,
     .hold_ms = 5000,
     .next = Expr::neutral,
     .when = "Ждал реакции (тапнул в ответ — тишина), сняли с зарядки раньше времени.",
     .when_en = "Expected a reaction (tapped back, silence), unplugged before fully charged."},
    {.id = "lonely",
     .name = "Одиночество",
     .name_en = "Lonely",
     .cat = Category::Negative,
     .eyes = both(ring(24, 3).pupil(0, 4, 3).lid(0.25f, -20)),
     .mouth = line(8),
     .lay = layout(46, 30, 47),
     .gaze = Gaze::Avert,
     .blink = Blink::Slow,
     .accent = Accent::Look,
     .accent_ms = 6000,
     .when = "Несколько часов без движения и внимания при свете.",
     .when_en = "Several hours without movement or attention in the light."},
    {.id = "hurt",
     .name = "Ой, больно",
     .name_en = "Ouch",
     .cat = Category::Negative,
     .eyes = both(chevron(22, 18, 4)),
     .brows = brows(kSadBrow),
     .mouth = wavy(16, 1.5f),
     .overlays = ov(O::Sweat),
     .motion = Motion::Tremble,
     .motion_amp = 1,
     .motion_hz = 12,
     .blink = Blink::None,
     .accent = Accent::None,
     .hold_ms = 1800,
     .next = Expr::sad,
     .when = "Удар, падение на пол, резкий толчок.",
     .when_en = "A hit, a fall to the floor, a sharp jolt."},
    {.id = "angry",
     .name = "Злость",
     .name_en = "Angry",
     .cat = Category::Negative,
     .eyes = both(ring(30, 4).pupil(-1, 1, 4).lid(0.35f, 24)),
     .brows = brows(kAngryBrow),
     .mouth = smile(16, -3),
     .overlays = ov(O::Vein),
     .gaze = Gaze::Still,
     .blink = Blink::Rare,
     .accent = Accent::Shake,
     .accent_ms = 3000,
     .hold_ms = 5000,
     .next = Expr::annoyed,
     .when = "Долго трясли, много тапов подряд после «раздражения».",
     .when_en = "Shaken for a long time, many taps in a row after “annoyed”."},
    {.id = "furious",
     .name = "Ярость",
     .name_en = "Furious",
     .cat = Category::Negative,
     .eyes = both(filled(26, 24).lid(0.4f, 28)),
     .brows = brows(brow(20, -28, 0, 4).at(0, 1)),
     .mouth = teeth(22, 9),
     .overlays = ov(O::Vein, O::Steam),
     .motion = Motion::Tremble,
     .motion_amp = 1,
     .motion_hz = 15,
     .blink = Blink::None,
     .accent = Accent::None,
     .hold_ms = 4000,
     .next = Expr::angry,
     .when = "Продолжают трясти или тыкать, когда уже злится.",
     .when_en = "Still shaken or poked while already angry."},
    {.id = "annoyed",
     .name = "Раздражение",
     .name_en = "Annoyed",
     .cat = Category::Negative,
     .eyes = both(ring(30, 4).pupil(0, 0, 4).lid(0.5f, 0)),
     .mouth = line(14).skew(2),
     .gaze = Gaze::Left,
     .blink = Blink::Rare,
     .accent = Accent::Twitch,
     .accent_ms = 3500,
     .hold_ms = 5000,
     .next = Expr::neutral,
     .when = "Третий-четвёртый тап подряд, будят ночью, мешают спать.",
     .when_en = "Third or fourth tap in a row, woken at night, kept from sleeping."},
    {.id = "grumpy",
     .name = "Ворчание",
     .name_en = "Grumpy",
     .cat = Category::Negative,
     .eyes = both(ring(28, 4).pupil(0, 2, 4).lid(0.4f, 12)),
     .brows = brows(brow(16, -12, 0)),
     .mouth = smile(16, -5),
     .gaze = Gaze::Down,
     .blink = Blink::Slow,
     .accent = Accent::Squint,
     .accent_ms = 4500,
     .when = "Разбудили раньше времени, холодное утро, плохое настроение.",
     .when_en = "Woken too early, a cold morning, a bad mood."},
    {.id = "disgusted",
     .name = "Отвращение",
     .name_en = "Disgusted",
     .cat = Category::Negative,
     .eyes = pair(ring(30, 4).pupil(0, 0, 4).lid(0.38f, 10).low(0.22f, 0.2f), ring(30, 4).pupil(0, 0, 4).lid(0.2f, 6)),
     .brows = brows(brow(16, -16, 0), brow(16, -6, 0)),
     .mouth = wavy(16, 2).skew(2),
     .gaze = Gaze::Right,
     .accent = Accent::Shake,
     .accent_ms = 3000,
     .hold_ms = 3000,
     .next = Expr::neutral,
     .when = "Мокро, грязно, неприятный резкий шум, «фу».",
     .when_en = "Wet, dirty, an unpleasant harsh noise, “ew”."},
    {.id = "sulking",
     .name = "Обида",
     .name_en = "Sulking",
     .cat = Category::Negative,
     .eyes = both(ring(28, 4).pupil(0, 1, 4).lid(0.35f, -4)),
     .brows = brows(brow(14, -10, 0)),
     .mouth = smile(10, -3).at(-3, 0),
     .gaze = Gaze::Left,
     .blink = Blink::Rare,
     .accent = Accent::Look,
     .accent_ms = 4000,
     .hold_ms = 6000,
     .next = Expr::neutral,
     .when = "Долго не обращали внимания, а потом тапнули: «не разговариваю».",
     .when_en = "Ignored for a long time, then tapped: “not talking to you”."},
    {.id = "embarrassed",
     .name = "Смущение",
     .name_en = "Embarrassed",
     .cat = Category::Negative,
     .eyes = both(ring(28, 4).pupil(3, 3, 3)),
     .brows = brows(brow(12, 14, 0)),
     .mouth = wavy(14, 1.2f),
     .overlays = ov(O::BlushDither, O::Sweat),
     .gaze = Gaze::Avert,
     .blink = Blink::Often,
     .accent = Accent::Look,
     .accent_ms = 2500,
     .hold_ms = 3500,
     .next = Expr::neutral,
     .when = "Уронили при людях, перевернули вверх ногами, громко рассмеялись рядом.",
     .when_en = "Dropped in public, turned upside down, loud laughter nearby."},
    {.id = "guilty",
     .name = "Вина",
     .name_en = "Guilty",
     .cat = Category::Negative,
     .eyes = both(ring(26, 4).pupil(-2, 3, 4).lid(0.35f, -14)),
     .brows = brows(brow(14, 18, 0)),
     .mouth = wavy(12, 1),
     .overlays = ov(O::Sweat),
     .gaze = Gaze::Down,
     .accent = Accent::Look,
     .accent_ms = 3500,
     .hold_ms = 4000,
     .next = Expr::neutral,
     .when = "Разбудил ночью, разрядился «не вовремя», после ошибки.",
     .when_en = "Woke someone at night, ran out of battery at a bad time, after a mistake."},

    // ---------------- Удивление и страх ----------------
    {.id = "surprised",
     .name = "Удивление",
     .name_en = "Surprised",
     .cat = Category::Surprise,
     .eyes = both(ring(34, 5).pupil(2, -2, 4)),
     .brows = brows(brow(16, 0, 3).at(0, 4)),
     .mouth = o_mouth(10, 10, 3),
     .lay = layout(56, 29, 51),
     .blink = Blink::Rare,
     .accent = Accent::Brows,
     .accent_ms = 1800,
     .in_ms = 140,
     .hold_ms = 2200,
     .next = Expr::curious,
     .when = "Неожиданный тап, внезапный звук средней громкости, кто-то взял в руки.",
     .when_en = "An unexpected tap, a sudden medium-loud sound, someone picked it up."},
    {.id = "shocked",
     .name = "Шок",
     .name_en = "Shocked",
     .cat = Category::Surprise,
     .eyes = both(ring(32, 4).pupil(0, 0, 2)),
     .brows = brows(brow(18, 6, 3).at(0, 2)),
     .mouth = o_mouth(12, 13, 3),
     .lay = layout(56, 29, 50),
          .blink = Blink::None,
     .accent = Accent::Pulse,
     .accent_ms = 2000,
     .in_ms = 120,
     .hold_ms = 2500,
     .next = Expr::scared,
     .when = "Очень громкий хлопок, сильный удар, падение с высоты.",
     .when_en = "A very loud bang, a hard hit, a fall from a height."},
    {.id = "amazed",
     .name = "Изумление",
     .name_en = "Amazed",
     .cat = Category::Surprise,
     .eyes = both(filled(28, 30).glint(4, -6, 5).glint2(-5, 5, 2)),
     .mouth = o_mouth(10, 11, 3),
     .overlays = ov(O::Sparkles),
     .gaze = Gaze::Still,
     .accent = Accent::Glint,
     .accent_ms = 1800,
     .hold_ms = 3500,
     .next = Expr::happy,
     .when = "Красивое: яркий свет после темноты, музыка, новое место.",
     .when_en = "Something beautiful: bright light after darkness, music, a new place."},
    {.id = "scared",
     .name = "Страх",
     .name_en = "Scared",
     .cat = Category::Surprise,
     .eyes = both(ring(32, 4).pupil(0, 0, 3)),
     .brows = brows(kWorryBrow),
     .mouth = wavy(18, 2),
     .overlays = ov(O::Sweat),
     .motion = Motion::Tremble,
     .motion_amp = 1,
     .motion_hz = 14,
     .gaze = Gaze::Dart,
     .blink = Blink::Often,
     .accent = Accent::None,
     .hold_ms = 3500,
     .next = Expr::worried,
     .when = "Свободное падение, резкая темнота, громкий звук ночью.",
     .when_en = "Free fall, sudden darkness, a loud sound at night."},
    {.id = "terrified",
     .name = "Ужас",
     .name_en = "Terrified",
     .cat = Category::Surprise,
     .eyes = both(ring(34, 3).pupil(0, 0, 2)),
     .brows = brows(brow(18, 24, 0).at(0, 2)),
     .mouth = shout(18, 12),
     .lay = layout(56, 27, 51),
     .overlays = ov(O::Rays, O::Sweat),
     .motion = Motion::Tremble,
     .motion_amp = 1,
     .motion_hz = 18,
     .gaze = Gaze::Still,
     .blink = Blink::None,
     .accent = Accent::None,
     .in_ms = 100,
     .hold_ms = 2500,
     .next = Expr::scared,
     .when = "Падение с большой высоты, очень сильная тряска.",
     .when_en = "A fall from a great height, very hard shaking."},
    {.id = "nervous",
     .name = "Нервы",
     .name_en = "Nervous",
     .cat = Category::Surprise,
     .eyes = both(ring(28, 4).pupil(0, 0, 4)),
     .mouth = teeth(18, 7),
     .overlays = ov(O::Sweat),
     .gaze = Gaze::Dart,
     .blink = Blink::Often,
     .accent = Accent::Twitch,
     .accent_ms = 2500,
     .when = "Мало заряда, шумно и тесно, долго в темноте сумки.",
     .when_en = "Low battery, noisy and crowded, a long time in a dark bag."},
    {.id = "worried",
     .name = "Тревога",
     .name_en = "Worried",
     .cat = Category::Surprise,
     .eyes = both(ring(30, 4).pupil(0, 1, 4).lid(0.15f, -16)),
     .brows = brows(kWorryBrow),
     .mouth = wavy(14, 1.2f),
     .blink = Blink::Often,
     .accent = Accent::Brows,
     .accent_ms = 3000,
     .when = "После испуга, заряд подходит к концу, что-то пошло не так.",
     .when_en = "After a scare, battery running out, something went wrong."},
    {.id = "startled",
     .name = "Испуг",
     .name_en = "Startled",
     .cat = Category::Surprise,
     .eyes = both(ring(36, 4).pupil(0, 0, 3)),
     .brows = brows(brow(18, 4, 2).at(0, 2)),
     .mouth = o_mouth(8, 8, 3),
     .lay = layout(56, 28, 51),
     .overlays = ov(O::Exclaim, O::Rays),
     .blink = Blink::None,
     .accent = Accent::None,
     .in_ms = 80,
     .hold_ms = 1200,
     .next = Expr::surprised,
     .when = "Резкий толчок или громкий звук — мгновенная реакция.",
     .when_en = "A sharp jolt or a loud sound: an instant reaction."},

    // ---------------- Мысли и внимание ----------------
    {.id = "curious",
     .name = "Любопытство",
     .name_en = "Curious",
     .cat = Category::Cognitive,
     .eyes = pair(ring(30, 4).pupil(4, -3, 4), ring(32, 4).pupil(4, -3, 4)),
     .brows = brows(brow(14, -4, 0), brow(16, 8, 2).at(0, 5)),
     .mouth = smile(10, 1).at(4, 0),
     .lay = layout(54, 27, 49, 3),
     .gaze = Gaze::Around,
     .accent = Accent::Tilt,
     .accent_ms = 2500,
     .hold_ms = 5000,
     .next = Expr::neutral,
     .when = "Новое место, незнакомый звук, после удивления.",
     .when_en = "A new place, an unfamiliar sound, after a surprise."},
    {.id = "confused",
     .name = "Недоумение",
     .name_en = "Confused",
     .cat = Category::Cognitive,
     .eyes = pair(ring(30, 4).pupil(2, 0, 4), ring(26, 4).pupil(2, 0, 3)),
     .brows = brows(brow(14, 12, 0), brow(14, -10, 0)),
     .mouth = wavy(14, 1.5f),
     .lay = layout(54, 27, 49, 4),
     .overlays = ov(O::Question),
     .accent = Accent::Tilt,
     .accent_ms = 2500,
     .hold_ms = 4000,
     .next = Expr::neutral,
     .when = "Перевернули вверх ногами, странная последовательность тапов.",
     .when_en = "Turned upside down, a strange sequence of taps."},
    {.id = "thinking",
     .name = "Раздумье",
     .name_en = "Thinking",
     .cat = Category::Cognitive,
     .eyes = both(ring(30, 4).pupil(0, 0, 4).lid(0.2f, 0)),
     .brows = brows(brow(14, -4, 0), brow(14, 8, 1)),
     .mouth = line(10).at(6, 0).skew(-2),
     .overlays = ov(O::Ellipsis),
     .gaze = Gaze::UpSide,
     .accent = Accent::Brows,
     .accent_ms = 3500,
     .when = "Пауза между событиями, «решает», что делать дальше.",
     .when_en = "A pause between events, “deciding” what to do next."},
    {.id = "idea",
     .name = "Идея!",
     .name_en = "Idea!",
     .cat = Category::Cognitive,
     .eyes = both(ring(32, 4).pupil(0, -4, 5)),
     .brows = brows(brow(16, 4, 2)),
     .mouth = open(16, 2, 5),
     .lay = layout(56, 29, 49),
     .overlays = ov(O::Bulb),
     .motion = Motion::Bounce,
     .motion_amp = 2,
     .motion_hz = 2,
     .accent = Accent::None,
     .hold_ms = 2200,
     .next = Expr::happy,
     .when = "После «раздумья»; придумал игру; пасхалка.",
     .when_en = "After “thinking”; came up with a game; an easter egg."},
    {.id = "focused",
     .name = "Сосредоточенность",
     .name_en = "Focused",
     .cat = Category::Cognitive,
     .eyes = both(ring(30, 4).pupil(0, 0, 5).lid(0.35f, 6).low(0.15f, 0)),
     .brows = brows(brow(16, -6, 0)),
     .mouth = line(10),
     .gaze = Gaze::Still,
     .blink = Blink::Rare,
     .accent = Accent::Squint,
     .accent_ms = 4000,
     .when = "Внимательно слушает, «смотрит» на что-то, ровная ходьба.",
     .when_en = "Listening closely, “looking” at something, steady walking."},
    {.id = "skeptical",
     .name = "Скепсис",
     .name_en = "Skeptical",
     .cat = Category::Cognitive,
     .eyes = pair(ring(30, 4).pupil(0, 0, 4).lid(0.45f, 0), ring(30, 4).pupil(0, 0, 4).lid(0.1f, 0)),
     .brows = brows(brow(14, -6, 0), brow(16, 10, 2).at(0, 5)),
     .mouth = line(14).skew(3),
     .gaze = Gaze::Still,
     .accent = Accent::Brows,
     .accent_ms = 3000,
     .hold_ms = 4000,
     .next = Expr::neutral,
     .when = "«Да ну?» — после странного действия, повторного тапа.",
     .when_en = "“Oh really?”: after a strange action or a repeated tap."},
    {.id = "suspicious",
     .name = "Подозрение",
     .name_en = "Suspicious",
     .cat = Category::Cognitive,
     .eyes = both(ring(30, 4).pupil(5, 0, 4).lid(0.5f, 6).low(0.2f, 0)),
     .mouth = line(12).skew(-2),
     .gaze = Gaze::Right,
     .blink = Blink::Rare,
     .accent = Accent::Look,
     .accent_ms = 3000,
     .hold_ms = 4000,
     .next = Expr::neutral,
     .when = "«¬_¬»: подкрадываются, тихо трогают, странный звук.",
     .when_en = "“¬_¬”: someone is sneaking up, a quiet touch, a strange sound."},
    {.id = "listening",
     .name = "Слушает",
     .name_en = "Listening",
     .cat = Category::Cognitive,
     .eyes = both(ring(30, 4).pupil(0, -2, 4)),
     .mouth = line(10),
     .lay = layout(54, 27, 49, 2),
     .overlays = ov(O::SoundWaves),
     .gaze = Gaze::Still,
     .accent = Accent::Tilt,
     .accent_ms = 3000,
     .when = "Рядом речь или ровный звук.",
     .when_en = "Speech or a steady sound nearby."},
    {.id = "mischievous",
     .name = "Хитрость",
     .name_en = "Mischievous",
     .cat = Category::Cognitive,
     .eyes = both(ring(30, 4).pupil(5, 2, 4).lid(0.42f, 10)),
     .brows = brows(brow(16, -12, 0)),
     .mouth = smile(22, 5).skew(-3),
     .gaze = Gaze::Right,
     .blink = Blink::Rare,
     .accent = Accent::Grin,
     .accent_ms = 3000,
     .hold_ms = 4000,
     .next = Expr::happy,
     .when = "Задумал шалость, перед «пасхалкой», после смеха.",
     .when_en = "Planning a prank, before an “easter egg”, after laughing."},
    {.id = "determined",
     .name = "Решимость",
     .name_en = "Determined",
     .cat = Category::Cognitive,
     .eyes = both(filled(26, 26).lid(0.3f, 14).glint(3, -4, 3)),
     .brows = brows(brow(18, -14, 0, 4)),
     .mouth = line(14),
     .gaze = Gaze::Still,
     .blink = Blink::Rare,
     .accent = Accent::Nod,
     .accent_ms = 3500,
     .when = "Быстрая ходьба, подъём по лестнице, «вперёд!».",
     .when_en = "Fast walking, climbing stairs, “let's go!”."},
    {.id = "daydreaming",
     .name = "Мечты",
     .name_en = "Daydreaming",
     .cat = Category::Cognitive,
     .eyes = both(ring(30, 4).pupil(0, -4, 4).lid(0.25f, 0, 0.2f)),
     .mouth = smile(12, 2),
     .motion = Motion::Float,
     .motion_amp = 2,
     .motion_hz = 0.25f,
     .gaze = Gaze::Up,
     .blink = Blink::Slow,
     .accent = Accent::None,
     .when = "Долго спокойно, мягкий свет, вечер.",
     .when_en = "Calm for a long time, soft light, evening."},
    {.id = "processing",
     .name = "Загрузка",
     .name_en = "Processing",
     .cat = Category::Cognitive,
     .eyes = both(filled(10, 10)),
     .mouth = line(10),
     .overlays = ov(O::Ellipsis),
     .gaze = Gaze::Around,
     .blink = Blink::Rare,
     .accent = Accent::Wiggle,
     .accent_ms = 1500,
     .when = "Включение, обновление прошивки, подключение к телефону.",
     .when_en = "Power on, firmware update, connecting to a phone."},

    // ---------------- Общение ----------------
    {.id = "hello",
     .name = "Привет!",
     .name_en = "Hello!",
     .cat = Category::Social,
     .eyes = both(arc_up(28, 14, 4)),
     .mouth = open(20, 2, 7),
     .overlays = ov(O::Sparkles),
     .motion = Motion::Bounce,
     .motion_amp = 2,
     .motion_hz = 2.5f,
     .blink = Blink::None,
     .accent = Accent::None,
     .hold_ms = 2500,
     .next = Expr::happy,
     .when = "Взяли в руки после перерыва, включение, утро.",
     .when_en = "Picked up after a break, power on, morning."},
    {.id = "goodbye",
     .name = "Пока!",
     .name_en = "Bye!",
     .cat = Category::Social,
     .eyes = both(arc_up(26, 12, 4)),
     .mouth = smile(16, 4),
     .motion = Motion::Sway,
     .motion_amp = 2,
     .motion_hz = 0.8f,
     .blink = Blink::None,
     .accent = Accent::None,
     .hold_ms = 2500,
     .next = Expr::sleepy,
     .when = "Выключение кнопкой, уход в сон.",
     .when_en = "Turned off with the button, going to sleep."},
    {.id = "pleading",
     .name = "Ну пожалуйста",
     .name_en = "Pretty please",
     .cat = Category::Social,
     .eyes = both(filled(30, 32).glint(5, -7, 6).glint2(-5, 6, 3)),
     .brows = brows(brow(14, 20, 1).at(0, 3)),
     .mouth = smile(8, -2),
     .lay = layout(56, 28, 51),
     .gaze = Gaze::Still,
     .accent = Accent::Glint,
     .accent_ms = 1800,
     .when = "Голоден (низкий заряд), просит внимания после долгого одиночества.",
     .when_en = "Hungry (low battery), begging for attention after long loneliness."},
    {.id = "shy",
     .name = "Стеснение",
     .name_en = "Shy",
     .cat = Category::Social,
     .eyes = both(ring(28, 4).pupil(2, 3, 4).low(0.25f, 0.5f)),
     .mouth = smile(10, 2),
     .overlays = ov(O::BlushLines),
     .gaze = Gaze::Avert,
     .blink = Blink::Often,
     .accent = Accent::Look,
     .accent_ms = 3000,
     .hold_ms = 4000,
     .next = Expr::happy,
     .when = "Нежное внимание, комплимент (ласковые тапы), знакомство.",
     .when_en = "Gentle attention, a compliment (soft taps), meeting someone new."},
    {.id = "smug",
     .name = "Самодовольство",
     .name_en = "Smug",
     .cat = Category::Social,
     .eyes = both(ring(30, 4).pupil(4, 1, 4).lid(0.5f, -4)),
     .brows = brows(brow(14, -4, 0), brow(14, 10, 1)),
     .mouth = smile(16, 3).skew(-4),
     .gaze = Gaze::Right,
     .blink = Blink::Rare,
     .accent = Accent::Brows,
     .accent_ms = 3000,
     .hold_ms = 4000,
     .next = Expr::neutral,
     .when = "После «победы»: дождался зарядки, угадал, пережил тряску.",
     .when_en = "After a “win”: got its charge, guessed right, survived the shaking."},
    {.id = "innocent",
     .name = "Невинность",
     .name_en = "Innocent",
     .cat = Category::Social,
     .eyes = both(arc_up(26, 12, 4)),
     .mouth = smile(12, 3),
     .overlays = ov(O::Halo),
     .motion = Motion::Bob,
     .motion_amp = 1,
     .motion_hz = 0.5f,
     .blink = Blink::None,
     .accent = Accent::None,
     .hold_ms = 4000,
     .next = Expr::happy,
     .when = "«Это не я»: после шалости, после того как его уронили.",
     .when_en = "“It wasn't me”: after a prank, after being dropped."},
    {.id = "devilish",
     .name = "Чертёнок",
     .name_en = "Little devil",
     .cat = Category::Social,
     .eyes = both(ring(26, 4).pupil(2, 2, 4).lid(0.36f, 18)),
     .brows = brows(brow(18, -18, 0)),
     .mouth = open(22, 4, 4),
     .lay = layout(54, 29, 47),
     .overlays = ov(O::Horns),
     .blink = Blink::Rare,
     .accent = Accent::Grin,
     .accent_ms = 2500,
     .hold_ms = 4000,
     .next = Expr::mischievous,
     .when = "Пасхалка, ночная шалость, ответ на тройной тап.",
     .when_en = "An easter egg, a night-time prank, reply to a triple tap."},
    {.id = "apologetic",
     .name = "Извинение",
     .name_en = "Apologetic",
     .cat = Category::Social,
     .eyes = both(ring(28, 4).pupil(0, 2, 4).lid(0.2f, -18)),
     .brows = brows(kWorryBrow),
     .mouth = wavy(12, 1),
     .overlays = ov(O::Sweat),
     .motion = Motion::Nod,
     .motion_amp = 2,
     .motion_hz = 0.7f,
     .gaze = Gaze::Down,
     .accent = Accent::None,
     .hold_ms = 3000,
     .next = Expr::neutral,
     .when = "Пропустил событие, разрядился, «прости».",
     .when_en = "Missed an event, ran out of battery, “sorry”."},

    // ---------------- Состояния ----------------
    {.id = "sleepy",
     .name = "Сонливость",
     .name_en = "Sleepy",
     .cat = Category::State,
     .eyes = both(ring(30, 4).pupil(0, 3, 4).lid(0.62f, 0, -0.1f)),
     .mouth = line(10),
     .gaze = Gaze::Down,
     .blink = Blink::Slow,
     .accent = Accent::Breath,
     .accent_ms = 4500,
     .when = "Вечер, полумрак, долго без движения.",
     .when_en = "Evening, dim light, no movement for a long time."},
    {.id = "sleeping",
     .name = "Сон",
     .name_en = "Asleep",
     .cat = Category::State,
     .eyes = both(arc_down(26, 8, 3)),
     .mouth = o_mouth(6, 5, 2),
     .overlays = ov(O::Zzz),
     .motion = Motion::Bob,
     .motion_amp = 1,
     .motion_hz = 0.25f,
     .gaze = Gaze::Still,
     .blink = Blink::None,
     .accent = Accent::None,
     .in_ms = 900,
     .when = "Ночь, темнота, долгое бездействие (перед выключением экрана).",
     .when_en = "Night, darkness, long inactivity (before the screen turns off)."},
    {.id = "waking",
     .name = "Пробуждение",
     .name_en = "Waking up",
     .cat = Category::State,
     .eyes = both(ring(30, 4).pupil(0, 1, 4).lid(0.45f, 0)),
     .mouth = o_mouth(8, 8, 2.5f),
     .gaze = Gaze::Around,
     .blink = Blink::Often,
     .accent = Accent::Squint,
     .accent_ms = 1500,
     .in_ms = 700,
     .hold_ms = 2200,
     .next = Expr::neutral,
     .when = "Стало светло, взяли в руки, утро.",
     .when_en = "It got light, picked up, morning."},
    {.id = "bored",
     .name = "Скука",
     .name_en = "Bored",
     .cat = Category::State,
     .eyes = both(ring(30, 4).pupil(0, 0, 4).lid(0.55f, 0)),
     .mouth = line(14).skew(1),
     .overlays = ov(O::Ellipsis),
     .gaze = Gaze::Around,
     .blink = Blink::Slow,
     .accent = Accent::Breath,
     .accent_ms = 4000,
     .when = "10+ минут ничего не происходит при свете.",
     .when_en = "Nothing has happened for 10+ minutes in the light."},
    {.id = "tired",
     .name = "Усталость",
     .name_en = "Tired",
     .cat = Category::State,
     .eyes = both(ring(30, 4).pupil(0, 3, 4).lid(0.5f, -10)),
     .mouth = line(10),
     .overlays = ov(O::Sweat),
     .gaze = Gaze::Down,
     .blink = Blink::Slow,
     .accent = Accent::Breath,
     .accent_ms = 5000,
     .when = "Долгая прогулка, много тряски, поздний вечер.",
     .when_en = "A long walk, lots of shaking, late evening."},
    {.id = "exhausted",
     .name = "Изнеможение",
     .name_en = "Exhausted",
     .cat = Category::State,
     .eyes = both(ring(30, 3).pupil(0, 3, 3).lid(0.7f, -6)),
     .mouth = open(12, -2, 3),
     .overlays = ov(O::Sweat),
     .gaze = Gaze::Down,
     .blink = Blink::Slow,
     .accent = Accent::Breath,
     .accent_ms = 3000,
     .when = "Бег, очень долгая тряска, заряд почти на нуле.",
     .when_en = "Running, very long shaking, battery almost empty."},
    {.id = "dizzy",
     .name = "Головокружение",
     .name_en = "Dizzy",
     .cat = Category::State,
     .eyes = both(spiral(28, 2)),
     .mouth = wavy(18, 2),
     .overlays = ov(O::DizzyStars),
     .motion = Motion::Wobble,
     .motion_amp = 3,
     .motion_hz = 0.7f,
     .blink = Blink::None,
     .accent = Accent::None,
     .hold_ms = 4000,
     .next = Expr::tired,
     .when = "Сильно и долго трясли, крутили.",
     .when_en = "Shaken hard and long, spun around."},
    {.id = "knocked_out",
     .name = "Нокаут",
     .name_en = "Knocked out",
     .cat = Category::State,
     .eyes = both(cross(22, 20, 4)),
     .mouth = open(14, 0, 6),
     .overlays = ov(O::DizzyStars),
     .blink = Blink::None,
     .accent = Accent::None,
     .in_ms = 120,
     .hold_ms = 3500,
     .next = Expr::dizzy,
     .when = "Падение на твёрдое, удар после свободного падения.",
     .when_en = "A fall onto something hard, a hit after free fall."},
    {.id = "hungry",
     .name = "Голод",
     .name_en = "Hungry",
     .cat = Category::State,
     .eyes = both(ring(30, 4).pupil(0, -4, 5)),
     .mouth = open(14, 0, 4),
     .overlays = ov(O::Drool),
     .gaze = Gaze::Up,
     .accent = Accent::Chatter,
     .accent_ms = 2500,
     .when = "Заряд 15 % и ниже: «хочу кушать», чередуется с «мало заряда».",
     .when_en = "Battery at 15% or below: “I want to eat”, alternates with “low battery”."},
    {.id = "cold",
     .name = "Холодно",
     .name_en = "Cold",
     .cat = Category::State,
     .eyes = both(ring(26, 4).pupil(0, 1, 4).lid(0.25f, -8)),
     .mouth = teeth(16, 6),
     .overlays = ov(O::Snow),
     .motion = Motion::Shiver,
     .motion_amp = 1,
     .motion_hz = 12,
     .accent = Accent::None,
     .when = "Датчик температуры: ниже +5 °C.",
     .when_en = "Temperature sensor: below +5 °C."},
    {.id = "hot",
     .name = "Жарко",
     .name_en = "Hot",
     .cat = Category::State,
     .eyes = both(ring(28, 4).pupil(0, 2, 4).lid(0.45f, -6)),
     .mouth = tongue(16, 1, 6),
     .overlays = ov(O::Sweat),
     .blink = Blink::Slow,
     .accent = Accent::Breath,
     .accent_ms = 2500,
     .when = "Датчик температуры: выше +38 °C, лежит на солнце.",
     .when_en = "Temperature sensor: above +38 °C, lying in the sun."},
    {.id = "sick",
     .name = "Недомогание",
     .name_en = "Unwell",
     .cat = Category::State,
     .eyes = both(ring(26, 4).pupil(0, 2, 3).lid(0.4f, -12)),
     .brows = brows(brow(14, 14, 0)),
     .mouth = wavy(16, 1.8f),
     .overlays = ov(O::Sweat),
     .motion = Motion::Wobble,
     .motion_amp = 1,
     .motion_hz = 0.35f,
     .blink = Blink::Slow,
     .accent = Accent::None,
     .when = "Перегрев, сбой датчика, долгая тряска в транспорте.",
     .when_en = "Overheating, a sensor fault, long shaking in a vehicle."},
    {.id = "dazzled",
     .name = "Ослеплён",
     .name_en = "Dazzled",
     .cat = Category::State,
     .eyes = both(chevron(22, 16, 4)),
     .mouth = smile(12, -2),
     .overlays = ov(O::Rays),
     .blink = Blink::None,
     .accent = Accent::Squint,
     .accent_ms = 1500,
     .in_ms = 120,
     .hold_ms = 2000,
     .next = Expr::neutral,
     .when = "Резко стало очень ярко: вынули из сумки на солнце.",
     .when_en = "Suddenly very bright: taken out of a bag into the sun."},
    {.id = "afraid_dark",
     .name = "Боится темноты",
     .name_en = "Afraid of the dark",
     .cat = Category::State,
     .eyes = both(ring(32, 4).pupil(0, 0, 3)),
     .mouth = wavy(14, 1.5f),
     .motion = Motion::Tremble,
     .motion_amp = 1,
     .motion_hz = 10,
     .gaze = Gaze::Dart,
     .blink = Blink::Often,
     .accent = Accent::None,
     .hold_ms = 3000,
     .next = Expr::sleepy,
     .when = "Внезапно стало темно (положили в сумку) — перед засыпанием.",
     .when_en = "Suddenly dark (put in a bag), right before falling asleep."},

    // ---------------- Система ----------------
    {.id = "charging",
     .name = "Зарядка",
     .name_en = "Charging",
     .cat = Category::System,
     .eyes = both(arc_up(26, 12, 4)),
     .mouth = cat(14, 4),
     .overlays = ov(O::Bolt),
     .motion = Motion::Nod,
     .motion_amp = 1,
     .motion_hz = 1.6f,
     .blink = Blink::None,
     .accent = Accent::None,
     .when = "Подключили USB: «кушает».",
     .when_en = "USB plugged in: “eating”."},
    {.id = "charged",
     .name = "Заряжен",
     .name_en = "Charged",
     .cat = Category::System,
     .eyes = both(ring(30, 4).pupil(3, -3, 5)),
     .mouth = open(20, 2, 7),
     .overlays = ov(O::Sparkles),
     .accent = Accent::Glint,
     .accent_ms = 2000,
     .hold_ms = 3000,
     .next = Expr::content,
     .when = "Зарядка завершена.",
     .when_en = "Charging complete."},
    {.id = "low_battery",
     .name = "Мало заряда",
     .name_en = "Low battery",
     .cat = Category::System,
     .eyes = both(ring(30, 4).pupil(0, 3, 4).lid(0.5f, -10)),
     .mouth = smile(12, -3),
     .overlays = ov(O::BatteryLow),
     .gaze = Gaze::Down,
     .blink = Blink::Slow,
     .accent = Accent::Breath,
     .accent_ms = 5000,
     .when = "Заряд 15 % и ниже, чередуется с «хочу кушать».",
     .when_en = "Battery at 15% or below, alternates with “I want to eat”."},
    {.id = "critical_battery",
     .name = "Почти разряжен",
     .name_en = "Almost empty",
     .cat = Category::System,
     .eyes = both(ring(28, 3).pupil(0, 3, 3).lid(0.72f, -8)),
     .mouth = line(8),
     .overlays = ov(O::BatteryLow, O::Sweat),
     .gaze = Gaze::Down,
     .blink = Blink::Slow,
     .accent = Accent::Breath,
     .accent_ms = 6000,
     .when = "Заряд 5 % и ниже; когда ячейка опустеет, брелок сохранит всё и выключится.",
     .when_en = "Battery at 5% or below; when the cell runs dry, the keychain saves everything and turns off."},
    {.id = "error",
     .name = "Сбой",
     .name_en = "Error",
     .cat = Category::System,
     .eyes = both(filled(20, 20, 3)),
     .mouth = wavy(16, 2),
     .overlays = ov(O::Exclaim),
     .gaze = Gaze::Still,
     .blink = Blink::None,
     .accent = Accent::Twitch,
     .accent_ms = 1500,
     .hold_ms = 3000,
     .next = Expr::confused,
     .when = "Ошибка датчика или экрана, неудачное обновление.",
     .when_en = "A sensor or screen fault, a failed update."},

    // ---------------- Веселье ----------------
    {.id = "music",
     .name = "Музыка",
     .name_en = "Music",
     .cat = Category::Fun,
     .eyes = both(arc_up(26, 12, 4)),
     .mouth = smile(14, 3),
     .overlays = ov(O::Notes),
     .motion = Motion::Nod,
     .motion_amp = 2,
     .motion_hz = 2,
     .blink = Blink::None,
     .accent = Accent::None,
     .when = "Микрофон слышит ритм: качается в такт.",
     .when_en = "The microphone hears a beat: sways in time."},
    {.id = "singing",
     .name = "Поёт",
     .name_en = "Singing",
     .cat = Category::Fun,
     .eyes = both(arc_down(26, 9, 4)),
     .mouth = o_mouth(10, 12, 3),
     .overlays = ov(O::Notes),
     .motion = Motion::Sway,
     .motion_amp = 2,
     .motion_hz = 0.8f,
     .blink = Blink::None,
     .accent = Accent::Chatter,
     .accent_ms = 1800,
     .hold_ms = 5000,
     .next = Expr::happy,
     .when = "Хорошее настроение и тишина: напевает сам себе.",
     .when_en = "Good mood and silence: humming to itself."},
    {.id = "cool",
     .name = "Крутой",
     .name_en = "Cool",
     .cat = Category::Fun,
     .eyes = both(kRing),
     .mouth = smile(16, 2).skew(-3),
     .overlays = ov(O::Shades),
     .gaze = Gaze::Still,
     .blink = Blink::None,
     .accent = Accent::Nod,
     .accent_ms = 3000,
     .hold_ms = 5000,
     .next = Expr::smug,
     .when = "Яркое солнце, быстрая езда, пасхалка.",
     .when_en = "Bright sun, a fast ride, an easter egg."},
    {.id = "uwu",
     .name = "UwU",
     .name_en = "UwU",
     .cat = Category::Fun,
     .eyes = both(arc_down(24, 10, 4)),
     .mouth = cat(14, 4),
     .overlays = ov(O::BlushDither),
     .blink = Blink::None,
     .accent = Accent::Bob,
     .accent_ms = 3000,
     .hold_ms = 4000,
     .next = Expr::adoring,
     .when = "Нежные поглаживания, милота.",
     .when_en = "Gentle petting, cuteness."},
    {.id = "owo",
     .name = "OwO",
     .name_en = "OwO",
     .cat = Category::Fun,
     .eyes = both(ring(30, 4)),
     .mouth = cat(14, 4),
     .overlays = ov(O::BlushLines),
     .gaze = Gaze::Still,
     .accent = Accent::Pulse,
     .accent_ms = 2500,
     .hold_ms = 4000,
     .next = Expr::curious,
     .when = "«Что тут у нас?» — интерес плюс милота.",
     .when_en = "“What's this?”: interest plus cuteness."},
    {.id = "derp",
     .name = "Глупая рожица",
     .name_en = "Derp",
     .cat = Category::Fun,
     .eyes = pair(ring(34, 4).pupil(-6, 6, 4), ring(22, 4).pupil(4, -3, 3)),
     .mouth = tongue(18, 3, 6).skew(3),
     .lay = layout(54, 27, 50, 3),
     .blink = Blink::Rare,
     .accent = Accent::Wiggle,
     .accent_ms = 2000,
     .hold_ms = 3500,
     .next = Expr::giggle,
     .when = "После головокружения, редкая шутка.",
     .when_en = "After dizziness, a rare joke."},
    {.id = "robot",
     .name = "Робот",
     .name_en = "Robot",
     .cat = Category::Fun,
     .eyes = both(filled(30, 8, 2)),
     .mouth = line(20, 2),
     .gaze = Gaze::Dart,
     .blink = Blink::None,
     .accent = Accent::Look,
     .accent_ms = 2000,
     .hold_ms = 5000,
     .next = Expr::neutral,
     .when = "Пасхалка: «режим робота», сканирует окрестности.",
     .when_en = "Easter egg: “robot mode”, scanning the surroundings."},
    {.id = "party",
     .name = "Праздник",
     .name_en = "Party",
     .cat = Category::Fun,
     .eyes = both(star(30)),
     .mouth = open(22, 2, 9),
     .overlays = ov(O::Sparkles, O::Notes),
     .motion = Motion::Bounce,
     .motion_amp = 2,
     .motion_hz = 3,
     .blink = Blink::None,
     .accent = Accent::None,
     .hold_ms = 6000,
     .next = Expr::happy,
     .when = "День рождения, Новый год, особая дата.",
     .when_en = "Birthday, New Year, a special date."},
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
