olerast67/emotion-keychain/(commit log)

2026-10-23 Описание устройства и референсные картинки
2026-10-23 Движок лиц, симуляторы и оформление репозитория (#1)
    139 анимированных эмоций, поведение по ситуациям, симуляторы (facegen, facesim, веб на WebAssembly), документация по движку, железу, энергобюджету и плану, заготовки прошивки и плат, CI.
    Claude-Session: https://claude.ai/code/session_01RQ7GfaTDyVK1Dcdo3sKM8F
2026-10-23 Стенд на ESP32, безопасное поле от края, лицензия (#2)
    Прошивка стенда для ESP32-C5/ESP32/C3/S3 с SSD1306 и кнопкой, проверка прошивки на ПК, сборка файлов для прошивки из браузера в CI, безопасное поле от края и минимальная толщина линий, лицензия PolyForm Noncommercial и условия коммерческой лицензии.
    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
2026-10-23 Характеры, голос, достижения, своя плата rev B и корпус из акрила (#3)
    * Свой характер, рост и импланты, сцены-сюрпризы, киберпанк-тема
    - identity: характер и внешность из серийного номера чипа — 6 архетипов,
    посадка и размер глаз, зрачки, моргание, брови; 10% редких, 1%
    легендарных с золотым кибер-глазом; позывной вида K7-3F2A
    - progress: 44 эмоции на старте, 11 имплантов за опыт (дни, касания, шаги,
    встре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
    [case-acrylic-2mm.dxf, case-acrylic-3mm.dxf, case-acrylic-4mm.dxf, case-acrylic-5mm.dxf, keychain-rev-b-bom-jlcpcb.csv, keychain-rev-b-hand-assembly.csv, keychain-rev-b.kicad_pcb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]
2026-10-23 Экранировать $ в Markdown: $_$ ломал отображение README (#4)
    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
2026-10-24 Движок: встречи по BLE без соединения и обработка датчиков
    encounter.h — пакет рекламы, подтверждение встречи (дважды за минуту,
    сильнее −70 дБм), общий отсчёт до сцены, одинаковый у обоих брелоков исход
    дуэли и nonce разговора. sensing.h — акселерометр (тряска, падение, удар,
    шаги, покой, вверх ногами, наклон и рывок для взгляда), микрофон (хлопок,
    речь, музыка, тишина), свет, температура и батарея в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
2026-10-24 Прошивка платы rev B на nRF52840: датчики, голос, встречи по BLE, сон
    Своя плата (variants/keychain_revb, boards/keychain_revb.json) на ядре
    Adafruit nRF52 с SoftDevice S140: LIS3DH (FIFO, касания), LTR-303ALS,
    микрофон PDM, температура, батарея и зарядка, пищалка в противофазе на
    PWM3, вибро, реклама и прослушивание BLE для встреч и дуэлей, хранение во
    флеше, экран гаснет в кармане, выключение кнопкой, сторожевой таймер,
    REG0 = 3.3 В при первом запуске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
2026-10-24 Прошивка rev B: исправления после проверки по даташитам
    - загрузчик: кнопка включает режим прошивки только при USB и с
    таймаутом 10 с (патч к загрузчику Adafruit), иначе пробуждение кнопкой
    из сна на батарее оставляло брелок в загрузчике; перед сном ждём, пока
    кнопку отпустят;
    - статус зарядки без внутренней подтяжки (делитель 10 к / 13 к не давал
    низкого уровня), во сне ножка отключена;
    - сто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
    [board.h, hal.cpp, main.cpp, radio.cpp, sensors.cpp]
2026-10-24 Аудит прошивки rev B: защита встреч от подделок, датчики, флеш
    Встречи по BLE:
    - объявление сцены — только от соседа, услышанного вблизи; отсчёт не длиннее
    своего и не откладывается повторными пакетами;
    - дуэль только с согласия хозяина, одна в сутки на соседа, не больше 16;
    - уровень соседа проверяется; соседей в перерыве не вытесняют новые позывные;
    - Busy-режим эфира — только пока встреча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
2026-10-24 Прошивка rev B: питание — карман 0.63 → ~0.15 мА
    - кварц 64 МГц отпускается после PDM.begin: ядро его не отпускало, и он
    работал до выключения (~0.25 мА во всех режимах);
    - датчик света меряет разово (130 мс раз в 2 с, при выключенном экране
    раз в 5 с) вместо постоянного режима (~0.2 мА);
    - кадры при выключенном экране — не чаще раза в секунду;
    - FIFO акселерометра читается пачками по 10 выборок; в экорежиме опр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
2026-10-24 Прошивка rev B: независимый аудит — флеш, сбросы, время, USB, эфир
    - Флеш: свой журнал в трёх страницах 0xEA000–0xECFFF (их резервирует
    загрузчик, LittleFS берёт верхние 7). LittleFS ядра стирал страницу 4 КБ
    по шесть раз на сохранение файла (износ за 1–2 недели), а обрыв питания
    во время стирания уничтожал каталог и весь рост. Теперь запись
    дописывается без стирания (страница — раз в ~13 записей), прошл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
2026-10-24 Финальный аудит rev B: симуляция платы целиком и исправления по ней
    Симуляция (firmware/host/keychain, тест keychain_sim в CI): настоящая прошивка
    src/keychain собирается на ПК без изменений. Вместо ядра Adafruit — модели
    LIS3DH (FIFO, касания), LTR-303 (разовые замеры), SSD1306 за ключом питания,
    PDM, асинхронного флеша SoftDevice, сторожевого таймера, UICR, USB, зарядника,
    кнопки и батареи; две платы и эфир между ними. Каждая плата — пр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
    [Arduino.h, InternalFileSystem.h, PDM.h, Wire.h, behavior.cpp, bluefruit.h, board.cpp, encounter.cpp]
2026-10-24 Плата rev B: исправления перед заказом, разведена заново
    - «100k» в BOM был с номером LCSC C25086 — это не 100 кОм (у LCSC/JLCPCB
    1 Ом): на R6 закоротило бы VBUS, на R7/R9/R15 не работали бы экран и вибро.
    Теперь C25741 (0402WGF1003TCE, базовая).
    - R6 10 кОм: после отключения USB Q1 открывается за ~15 мс, а не ~130 мс
    (VSYS падал до 2.5 В), утечка горячего Шоттки не поднимает VBUS.
    - C11 между затвором и стоком Q2: бросок тока экрана ~0.14 А вместо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
    [keychain-rev-b-bom-jlcpcb.csv, keychain-rev-b.kicad_pcb, keychain-rev-b.kicad_sch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]
2026-10-24 Плата rev B: BOM и файл расстановки для PCBWay
    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
    [keychain-rev-b-bom-pcbway.csv, keychain-rev-b-centroid-pcbway.csv]
2026-10-27 Заводская прошивка одним файлом и правка трёх лиц после аудита анимаций
    - Сборка платы rev B кладёт рядом с firmware.uf2 файл firmware-factory.hex:
    загрузчик с SoftDevice, приложение и отметка загрузчику «приложение рабочее»
    (0xFF000 = 1). Его пишут программатором или отдают на завод — брелок сразу
    показывает лицо. Склейка своя, с проверкой пересечений; CI выкладывает файл
    в архив keychain-firmware.
    - «Тык!» (реакц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
2026-10-27 Плата rev B: повороты оборота в CPL по правилу JLCPCB, переходные 0.25/0.55, файлы PCBWay из fab.py
    - CPL: детали оборота теперь с отражённым углом (180 − θ) и потом поправкой корпуса,
    как в kicad-jlcpcb-tools и KiBot. Раньше угол шёл как в KiCad, и 12 полярных деталей
    оборота (Q1–Q4, U2, U3, U4, U6, D1, D2, LED1, J1) встали бы на 180° не так.
    U1: −90 → 270.
    - Переходные: отверстие 0.25 мм вместо 0.3 при той же площадке 0.55 — поясок 0.15 мм,
    норма PCBWay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
    [keychain-rev-b-bom-pcbway.csv, keychain-rev-b-centroid-pcbway.csv, keychain-rev-b.kicad_pcb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]
2026-10-27 Прошивка и встречи: исправления по предрелизному ревью
    Плата:
    - Вибро: в значении PWM2 не стоял бит 15 полярности — ключ был открыт 1 − 3/VSYS
    периода, и мотор на 3 В получал 0.4–1.7 В вместо 3. Теперь бит 15 = 1, как у
    analogWrite ядра. У пищалки полярности исправлены так же: в «мягком» режиме второй
    вывод теперь в нуле, а не всё время в единице.
    - Выключение на USB с залипшей кнопкой: ожидание отпускани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
    [board.cpp, encounter.cpp, encounter.h, engine.cpp, hal.cpp, hal.h, keychain_sim.cpp, main.cpp]
2026-10-27 Корпус: три версии S, M, L под ячейки 402025, 502025 и 602025
    Плата и прошивка те же. case.py пишет раскрой для каждой версии: проставки под экраном
    5, 6 и 7 мм, рамка вокруг ячейки 5, 6 или 4 + 3 мм, винты M2 × 20 или × 22. Версия S
    в out/, M и L — в out/m/ и out/l/. Рамки S пересобраны по текущей плате (после
    перекладки ячейки BT1 и R20 они устарели).
    README корпуса: таблица версий, что купить под каждую, длинная гребёнка экрана для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
    [case-acrylic-2mm.dxf, case-acrylic-3mm.dxf, case-acrylic-4mm.dxf, case-acrylic-5mm.dxf, case-acrylic-6mm.dxf]
2026-10-27 Черновик: исправления по полному предрелизному аудиту (в работе)
    Промежуточное состояние, пока идут трассировка платы и параллельные правки:
    - плата: SA0 акселерометра на VDD, C6 4.7 мкФ, C14/C15 100 нФ, перемычки экрана
    дальше от штырей, R3 на ножку CHG_EN (заряд по температуре), R20 47 кОм, TVS D3 и
    10 Ом к VBUS модуля, 100 Ом в линиях SWD, шире запретная зона антенны, без пасты
    на площадках проводов; расстано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
    [keychain-rev-b.kicad_pcb]
2026-10-27 Черновик: плата — R21, R22/R23 на обороте, доводка без переходных в площадках (в работе)
    - R21 (10 Ом к VBUS модуля) и R22/R23 (100 Ом в SWD) перенесены на оборот: на лицевой
    стороне они перекрывали проходы у нижнего ряда выводов модуля, и четыре цепи не
    разводились;
    - D3 повёрнут, чтобы не задевать зону стойки экрана; R8 — на прежнем месте;
    - доводка трассировки (fixroute.py) больше не ставит переходное отверс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
    [keychain-rev-b.kicad_pcb]
2026-10-27 Черновик: CHG_EN на P0.24 (внешняя площадка модуля), трассировка заново (в работе)
    На P0.23 (внутренняя площадка нижнего ряда) доводка не находила выхода к R3, и из-за
    этого не разводились CHG_EN и VIB_EN. P0.24 — внешняя площадка с зазором 1.6 мм.
    Прошивка ещё на P0.23 — поправлю вместе с остальными её правками.
    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
    [keychain-rev-b.kicad_pcb]
2026-10-27 Черновик: промежуточные правки исполнителей (в работе)
    Прошивка, симулятор, движок, корпус и документы — состояние на сейчас. Плата выбирается
    из двух вариантов разводки, файлы для завода ещё старые.
    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
    [keychain-rev-b.kicad_pcb]
2026-10-27 Черновик: плата rev B — итоговая трассировка (TVS D3, CHG_EN P0.24, 47k, C6 4.7 мкФ), выходные файлы заново (в работе)
    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
    [keychain-rev-b-bom-jlcpcb.csv, keychain-rev-b-bom-pcbway.csv, keychain-rev-b-centroid-pcbway.csv, keychain-rev-b.kicad_pcb, keychain-rev-b.kicad_sch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]
2026-10-27 Черновик: тайм-аут теста симулятора платы, уровень соседа в дуэли веб-симулятора, SWD без резисторов в README прошивки (в работе)
    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
2026-10-27 Черновик: промежуточные правки документации (в работе)
    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
2026-10-27 Черновик: промежуточные правки корпуса (в работе)
    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
2026-10-27 Черновик: съёмка кадров 3D-просмотра корпуса (в работе)
    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
2026-10-27 Черновик: корпус S/M/L на ушках рамок, документация сведена с итоговой платой и корпусом, картинка платы заново (в работе)
    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
    [case-acrylic-2mm.dxf, case-acrylic-3mm.dxf, case-acrylic-4mm.dxf, case-acrylic-5mm.dxf, case-acrylic-6mm.dxf, keychain-rev-b-hand-assembly.csv, keychain-rev-b.kicad_pcb, keychain-rev-b.kicad_sch]
2026-10-27 Черновик: исправления по независимой проверке — прошивка, движок, корпус, плата (в работе)
    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
    [behavior.cpp, behavior.h, encounter.cpp, encounter.h, progress.cpp, progress.h]
2026-10-27 Черновик: незаконченные правки исполнителей до перезапуска контейнера (в работе)
    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
    [case-acrylic-2mm.dxf, case-acrylic-4mm.dxf]
2026-10-27 Черновик: панель 2 платы для монтажа, защита генераторов, без пасты на DNP, зазор отверстий 0.5 мм, повороты CPL, шёлк 1 мм (в работе)
    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
    [keychain-rev-b-panel-bom-jlcpcb.csv, keychain-rev-b-panel-bom-pcbway.csv, keychain-rev-b-panel-centroid-pcbway.csv, keychain-rev-b-panel.kicad_pcb, keychain-rev-b.kicad_pcb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]
2026-10-27 Черновик: промежуточные правки прошивки и корпуса (в работе)
    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
2026-10-27 Черновик: прошивка и движок по независимой проверке (часы, заряд 10–42 °C, шина экрана, жест загрузчика, версия), корпус (толкатель, пищалка, мерные листы, M2×25), картинки заново (в работе)
    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
2026-10-27 Черновик: список extra_scripts в platformio.ini по строкам — иначе сборка брелока падала (в работе)
    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
2026-10-27 Документация по независимой проверке, памятка покупателю и список перед продажей; выключение кнопкой без «LOW BATTERY»; пороги в каталоге эмоций
    - docs/user-guide.md — памятка владельцу; docs/selling.md — что сделать перед продажей
    (лицензия, свой USB VID/PID, программатор с коммерческой лицензией, радио, батарея,
    мемные эмоции); firmware/release/README.md — описание готовых файлов прошивки.
    - Сборка, первое включен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
2026-10-27 Тройное нажатие кнопки — звук вкл/выкл с баннером SOUND ON/OFF
    Без компьютера покупатель не мог выключить пищалку: звук переключался только командой snd
    в консоли. Теперь серия нажатий: одно — «кнопка» для характера, два — дуэли, три — звук
    (решение через 400 мс после последнего отпускания, тройное — сразу). Команда snd делает
    то же самое и показывает тот же баннер. Сценарий симулятора buttons: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
2026-10-28 Плата: метка JLCJLCJLCJLC под ячейкой, третья перемычка панели, защита генераторов, поправки поворотов как подсказка
    - Номер заказа JLCPCB ляжет на метку под ячейкой (опция «Order Number (Specify Position)»),
    а не на видимый через прозрачный корпус оборот.
    - Панель: каждая плата держится ещё и короткой перемычкой на нижнем крае между USB-C и
    правым винтом; вырезы заливок у перемычек, проверка меди после пер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
    [keychain-rev-b-panel.kicad_pcb, keychain-rev-b.kicad_pcb]
2026-10-28 Черновик: промежуточные правки прошивки, движка и корпуса (в работе)
    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
    [case-acrylic-3mm.dxf]
2026-10-28 Документация к выпуску: прототипная и продажная прошивка, проверки до продажи, памятка покупателю
    - firmware/release — только для прототипов (номера Adafruit и Company ID 0xFFFF);
    брелоки на продажу прошивают своей сборкой с [sale] и пересобранным загрузчиком.
    - docs/selling.md: замер звона VBUS, испытания пилотной партии, батарейный регламент ЕС
    (заменяемая ячейка с 18.02.2027), лицензии сторонних компонентов, пасп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
2026-10-28 Готовые файлы прошивки 6ebd420: брелок rev B (заводской hex, UF2, DFU) и стенд на ESP32
    Собраны из чистого коммита 6ebd420: keychain-revb-factory.hex (загрузчик + SoftDevice +
    прошивка + REGOUT0 = 3.3 В), keychain-revb.uf2, keychain-revb-dfu.zip и stand-esp32c5,
    esp32dev, esp32c3, esp32s3; SHA256SUMS. Номера прототипные (USB 239A, Company ID 0xFFFF):
    брелоки на продажу прошивают своей сборкой с [sale] (docs/selling.md). Пока GitHub Actions
    не запускает задачи, это основной источник файлов.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
2026-10-28 Встречи без Company ID: пакет — данные сервиса со своим 128-битным UUID
    Брелоки узнают друг друга по своему случайному UUID (5f4c45b9-ab1b-4dd4-bfea-54bcf4274da6)
    в поле Service Data, а не по номеру компании в данных производителя, который выдаёт
    Bluetooth SIG. Покупать для встреч ничего не нужно. Версия пакета 3, флагов нет (реклама
    без соединения), поле 29 байт из 31. ble_company и FACE_ADV_COMPANY убраны, в [sale]
    остались только USB-номера. Т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
2026-10-28 Готовые файлы прошивки d7b6eee: пакет встреч со своим UUID
    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
2026-10-28 Брелоки — на подарки: без списка «перед продажей», программатор — Raspberry Pi Pico
    - docs/selling.md удалён, ссылки на него убраны. Пометки «файлы release — для прототипов»,
    раздел [sale] и испытания перед продажей оставлены на случай продажи; таблица пилотных
    испытаний перенесена в docs/plan.md (для подарков — по желанию).
    - Основной программатор — Raspberry Pi Pico с прошивкой debugprobe через преобразователь
    уро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
2026-10-28 Switch to open licences: Apache-2.0 code, CERN-OHL-W-2.0 hardware, CC-BY-4.0 docs
    English README with Russian copy in README.ru.md, trademark policy,
    third-party notices and REUSE metadata. Drops the non-commercial
    licence and COMMERCIAL.md.
    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
2026-10-28 Stand: real BLE encounters on ESP32 via NimBLE/Bluedroid
    Same connectionless UUID Service Data adverts and passive scanning as
    the rev B keychain, driven by face::Encounters. New radio, duels and
    ghost commands; esp32dev moves to huge_app partitions to fit Bluedroid.
    Host stand test exchanges packets with a virtual keychain.
    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
2026-10-28 English names, bilingual web sim, GitHub Pages and web flasher
    Engine gets English names for emotions, scenes, temperaments,
    achievements and behaviour reasons (default stays Russian), facegen
    --lang en writes docs/emotions.en.md, the web sim gets an EN/RU switch
    (EN default), and CI deploys the sim plus an ESP Web Tools flasher to
    GitHub Pages once the repo is public. Removes stray screenshots.
    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
