olerast67/emotion-keychain/(notices)

Notices in the files:
README.md:
Hardware: CERN-OHL-W-2.0
Docs: CC-BY-4.0
